wyolum/halo/README.md

# halo
Desktop Edge-lit portrait stand.
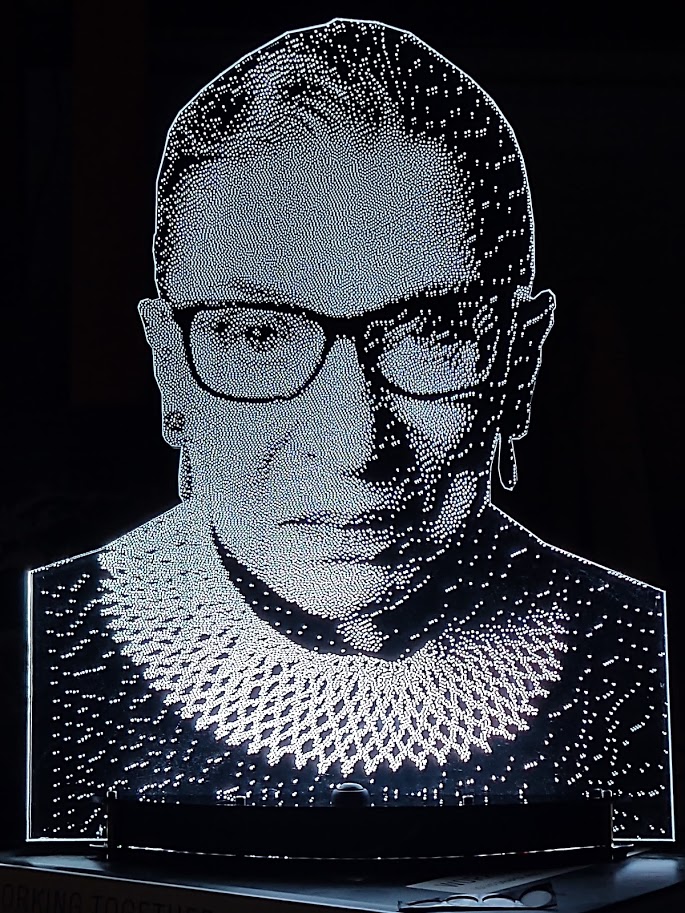
[picture p1: data/IMG_20200928_210512119.jpg]
Image of Halo

[Instructions:](https://wyolum.com/how-to-edge-lit-portrait-work-in-progress/)
