wyolum/halo/data/BARREL_JACK_1811141816_XKB-Connectivity-DC-005-5A-2-5-SMT_C319133.pdf

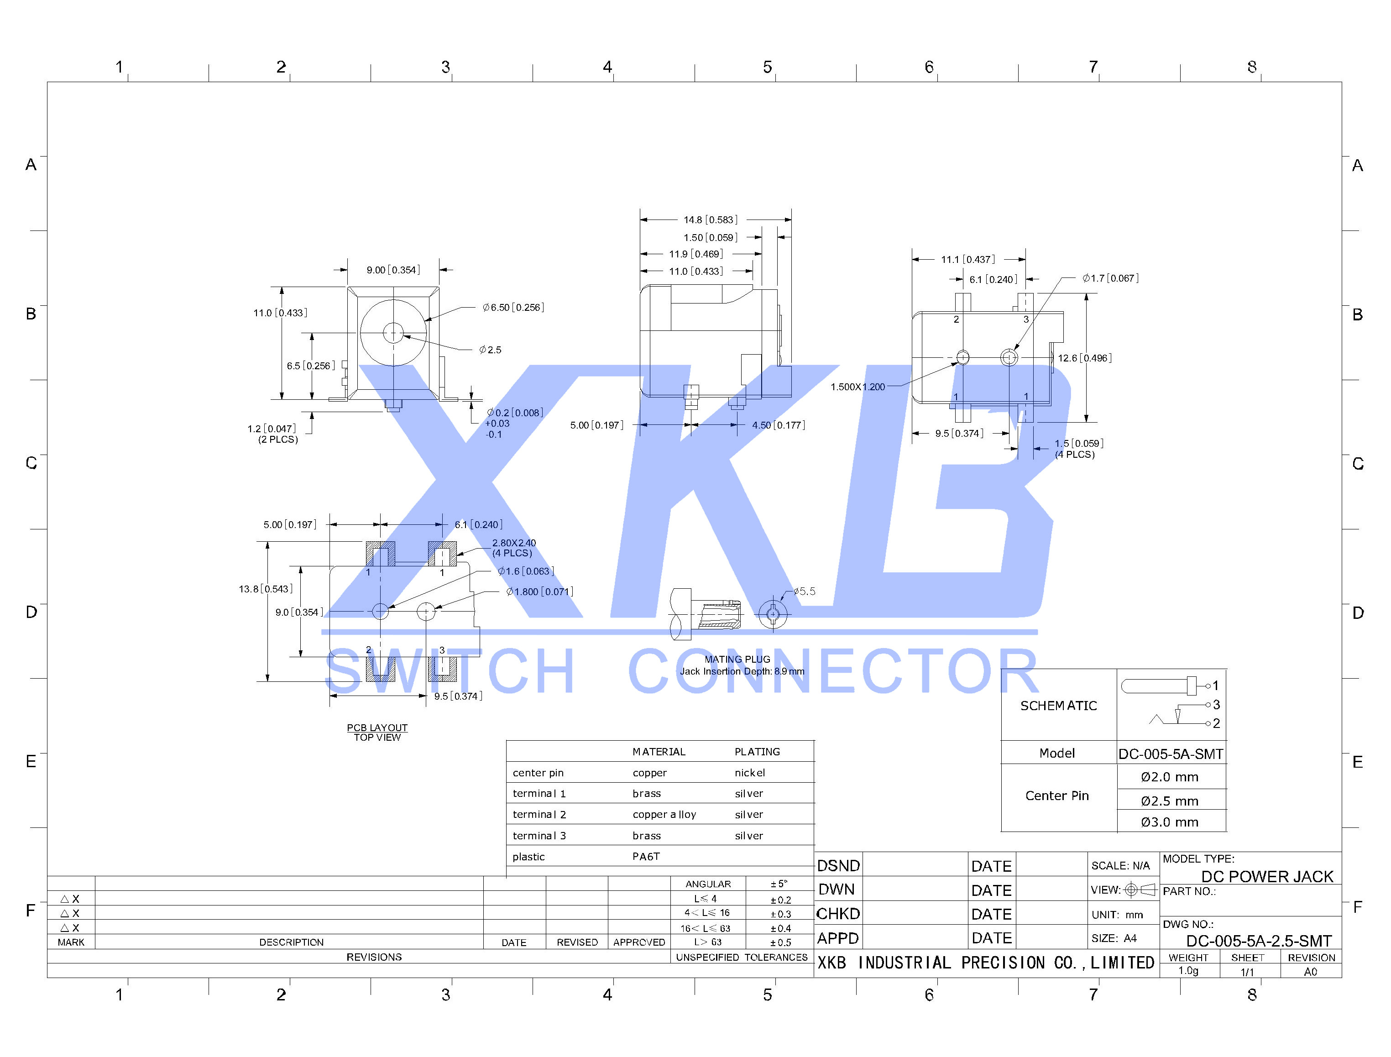
[picture p2: page 1]
