wyolum/halo/data/USB_C_2002271815_XKB-Connectivity-U262-241N-4BV64_C388660.pdf

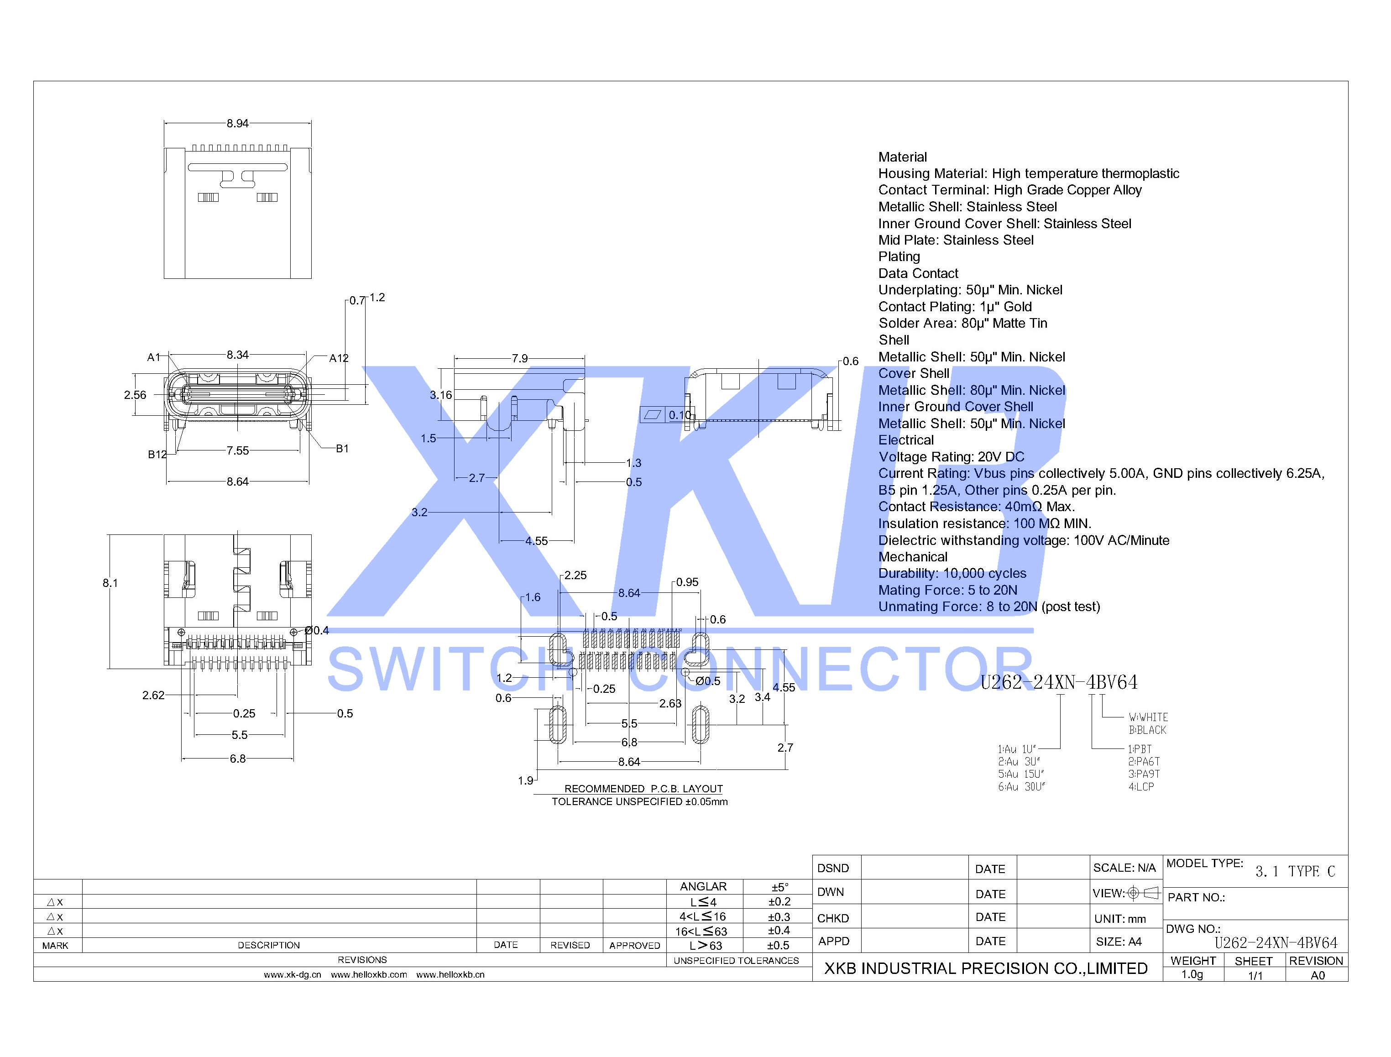
[picture p3: page 1]
