wyolum/halo/images/IMG_20200927_095507180_HDR.jpg

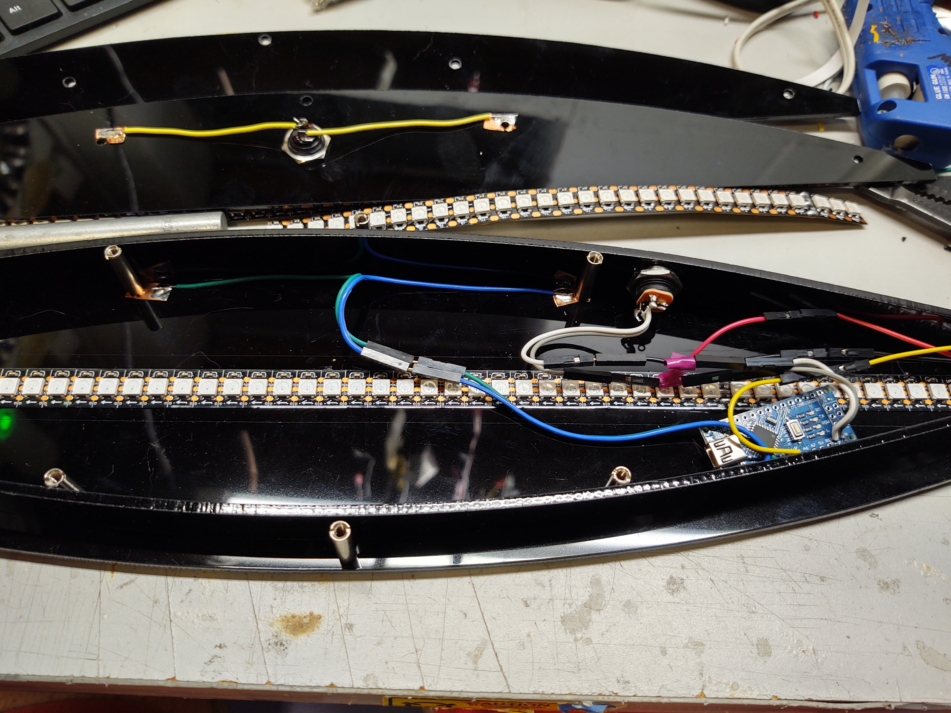
images/IMG_20200927_095507180_HDR.jpg
