wyolum/halo/images/IMG_20200927_095513719.jpg

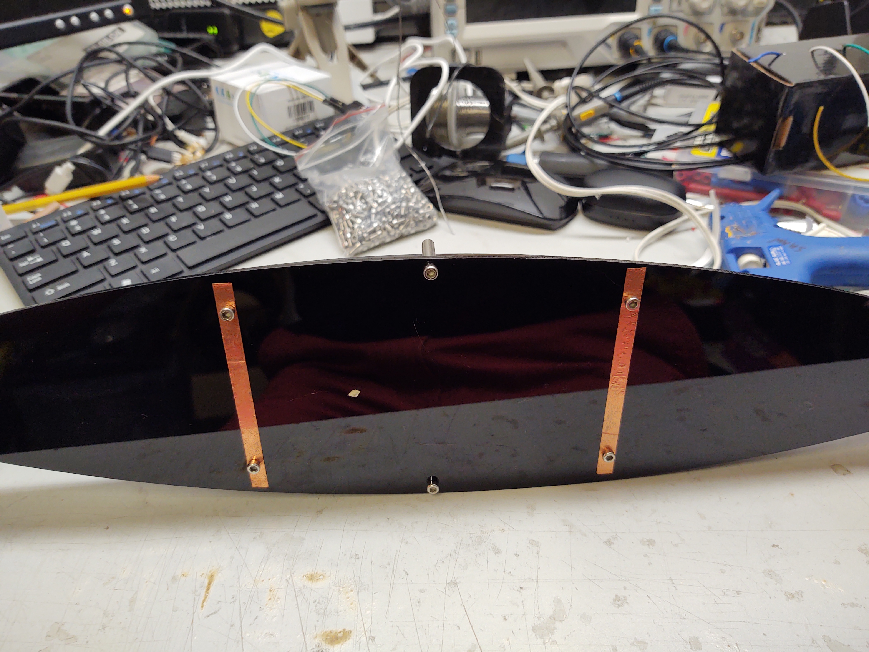
images/IMG_20200927_095513719.jpg
