wyolum/halo/images/IMG_20200927_095514592.jpg

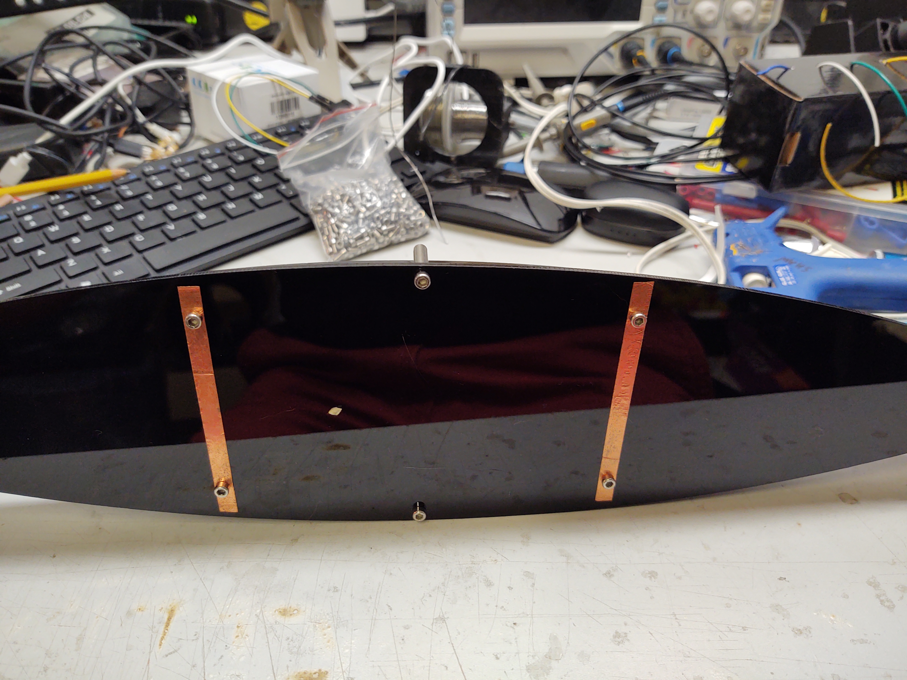
images/IMG_20200927_095514592.jpg
