wyolum/halo/images/IMG_20200927_181427206_HDR.jpg

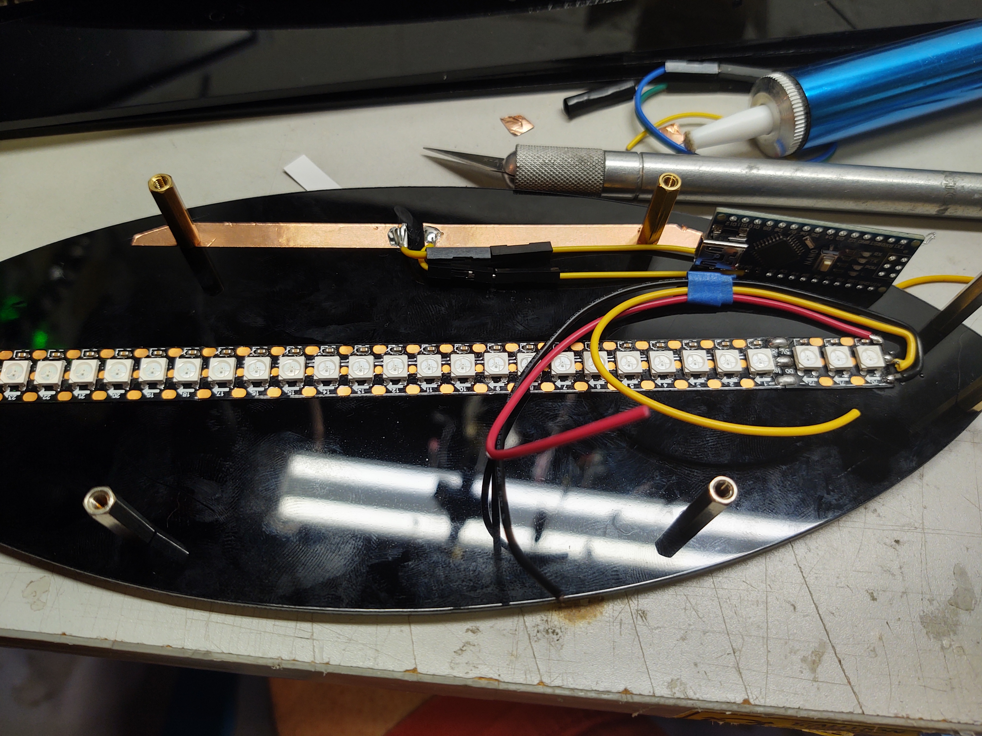
images/IMG_20200927_181427206_HDR.jpg
