wyolum/halo/images/IMG_20200927_194747053_HDR.jpg

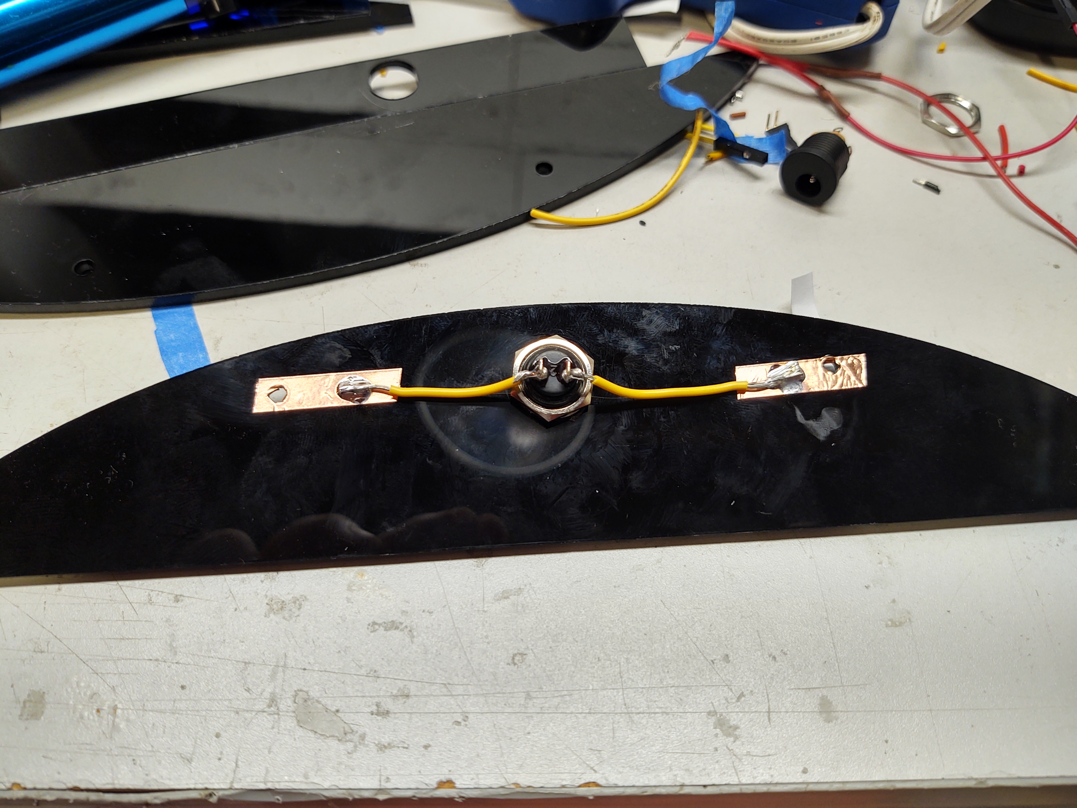
images/IMG_20200927_194747053_HDR.jpg
