wyolum/halo/images/IMG_20201009_095709288_HDR.jpg

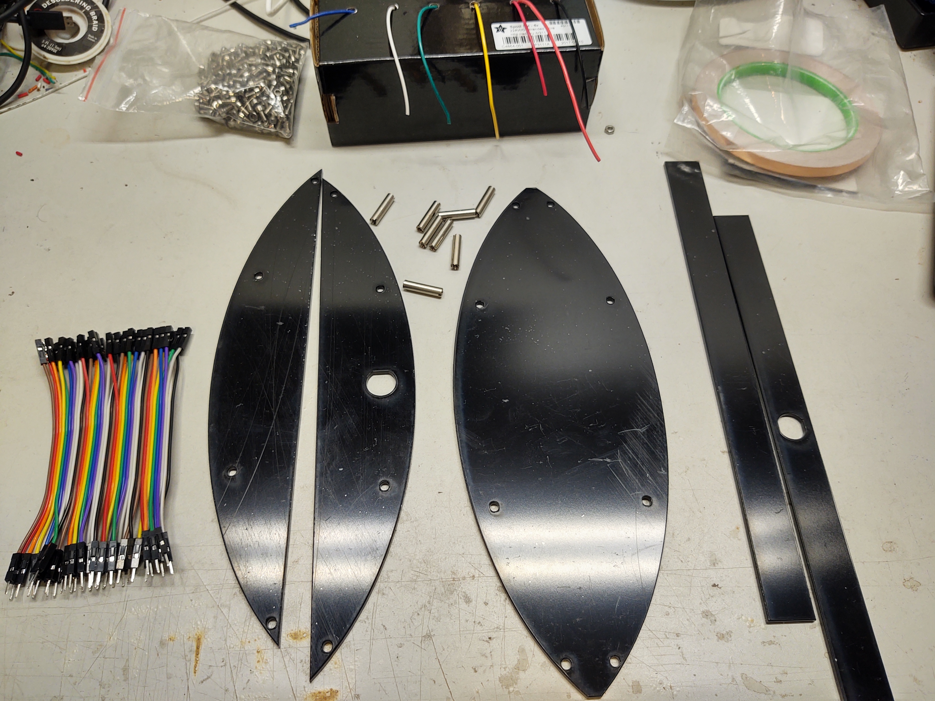
images/IMG_20201009_095709288_HDR.jpg
