wyolum/halo/images/IMG_20201009_100527796_HDR.jpg

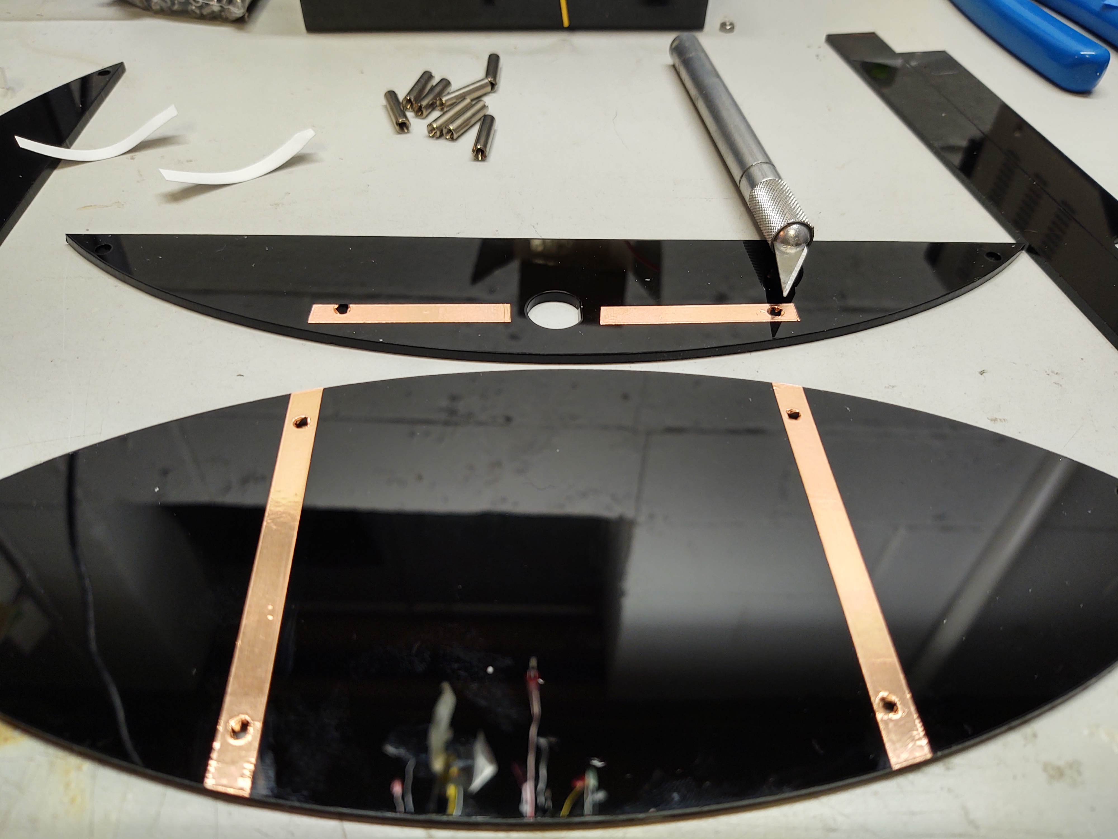
images/IMG_20201009_100527796_HDR.jpg
