wyolum/halo/images/IMG_20201009_101521324_HDR.jpg

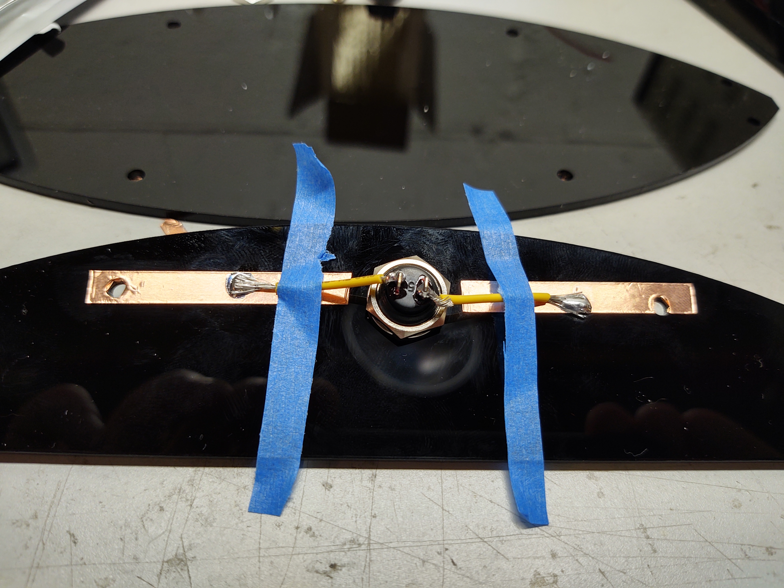
images/IMG_20201009_101521324_HDR.jpg
