wyolum/halo/images/IMG_20201009_102646859.jpg

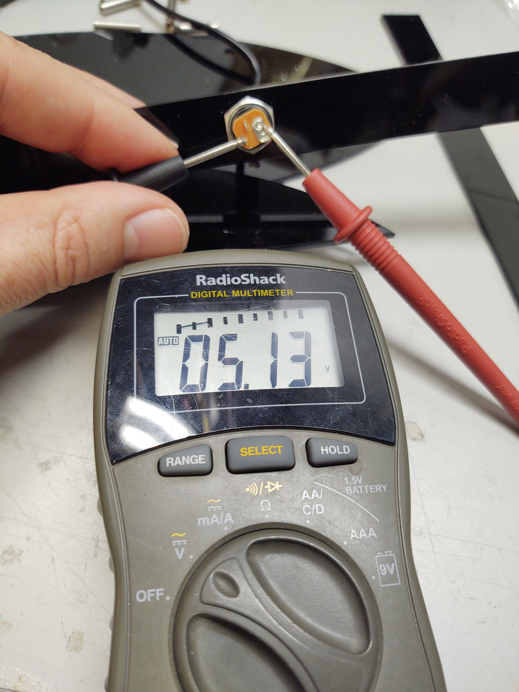
images/IMG_20201009_102646859.jpg
