wyolum/halo/images/IMG_20201009_103726629_HDR.jpg

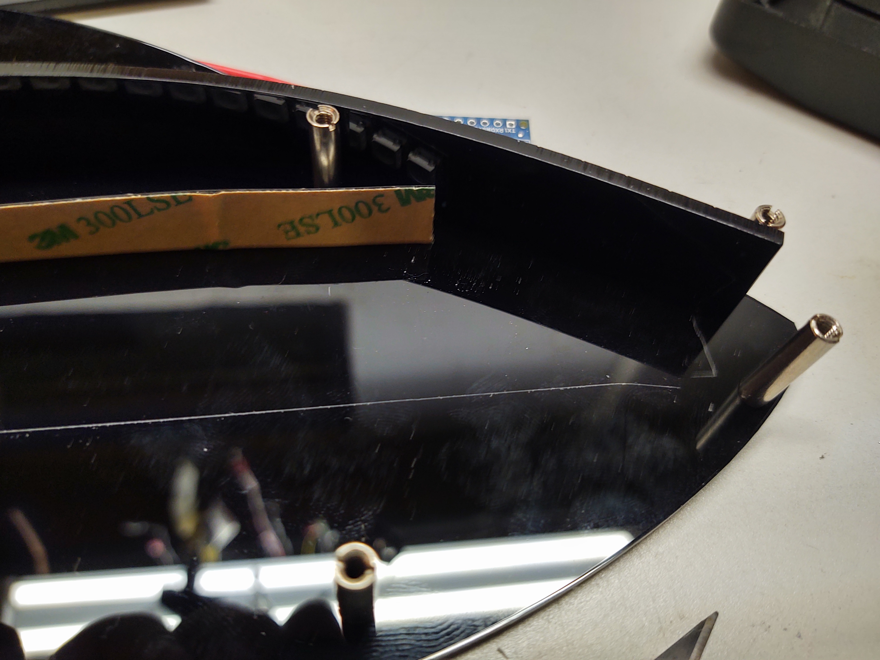
images/IMG_20201009_103726629_HDR.jpg
