wyolum/halo/images/IMG_20201009_103839048_HDR.jpg

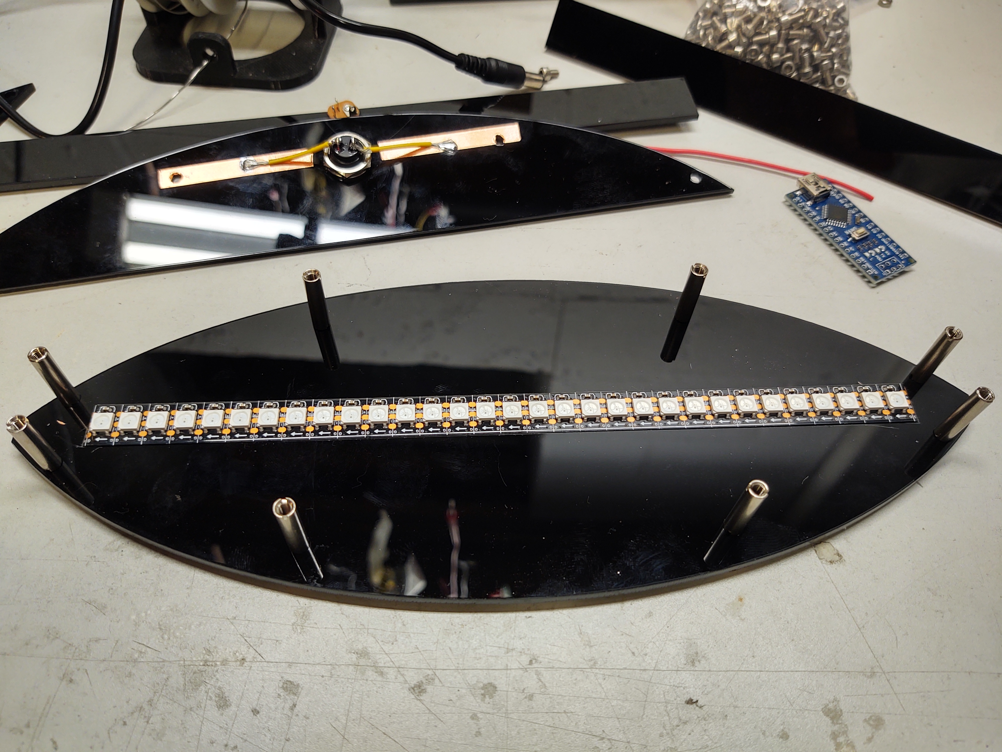
images/IMG_20201009_103839048_HDR.jpg
