wyolum/halo/images/IMG_20201009_105753147_HDR.jpg

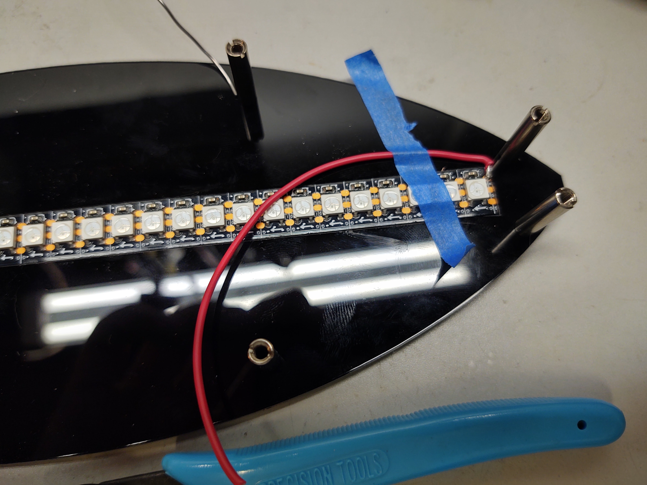
images/IMG_20201009_105753147_HDR.jpg
