wyolum/halo/images/IMG_20201009_110624503_HDR.jpg

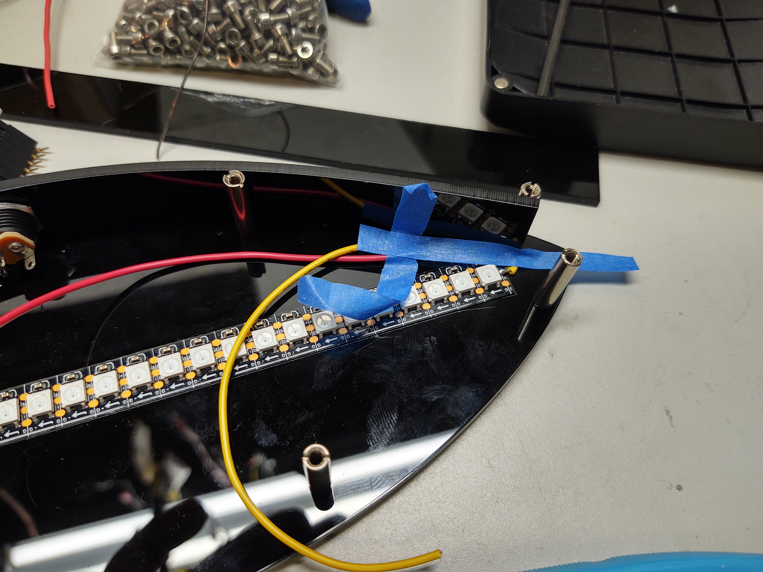
images/IMG_20201009_110624503_HDR.jpg
