wyolum/halo/images/IMG_20201009_110908093_HDR.jpg

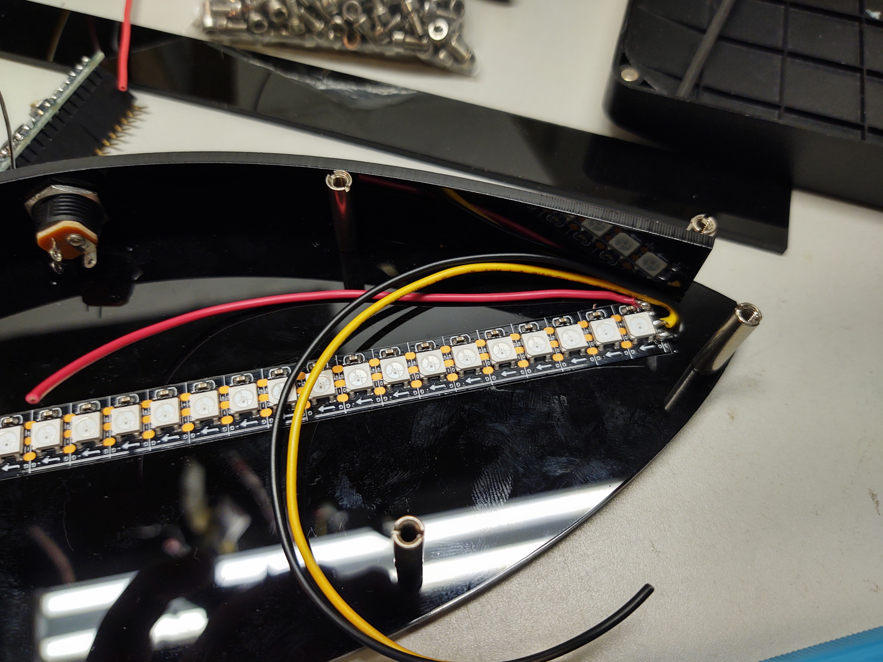
images/IMG_20201009_110908093_HDR.jpg
