wyolum/halo/images/IMG_20201009_114156640_HDR.jpg

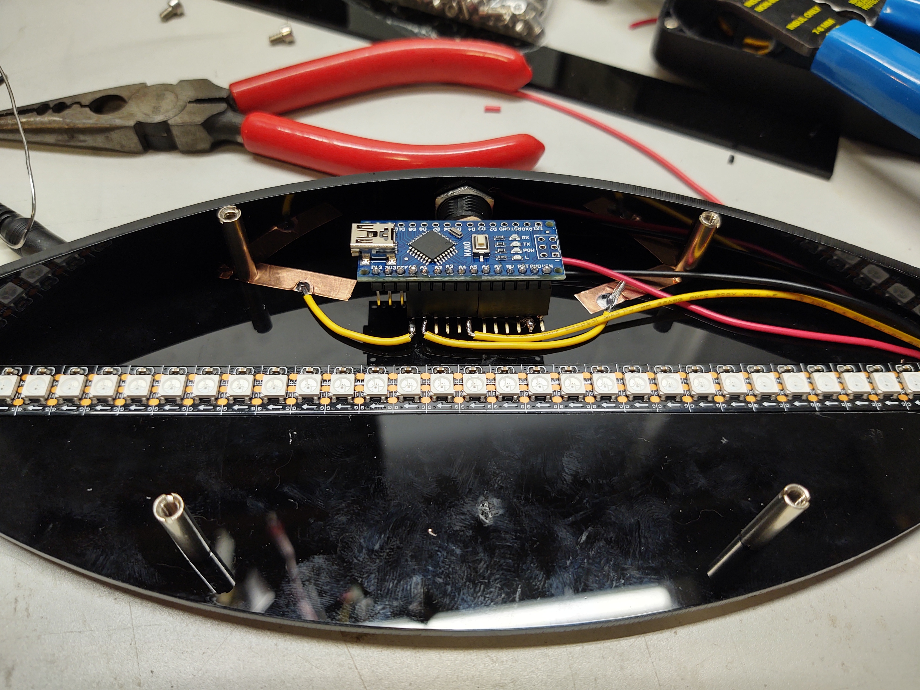
images/IMG_20201009_114156640_HDR.jpg
