wyolum/halo/images/IMG_20201009_114411816_HDR.jpg

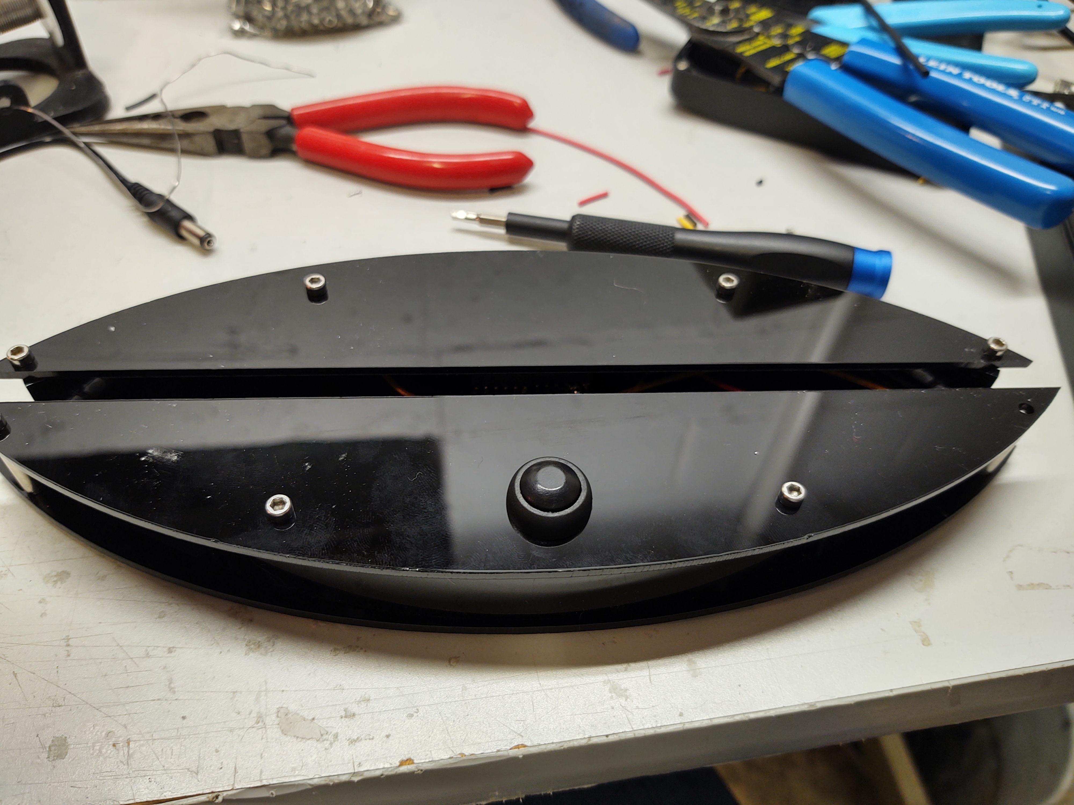
images/IMG_20201009_114411816_HDR.jpg
