wyolum/halo/images/IMG_20201009_115341393.jpg

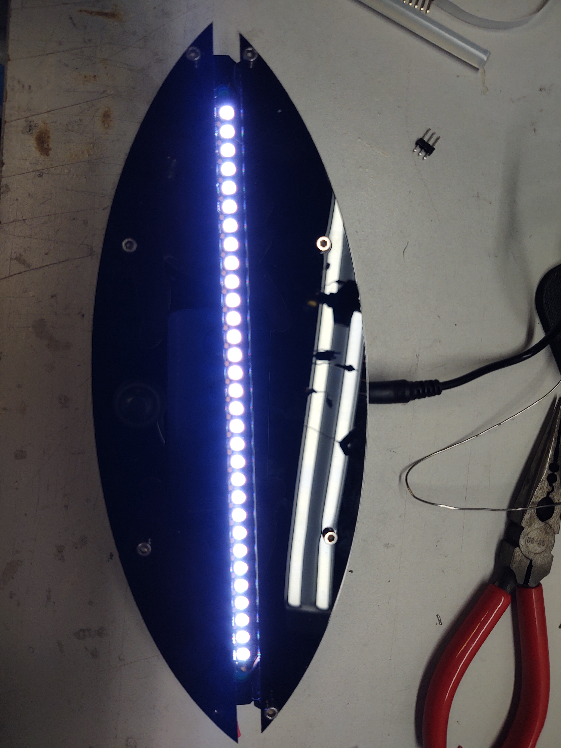
images/IMG_20201009_115341393.jpg
