wyolum/halo/images/IMG_20201009_145817242.jpg

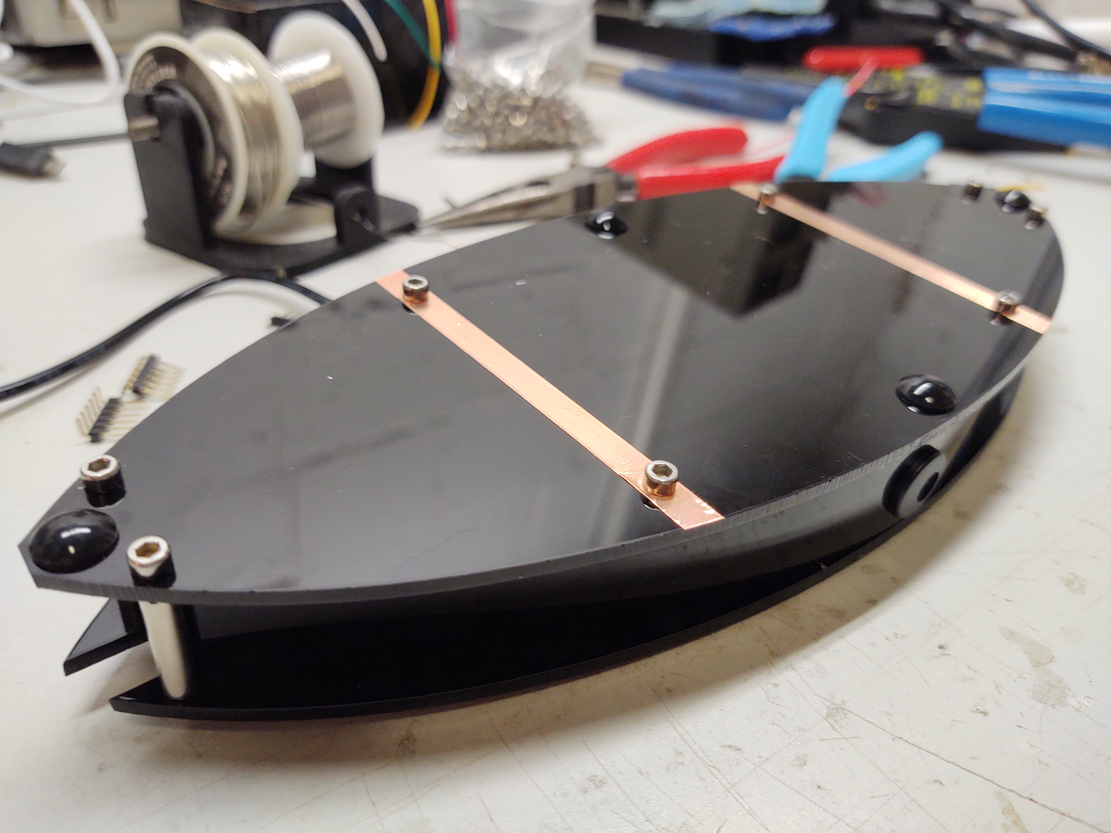
images/IMG_20201009_145817242.jpg
