wyolum/halo/images/IMG_20201009_145818878.jpg

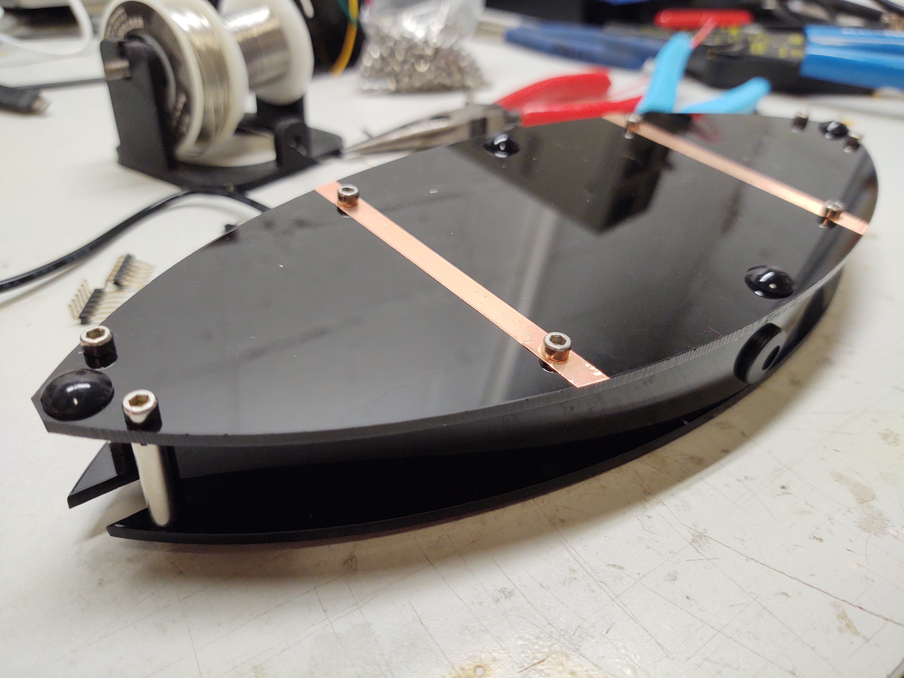
images/IMG_20201009_145818878.jpg
