wyolum/halo/images/IMG_20201010_164702471_HDR.jpg

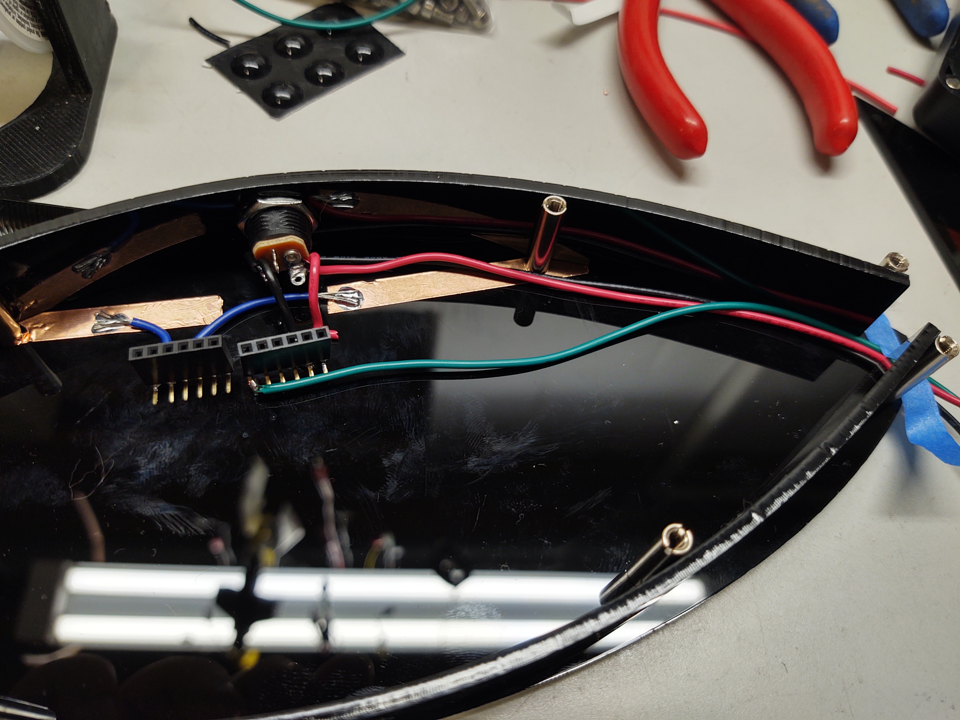
images/IMG_20201010_164702471_HDR.jpg
