wyolum/halo/images/IMG_20201010_165921804_HDR.jpg

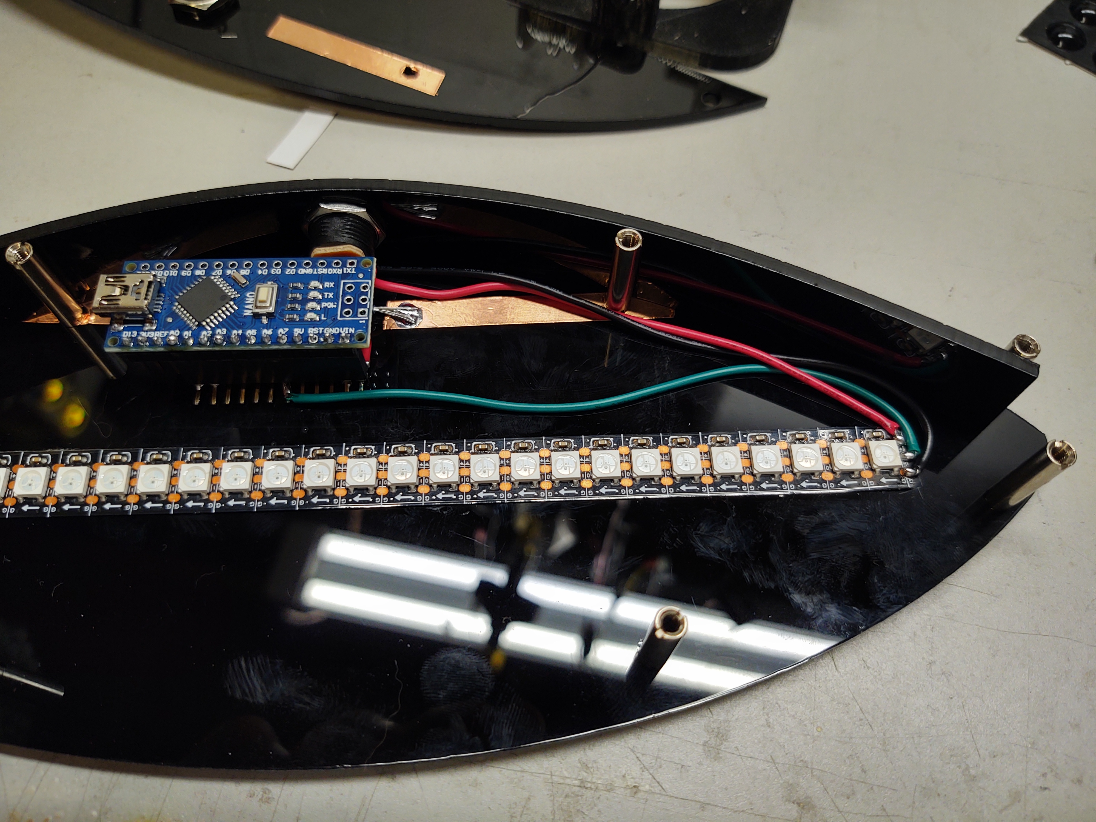
images/IMG_20201010_165921804_HDR.jpg
