wyolum/halo/images/PXL_20200929_154809385.jpg

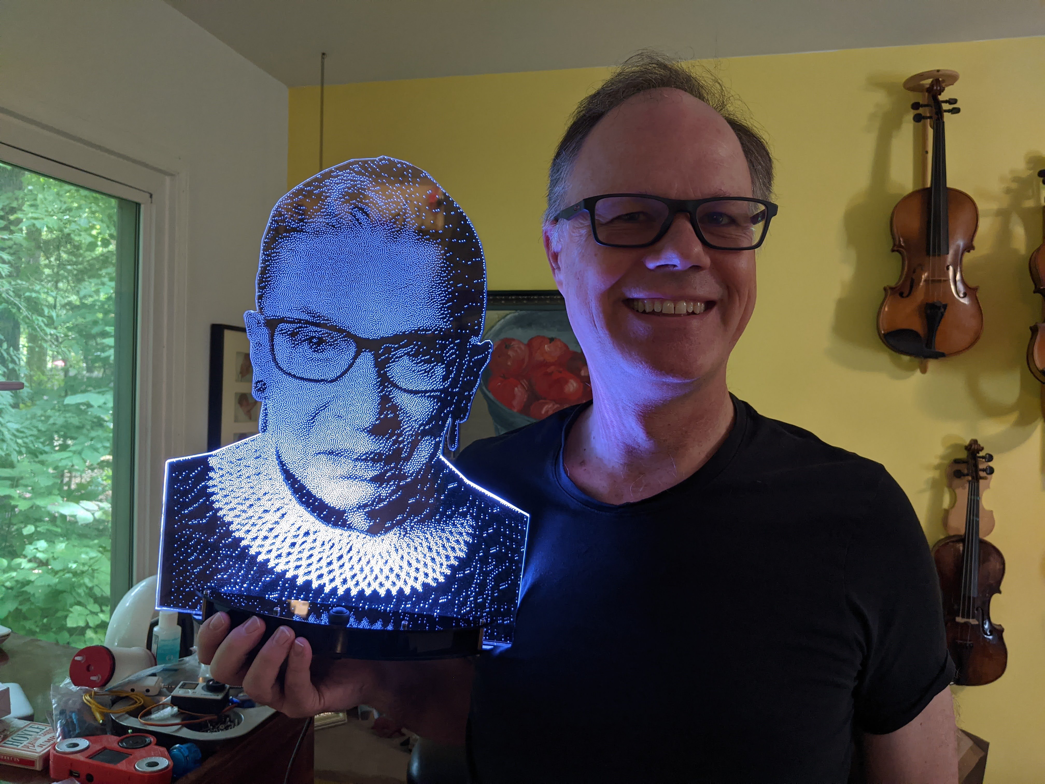
images/PXL_20200929_154809385.jpg
