wyolum/halo/kicad_v3/renders/halo_v2_01.png

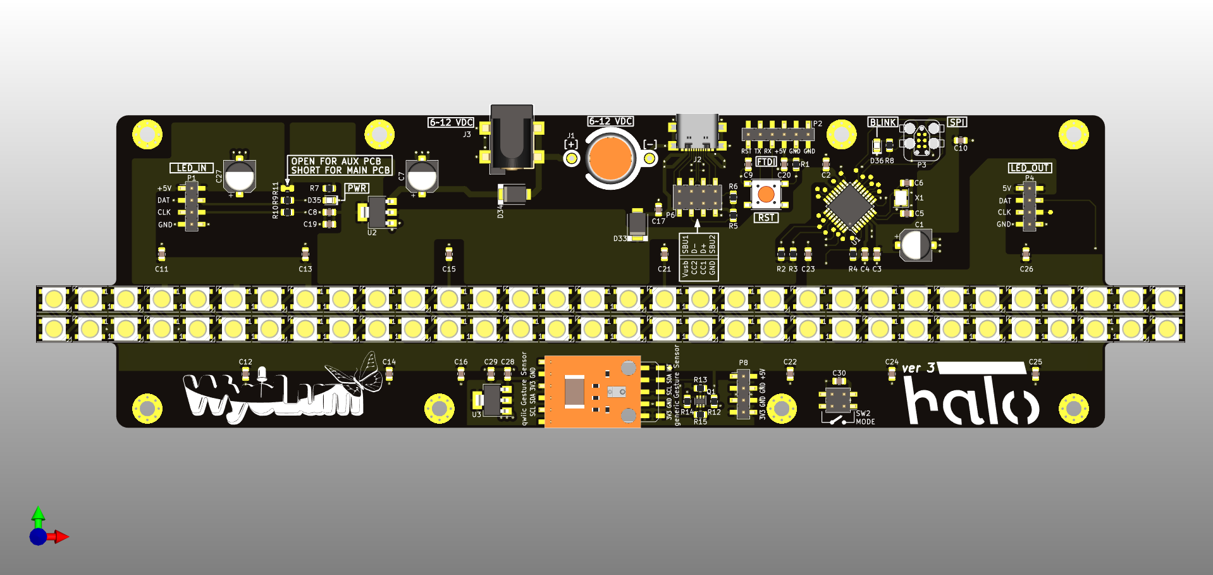
kicad_v3/renders/halo_v2_01.png
