wyolum/halo/kicad_v3/renders/halo_v2_03.png

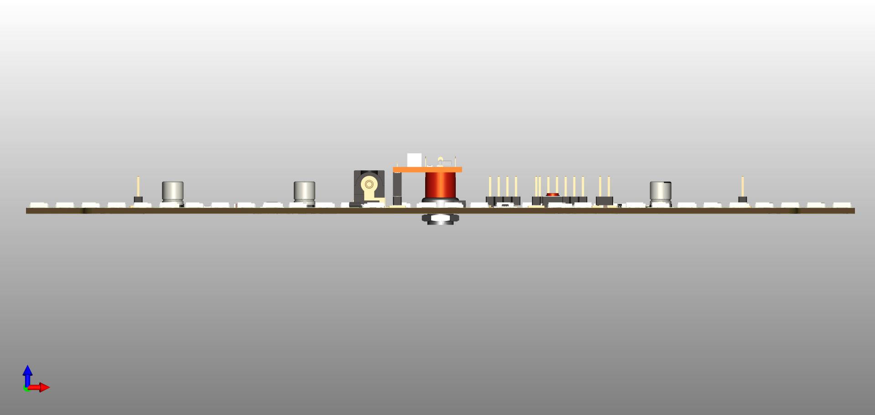
kicad_v3/renders/halo_v2_03.png
