wyolum/halo/kicad_v3/renders/halo_v2_04.png

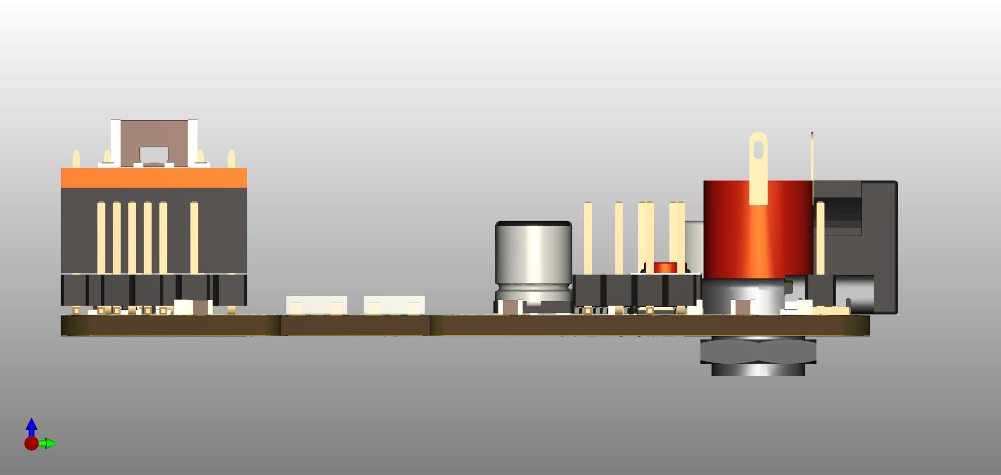
kicad_v3/renders/halo_v2_04.png
