wyolum/halo/kicad_v3/renders/halo_v2_07.png

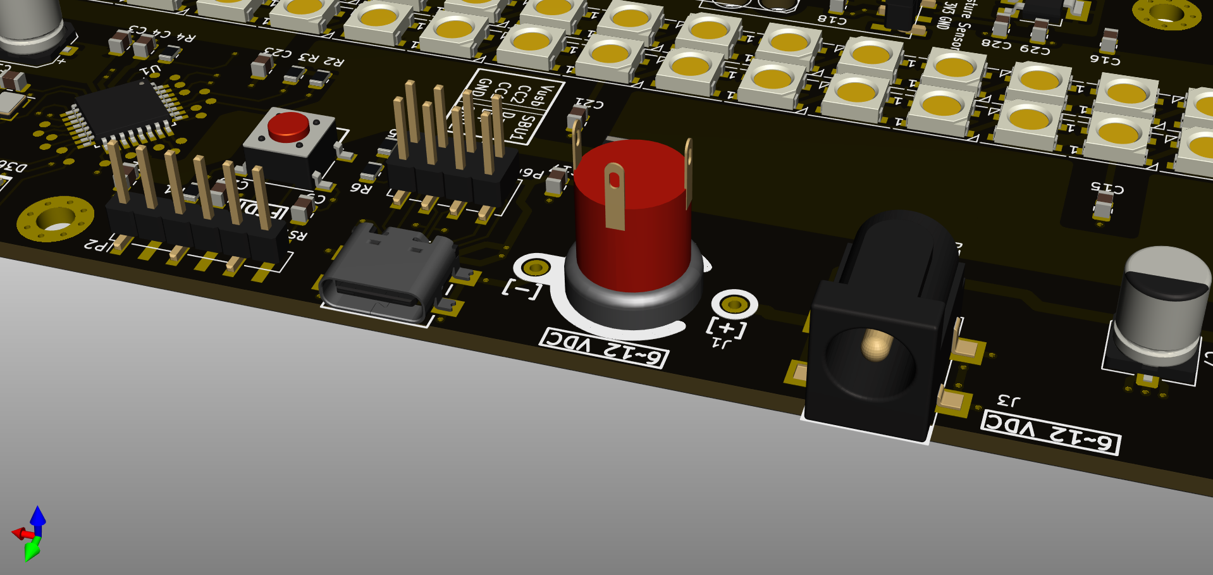
kicad_v3/renders/halo_v2_07.png
