wyolum/halo/kicad_v3/renders/halo_v2_08.png

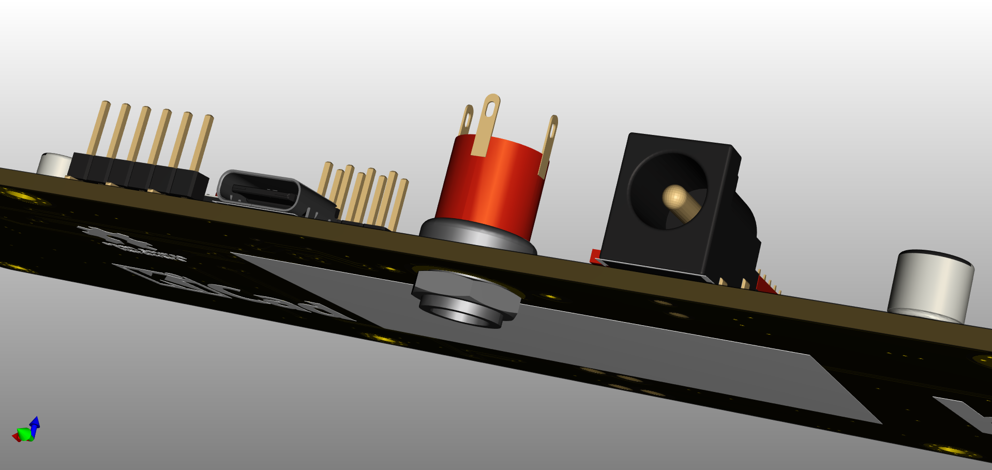
kicad_v3/renders/halo_v2_08.png
