wyolum/halo/kicad_v3/halo_v3_BoM.xlsx

Id | Comment | Designator | Footprint | LCSC Part # | Supplier Ref | Quantity
1 | 100uF ±20% 35V SMD,6.3x7.7mm Aluminum Electrolytic Capacitors - SMD RoHS | C1, C7, C27 | SMD,6.3x7.7mm | C176666 (https://lcsc.com/product-detail/Aluminum-Electrolytic-Capacitors-SMD_Lelon-VEJ101M1VTR-0607_C176666.html) | VEJ101M1VTR-0607 | 3
2 | 100nF ±10% 50V X7R 0805 Multilayer Ceramic Capacitors MLCC - SMD/SMT RoHS | C2, C9, C10, C11, C12, C13, C14, C15, C16, C17, C18, C19, C20, C21, C22, C23, C24, C25, C26, C28, C29, C30 | C_0805_2012Metric | C49678 (https://lcsc.com/product-detail/Multilayer-Ceramic-Capacitors-MLCC-SMD-SMT_100nF-104-10-50V_C49678.html/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) | CC0805KRX7R9BB104 | 22
3 | 1uF ±10% 50V X7R 0805 Multilayer Ceramic Capacitors MLCC - SMD/SMT RoHS | C3, C4, C8 | C_0805_2012Metric | C28323 (https://lcsc.com/product-detail/Multilayer-Ceramic-Capacitors-MLCC-SMD-SMT_SAMSUNG_CL21B105KBFNNNE_1uF-105-10-50V_C28323.html/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) | CL21B105KBFNNNE | 3
4 | 20pF ±5% 50V C0G 0805 Multilayer Ceramic Capacitors MLCC - SMD/SMT RoHS | C5, C6 | C_0805_2012Metric | C1798 (https://lcsc.com/product-detail/Multilayer-Ceramic-Capacitors-MLCC-SMD-SMT_SAMSUNG_CL21C200JBANNNC_20pF-200-5-50V_C1798.html/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) | CL21C200JBANNNC | 2
5 | RGB 620~630nmRed,515~530nmGreen,465~475nmBlue SMD,5x5mm Light Emitting Diodes (LED) RoHS | D1-32, D37-68 | PLCC4_5.0x5.0mm_P3.2mm | C114586 (https://lcsc.com/product-detail/Light-Emitting-Diodes-LED_5050-RGBIntegrated-Light-4Pin_C114586.html) | WS2812B-B | 64
6 | 40V 2A 430mV @ 2A SMB(DO-214AA) Schottky Barrier Diodes (SBD) RoHS | D33, D34 | SMB (DO-214AA) | C8165 (https://lcsc.com/product-detail/Schottky-Barrier-Diodes-SBD_ON-Semicon_MBRS240LT3G_ON-Semicon-ON-MBRS240LT3G_C8165.html/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) | MBRS240LT3G | 2
7 | Yellow 592~594nm 0805 Light Emitting Diodes (LED) RoHS | D35, D36 | 0805_2012Metric | C2296 (https://lcsc.com/product-detail/Light-Emitting-Diodes-LED_Yellow-light-0805-Highlighted_C2296.html/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) | 17-21SUYC/TR8 | 2
8 | MOSFET 2 N CHANNEL(DUAL) 60V 230MA 2V @ 250UA 7.5 ? @ 50MA,5V SOT-363 ROHS | Q1 | SOT-363 | C83571 (https://lcsc.com/product-detail/MOSFET_Diodes-Incorporated_2N7002DW-7-F_Diodes-Incorporated-2N7002DW-7-F_C83571.html/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) | 2N7002DW-7-F | 1
9 | 10kΩ ±1% 0.125W ±100ppm/℃ 0805 Chip Resistor - Surface Mount RoHS | R1, R2, R3, R4, R12, R13, R14, R15 | 0805_2012Metric | C17414 (https://lcsc.com/product-detail/Chip-Resistor-Surface-Mount_Uniroyal-Elec-0805W8F1002T5E_C17414.html/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) | 0805W8F1002T5E | 8
10 | 5.11kΩ ±1% 0.125W ±100ppm/℃ 0805 Chip Resistor - Surface Mount RoHS | R5, R6 | 0805_2012Metric | C46039 (https://lcsc.com/product-detail/Chip-Resistor-Surface-Mount_Uniroyal-Elec-0805W8F5111T5E_C46039.html/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) | 0805W8F5111T5E | 2
11 | 1kΩ ±1% 0.125W ±100ppm/℃ 0805 Chip Resistor - Surface Mount RoHS | R7, R8 | 0805_2012Metric | C17513 (https://lcsc.com/product-detail/Chip-Resistor-Surface-Mount_Uniroyal-Elec-0805W8F1001T5E_C17513.html/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) | 0805W8F1001T5E | 2
12 | 220Ω ±1% 0.125W ±100ppm/℃ 0805 Chip Resistor - Surface Mount RoHS | R9, R10 | 0805_2012Metric | C17557 (https://lcsc.com/product-detail/Chip-Resistor-Surface-Mount_Uniroyal-Elec-0805W8F2200T5E_C17557.html/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) | 0805W8F2200T5E | 2
13 | SPST 50mA @ 50VDC Vertical Round Button SMD,6x6mm Tactile Switches RoHS | SW1 | SMD, 6x6mm, H9.5mm | C273519 (https://lcsc.com/product-detail/Tactile-Switches_E-Switch-TL3301AF160QG_C273519.html/?href=jlc-SMT) | TL3301AF160QG | 1
14 | 8-Bit FLASH AVR 20MHz 1.8V ~ 5.5V TQFP-32_7x7x08P ATMEL & AVR RoHS | U1 | TQFP-32_7x7x08P | C14877 (https://lcsc.com/product-detail/ATMEL-AVR_ATMEL_ATMEGA328P-AU_ATMEGA328P-AU_C14877.html/?href=jlc-SMT) | ATMEGA328P-AU | 1
15 | LOW DROPOUT REGULATORS(LDO) POSITIVE FIXED 1.3V @ 1A 15V 5V 1A SOT-223 ROHS | U2 | SOT-223 | C6187 (https://lcsc.com/product-detail/Low-Dropout-Regulators-LDO_AMS_AMS1117-5-0_AMS1117-5-0_C6187.html/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) | AMS1117-5.0 | 1
16 | LOW DROPOUT REGULATORS(LDO) POSITIVE FIXED 1.3V @ 800MA 15V 3.3V 1A SOT-223 ROHS | U3 | SOT-223 | C6186 (https://lcsc.com/product-detail/Low-Dropout-Regulators-LDO_AMS_AMS1117-3-3_AMS1117-3-3_C6186.html/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) | AMS1117-3.3 | 1
17 | 16MHz ±10ppm 9pF 60Ω SMD-3225_4P SMD Crystal Resonators RoHS | X1 | SMD-3225_4P | C13738 (https://lcsc.com/product-detail/SMD-Crystal-Resonators_Yangxing-Tech-X322516MLB4SI_C13738.html/?href=jlc-SMT) | X322516MLB4SI | 1
 | DIGIKEY PARTS
1 | Power Barrel Connector Jack 2.10mm ID (0.083"), 5.50mm OD (0.217") Chassis Mount | J1 | Panel mount | EJ501A-ND (https://www.digikey.com/en/products/detail/mpd-memory-protection-devices/EJ501A/2439531) | EJ501A | 1
2 | CONN USB 2.0 TYPE-C R/A SMT | J2 | SMD, right angle | 2073-USB4110-GF-A-1-ND (https://www.digikey.com/en/products/detail/gct/USB4110-GF-A/10384547) | USB4110-GF-A | 1
3 | Power Barrel Connector Jack 2.10mm ID (0.083"), 5.50mm OD (0.217") Surface Mount, Right Angle | J3 | Through hole barrel jack | 839-54-00164CT-ND (https://www.digikey.com/en/products/detail/tensility-international-corp/54-00164/10459298) | 54-00164 | 1
4 | Connector Header Surface Mount 4 position 0.100" (2.54mm) | P1, P4, P8 | PIN HEADER, SMT, SINGLE ROW, 0.10 | 1849-PM20204VBNN-ND (https://www.digikey.com/en/products/detail/metz-connect-usa-inc/PM20204VBNN/12342877) | PM20204VBNN | 3
5 | Connector Header Surface Mount 6 position 0.100" (2.54mm) | P2, P5 | CONN HEADER SMD 6POS 2.54MM | 609-10129380-906002ALFCT-ND (https://www.digikey.com/en/products/detail/amphenol-icc-fci/10129380-906002ALF/7916047) | 10129380-906002ALF | 2
6 | Connector Header Surface Mount 8 position 0.100" (2.54mm) | P6 | CONN HEADER SMD 8POS 2.54MM | 952-3262-ND (https://www.digikey.com/en/products/detail/harwin-inc/M20-8770842/3920090) | M20-8770842 | 1
7 | Connector Header Surface Mount 5 position 0.100" (2.54mm) | P7 | CONN HEADER SMD 5POS 2.54MM | 609-54201-S08-05ALFCT-ND (https://www.digikey.com/en/products/detail/amphenol-icc-fci/54201-S08-05ALF/5201157) | 54201-S08-05ALF | 1
8 | Connector Header Surface Mount 4 position 0.100" (2.54mm) | SW2 | CONN HEADER SMD 4POS 2.54MM | 952-3254-ND (https://www.digikey.com/en/products/detail/harwin-inc/M20-8760242/3919920) | M20-8760242 | 1
