wyolum/halo/fabricate_v2/laser_3D_files/ACR_main_2D.dxf

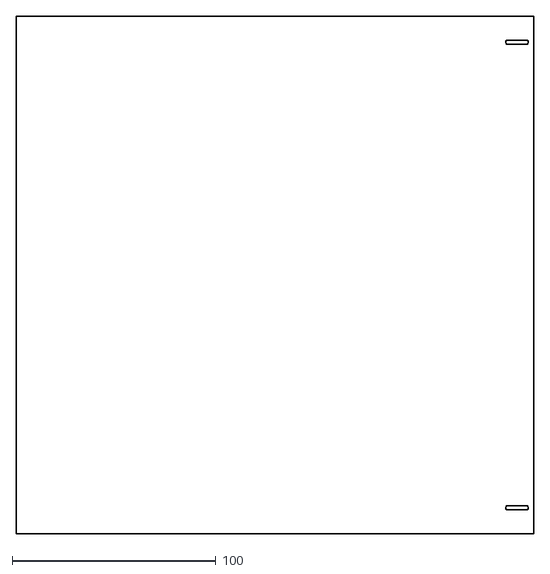
[picture p35: CAD file, 2021-02-07]
fabricate_v2/laser_3D_files/ACR_main_2D.dxf
254.0 x 254.0
