wyolum/halo/data/conn_barrel_50-00616.step

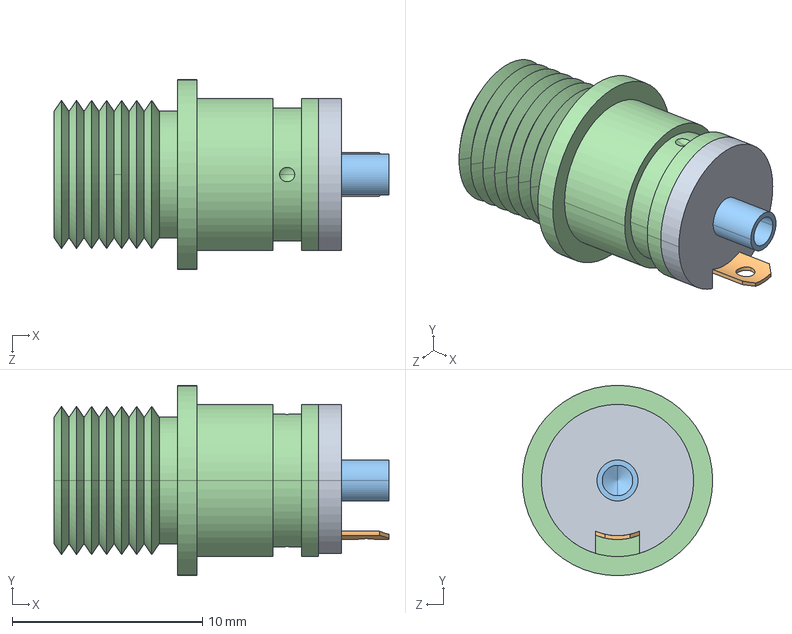
[picture p36: CAD file, 2020-12-13]
data/conn_barrel_50-00616.step
17.6 x 10.00 x 10.00 mm
50-00616 insulator
50-00616 ground terminal
50-00616 center terminal
50-00616 shell
