wyolum/halo/data/CUI_DEVICES_PJ-065B/CUI_DEVICES_PJ-065B.step

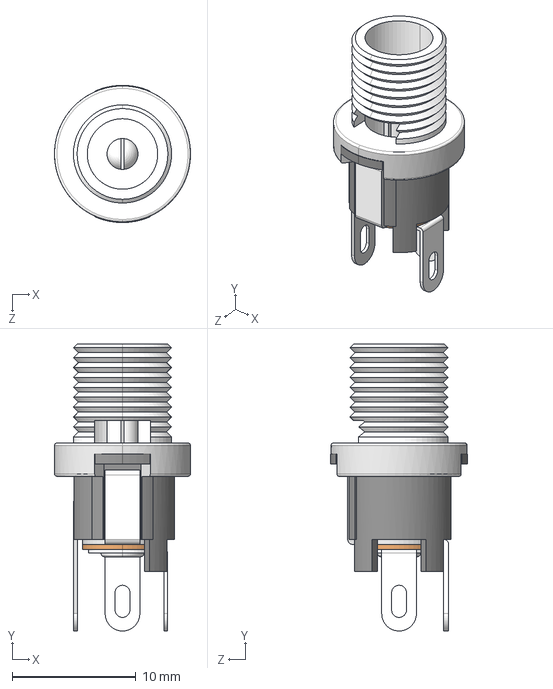
[picture p37: CAD file, 2020-12-13]
data/CUI_DEVICES_PJ-065B/CUI_DEVICES_PJ-065B.step
11.0 x 23.2 x 11.1 mm
