wyolum/halo/data/JAE_connectors/K3D-DX07S024JA1-V3-S/K3D-DX07S024JA1-V3_JAE_Proprietary.STEP

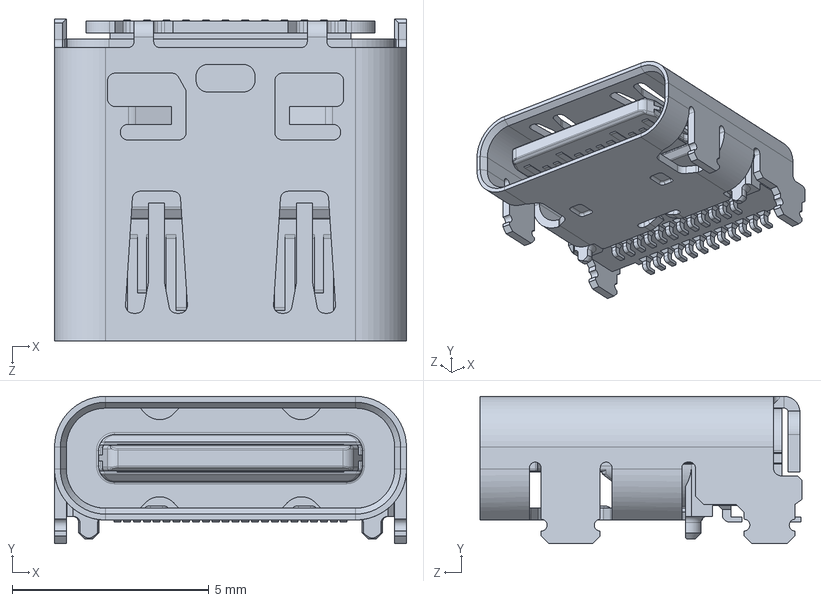
[picture p38: CAD file, 2020-11-03]
data/JAE_connectors/K3D-DX07S024JA1-V3-S/K3D-DX07S024JA1-V3_JAE_Proprietary.STEP
8.94 x 3.74 x 8.17 mm
