wyolum/halo/data/JAE_connectors/K3D-DX07S024JA2-V1_S/K3D-DX07S024JA2-V1_JAE_Proprietary.STEP

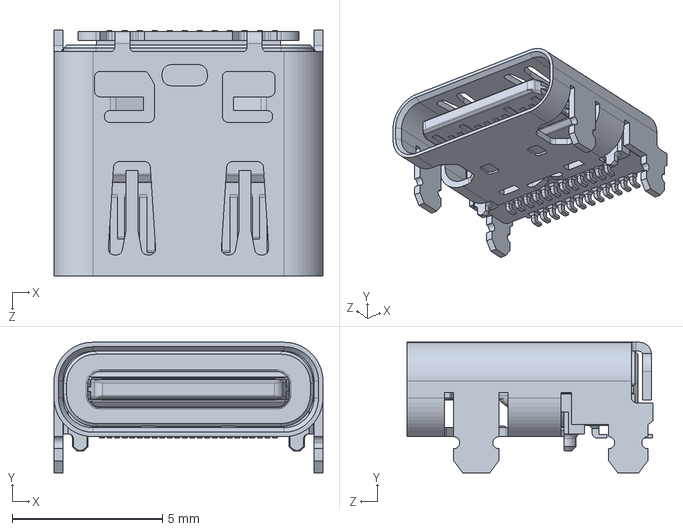
[picture p39: CAD file, 2020-11-03]
data/JAE_connectors/K3D-DX07S024JA2-V1_S/K3D-DX07S024JA2-V1_JAE_Proprietary.STEP
8.94 x 4.34 x 8.17 mm
