wyolum/halo/data/JAE_connectors/K3D-DX07S024JJ4-V1-S/K3D-DX07S024JJ4-V1_JAE_Proprietary.STEP

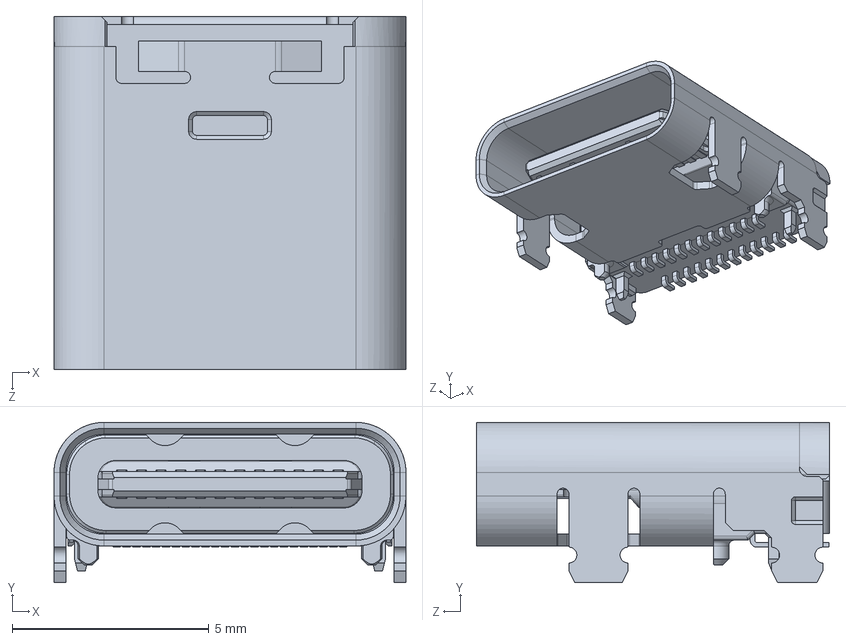
[picture p43: CAD file, 2020-11-03]
data/JAE_connectors/K3D-DX07S024JJ4-V1-S/K3D-DX07S024JJ4-V1_JAE_Proprietary.STEP
8.94 x 4.07 x 8.97 mm
