wyolum/halo/data/JAE_connectors/K3D-DX07S024JJ7-V1-S/K3D-DX07S024JJ7-V1_JAE_Proprietary.STEP

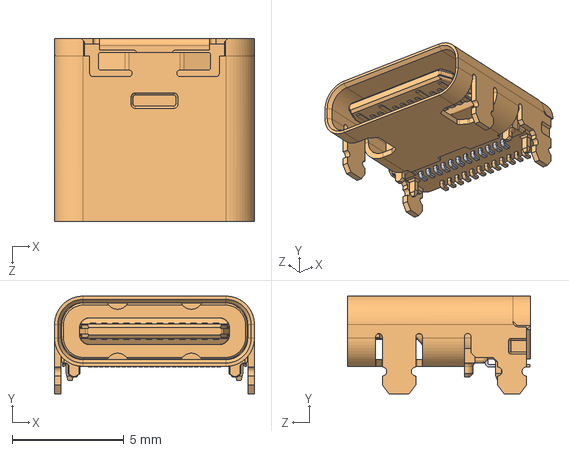
[picture p44: CAD file, 2020-11-03]
data/JAE_connectors/K3D-DX07S024JJ7-V1-S/K3D-DX07S024JJ7-V1_JAE_Proprietary.STEP
8.94 x 4.37 x 8.17 mm
