wyolum/halo/data/USB4110-GF-A/USB4110-GF-A.step

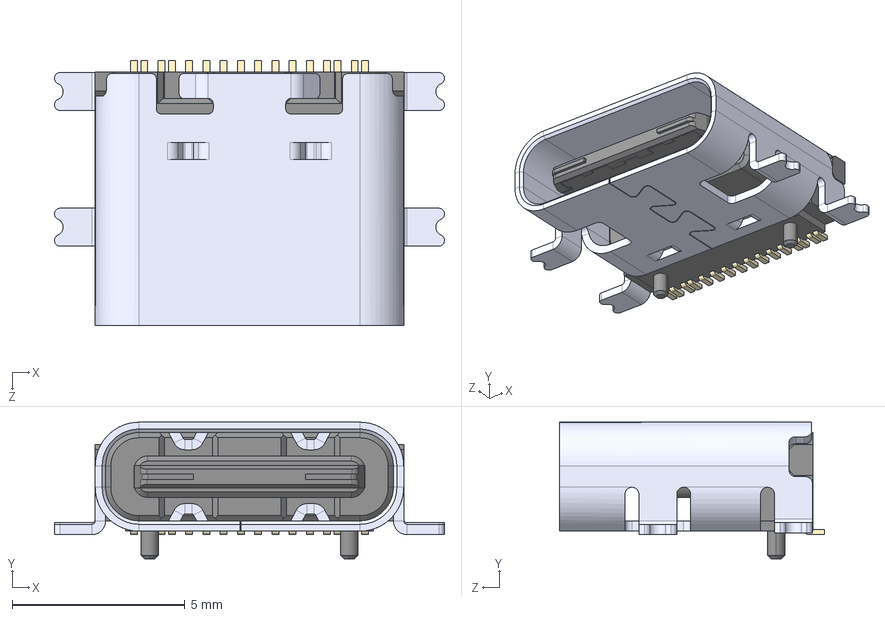
[picture p45: CAD file, 2020-11-05]
data/USB4110-GF-A/USB4110-GF-A.step
11.3 x 3.96 x 7.68 mm
