wyolum/halo/fabricate_v2/halo_v2_edges.dxf

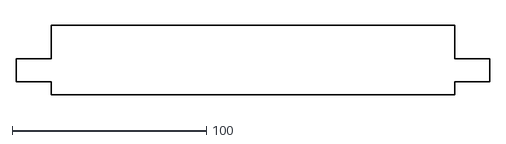
[picture p46: CAD file, 2020-12-10]
fabricate_v2/halo_v2_edges.dxf
243.8 x 35.6
