wyolum/halo/fabricate_v2/laser_3D_files/Corners_set_springy.stl

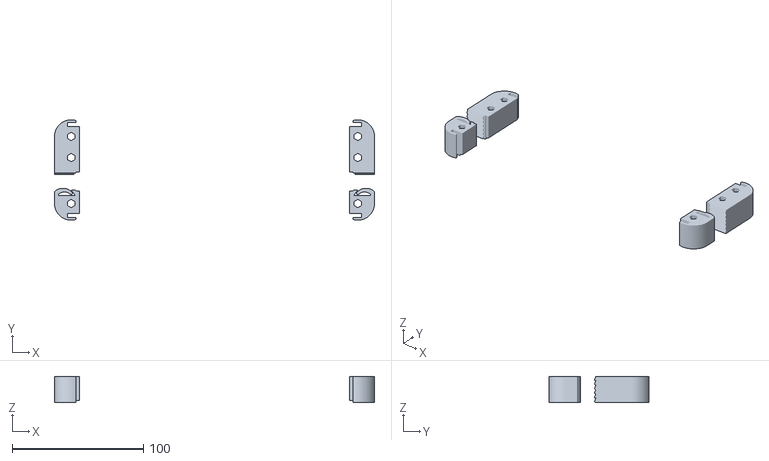
[picture p47: CAD file, 2021-02-07]
fabricate_v2/laser_3D_files/Corners_set_springy.stl
243.8 x 76.5 x 20.0
