wyolum/halo/kicad_v3/3d_packages/DC_JACK_163-MJ21-EX.step

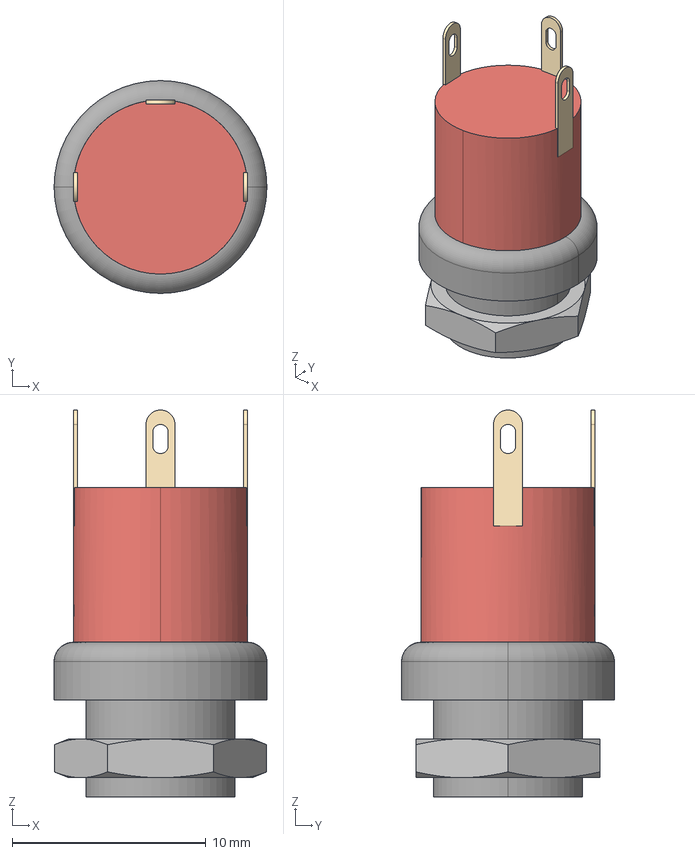
[picture p48: CAD file, 2020-12-30]
kicad_v3/3d_packages/DC_JACK_163-MJ21-EX.step
11.0 x 11.0 x 20.0 mm
