wyolum/halo/kicad_v3/3d_packages/Crystal_SMD_3225-4Pin_3.2x2.5mm.step

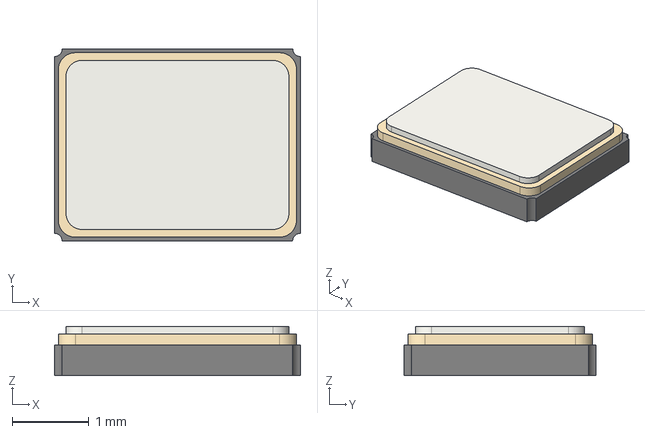
[picture p49: CAD file, 2020-12-13]
kicad_v3/3d_packages/Crystal_SMD_3225-4Pin_3.2x2.5mm.step
3.20 x 2.50 x 0.64 mm
