wyolum/halo/fabricate_v2/laser_3D_files/Corner_left_springy_wedge.stl

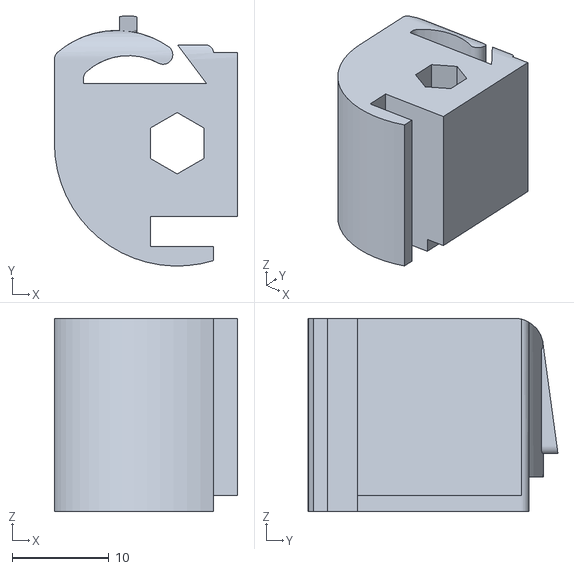
[picture p50: CAD file, 2021-02-07]
fabricate_v2/laser_3D_files/Corner_left_springy_wedge.stl
19.0 x 25.9 x 20.0
