wyolum/halo/kicad_v3/3d_packages/SW_SPST_PTS645.step

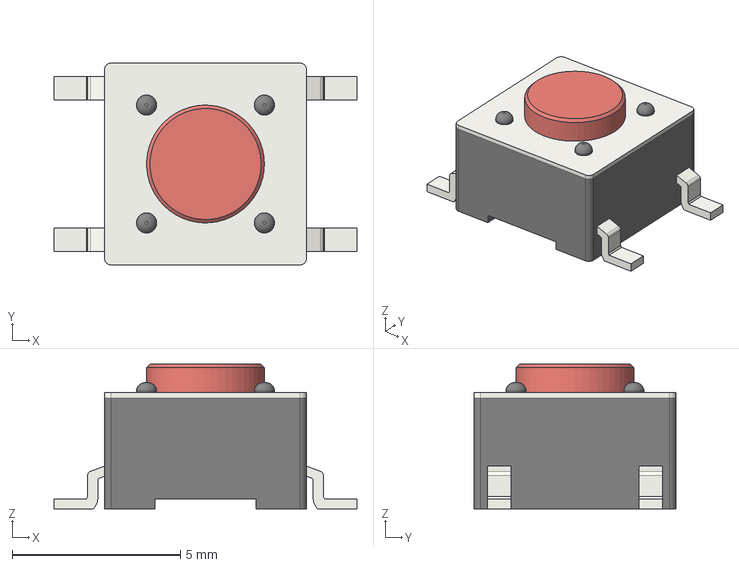
[picture p51: CAD file, 2020-12-13]
kicad_v3/3d_packages/SW_SPST_PTS645.step
9.00 x 6.00 x 4.30 mm
