wyolum/halo/fabricate_v2/laser_3D_files/Corners_set_springy_pair.stl

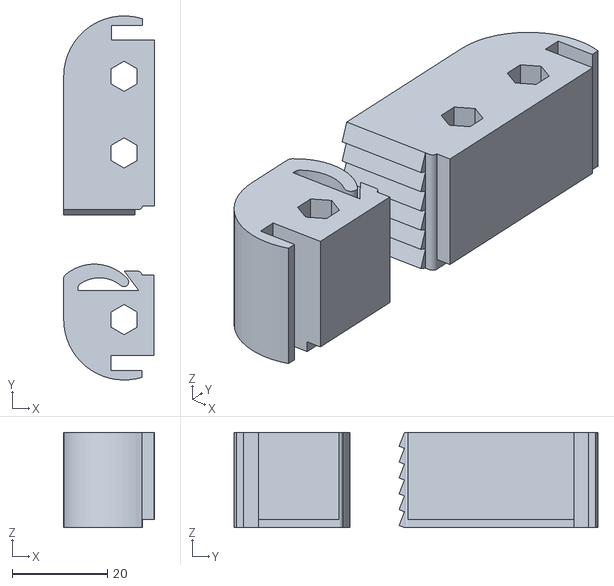
[picture p52: CAD file, 2021-02-07]
fabricate_v2/laser_3D_files/Corners_set_springy_pair.stl
19.0 x 76.5 x 20.0
