wyolum/halo/fabricate_v2/laser_3D_files/Corner_set_springy_wedge.stl

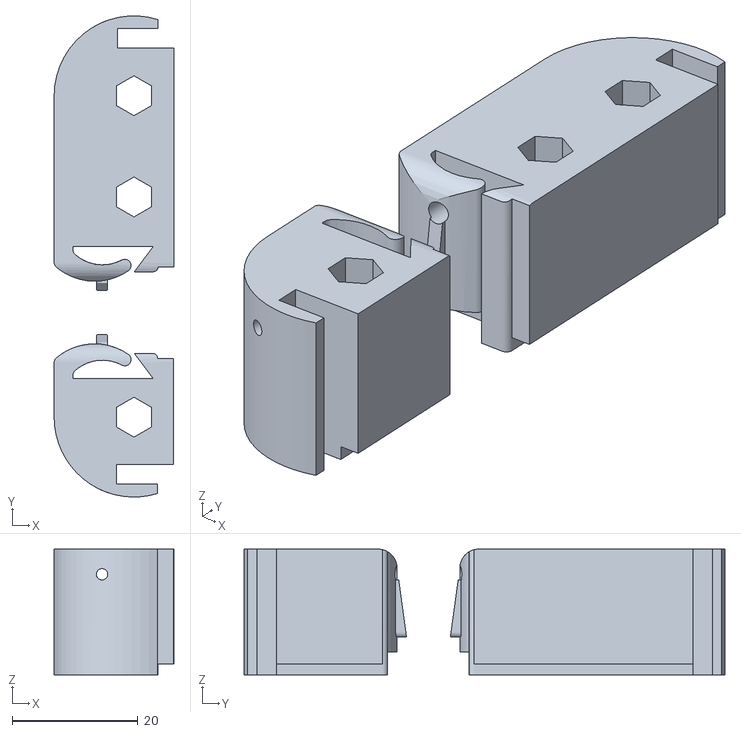
[picture p53: CAD file, 2021-02-07]
fabricate_v2/laser_3D_files/Corner_set_springy_wedge.stl
19.0 x 76.5 x 20.0
