wyolum/halo/kicad_v3/3d_packages/CP_Elec_6.3x7.7.step

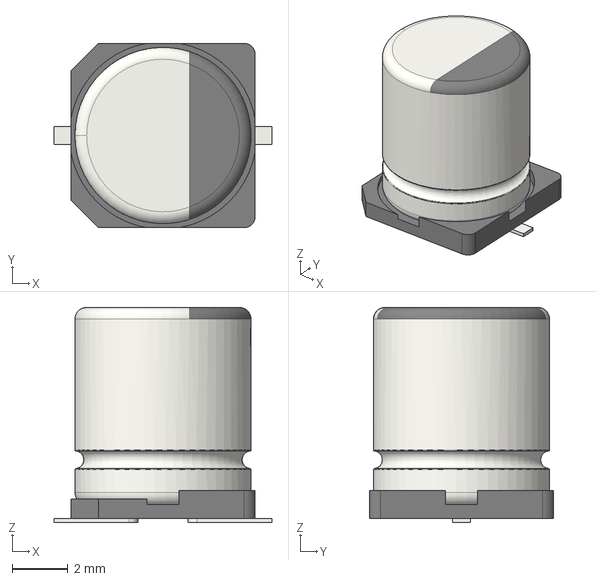
[picture p54: CAD file, 2020-12-13]
kicad_v3/3d_packages/CP_Elec_6.3x7.7.step
7.80 x 6.60 x 7.70 mm
