wyolum/halo/fabricate_v2/laser_3D_files/Corner_front_right.stl

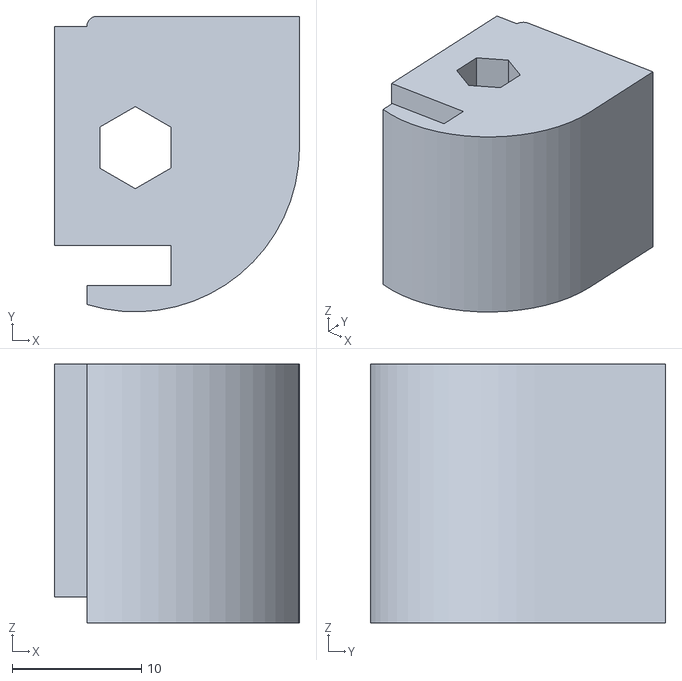
[picture p55: CAD file, 2020-12-17]
fabricate_v2/laser_3D_files/Corner_front_right.stl
19.0 x 22.9 x 20.0
