wyolum/halo/kicad_v3/3d_packages/D_SMB.step

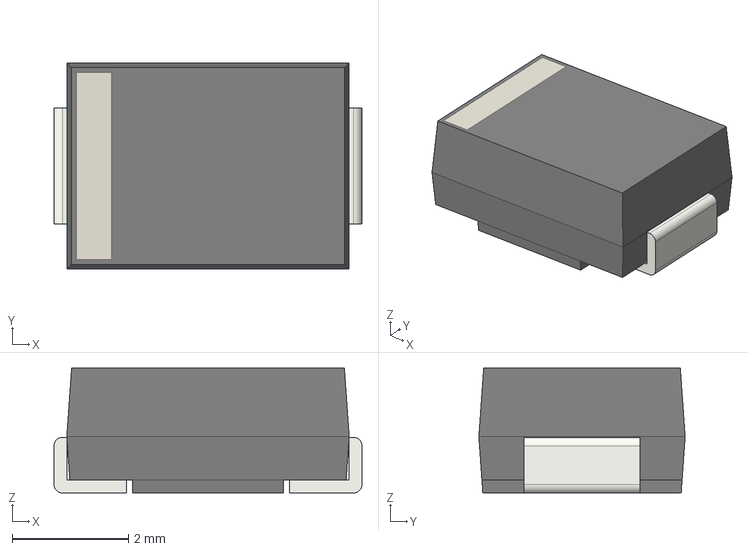
[picture p56: CAD file, 2020-12-13]
kicad_v3/3d_packages/D_SMB.step
5.30 x 3.55 x 2.15 mm
