wyolum/halo/kicad_v3/3d_packages/CP_Elec_10x10.5.step

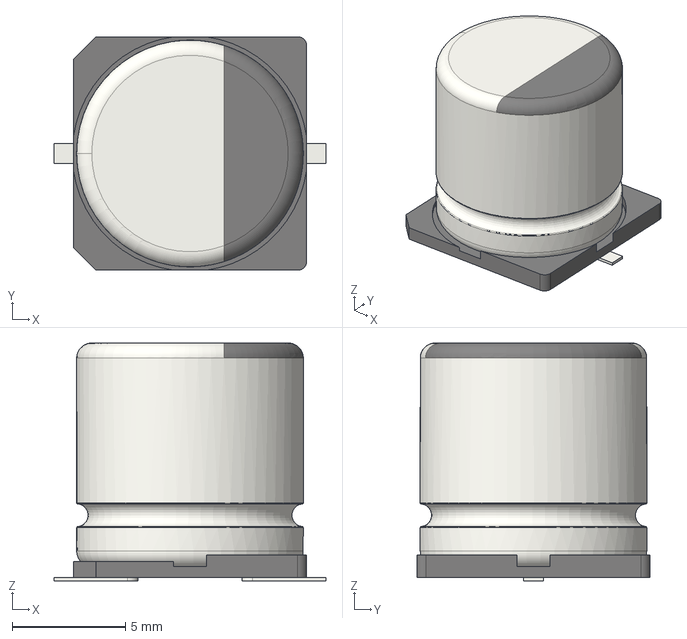
[picture p57: CAD file, 2020-12-13]
kicad_v3/3d_packages/CP_Elec_10x10.5.step
12.0 x 10.3 x 10.5 mm
