wyolum/halo/fabricate_v2/laser_3D_files/Corner_back_right.stl

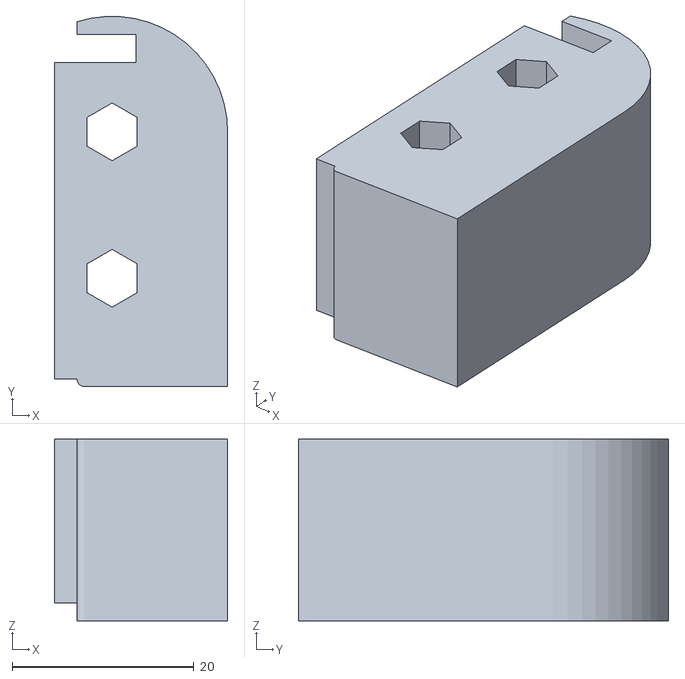
[picture p58: CAD file, 2020-12-17]
fabricate_v2/laser_3D_files/Corner_back_right.stl
19.0 x 40.7 x 20.0
