wyolum/halo/kicad_v3/3d_packages/panasonic_elco_10x10.stp

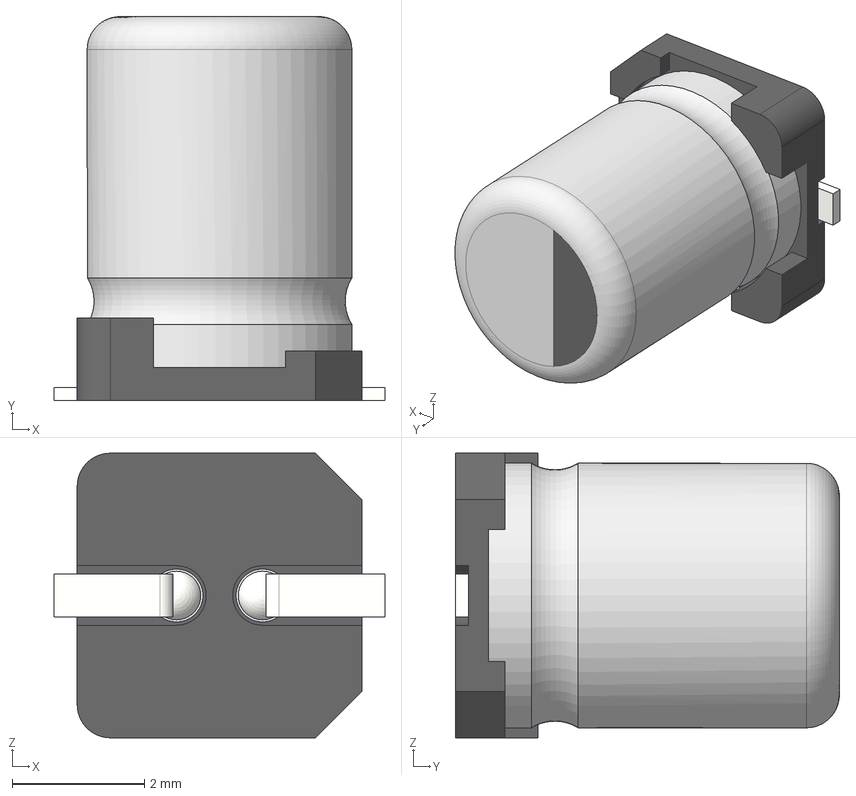
[picture p59: CAD file, 2020-12-10]
kicad_v3/3d_packages/panasonic_elco_10x10.stp
5.00 x 5.80 x 4.30 mm
標準品ケースΦ4x5.3L SIDE CODE B
標準品座版Φ4 SIZE CODE B
標準品リード線Φ4 SIZE CODE B x 2
