wyolum/halo/kicad_v3/3d_packages/sparkfun_apds_9960_v2.step

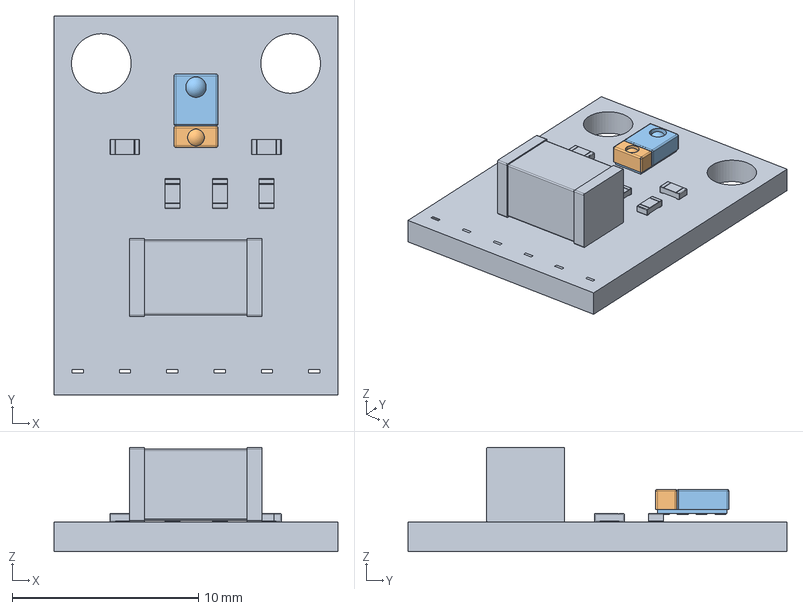
[picture p60: CAD file, 2020-12-10]
kicad_v3/3d_packages/sparkfun_apds_9960_v2.step
15.2 x 20.3 x 5.60 mm
sparkfun_apds_9961
sparkfun_apds_9962
sparkfun_apds_9960.0.189
sparkfun_apds_9960.0.190
sparkfun_apds_9960.0.194
sparkfun_apds_9960.0.195
sparkfun_apds_9960.0.196
sparkfun_apds_9960.0.197
sparkfun_apds_9960.0.223
sparkfun_apds_9960.0.224
sparkfun_apds_9960.0.237
sparkfun_apds_9960.0.238
sparkfun_apds_9960.0.239
sparkfun_apds_9960.0.240
sparkfun_apds_9960.0.241
sparkfun_apds_9960.0.242
sparkfun_apds_9960.0.243
sparkfun_apds_9960.0.244
sparkfun_apds_9960.0.257
sparkfun_apds_9960.0.258
sparkfun_apds_9960.0.259
sparkfun_apds_9960.0.260
sparkfun_apds_9960.0.261
sparkfun_apds_9960.0.262
sparkfun_apds_9960.0.263
sparkfun_apds_9960.0.264
sparkfun_apds_9960.0.265
sparkfun_apds_9960.0.266
sparkfun_apds_9960.0.267
sparkfun_apds_9960.0.268
sparkfun_apds_9960.0.269
sparkfun_apds_9960.0.270
sparkfun_apds_9960.0.271
sparkfun_apds_9960.0.272
sparkfun_apds_9960.0.273
sparkfun_apds_9960.0.274
sparkfun_apds_9960.0.275
sparkfun_apds_9960.0.276
sparkfun_apds_9960.0.277
sparkfun_apds_9960.0.278
sparkfun_apds_9960.0.279
sparkfun_apds_9960.0.280
sparkfun_apds_9960.0.281
sparkfun_apds_9960.0.282
sparkfun_apds_9960.0.283
sparkfun_apds_9960.0.284
sparkfun_apds_9960.0.285
sparkfun_apds_9960.0.286
sparkfun_apds_9960.0.287
sparkfun_apds_9960.0.288
sparkfun_apds_9960.0.289
sparkfun_apds_9960.0.290
sparkfun_apds_9960.0.291
sparkfun_apds_9960.0.292
sparkfun_apds_9960.0.293
sparkfun_apds_9960.0.294
sparkfun_apds_9960.0.295
sparkfun_apds_9960.0.296
sparkfun_apds_9960.0.318
sparkfun_apds_9960.0.319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
