wyolum/halo/fabricate_v2/laser_3D_files/ACR_bottom_2D.dxf

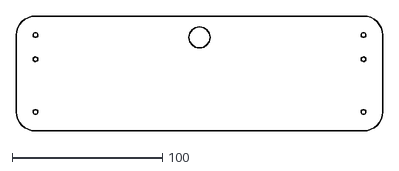
[picture p61: CAD file, 2020-12-13]
fabricate_v2/laser_3D_files/ACR_bottom_2D.dxf
243.8 x 76.5
