wyolum/halo/fabricate_v2/laser_3D_files/ACR_top_back_2D.dxf

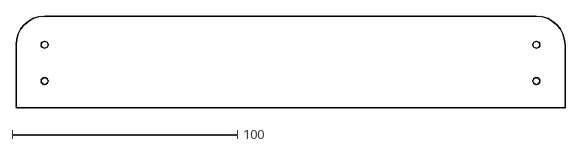
[picture p62: CAD file, 2020-12-13]
fabricate_v2/laser_3D_files/ACR_top_back_2D.dxf
243.8 x 40.7
