wyolum/halo/kicad_v3/3d_packages/PinHeader_2x04_P2.54mm_Vertical_SMD.step

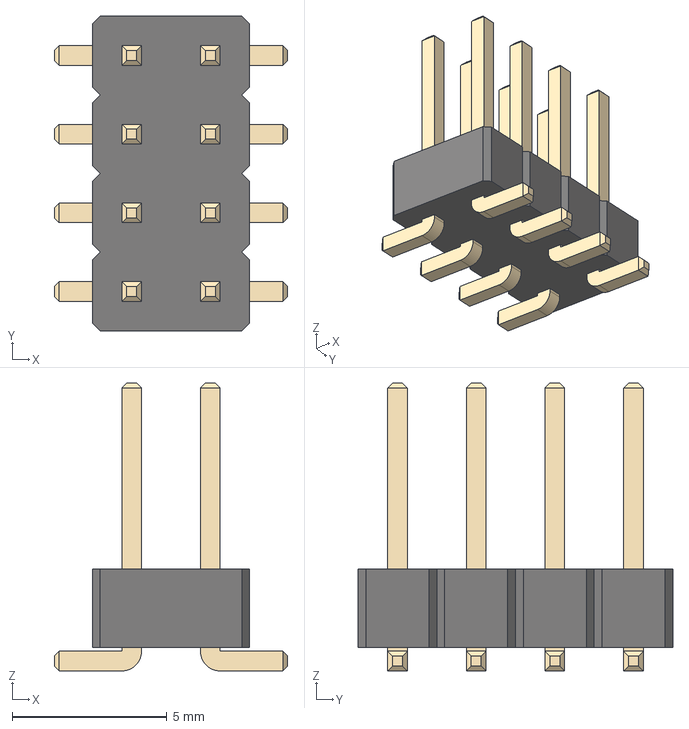
[picture p63: CAD file, 2020-11-03]
kicad_v3/3d_packages/PinHeader_2x04_P2.54mm_Vertical_SMD.step
7.54 x 10.2 x 9.30 mm
