wyolum/halo/fabricate_v2/laser_3D_files/ACR_top_front_2D.dxf

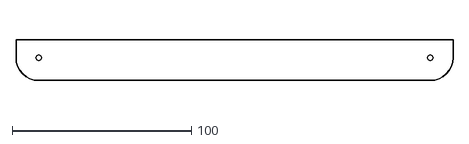
[picture p64: CAD file, 2020-12-13]
fabricate_v2/laser_3D_files/ACR_top_front_2D.dxf
243.8 x 22.9
