wyolum/halo/kicad_v3/3d_packages/PinHeader_2x02_P2.54mm_Vertical_SMD.step

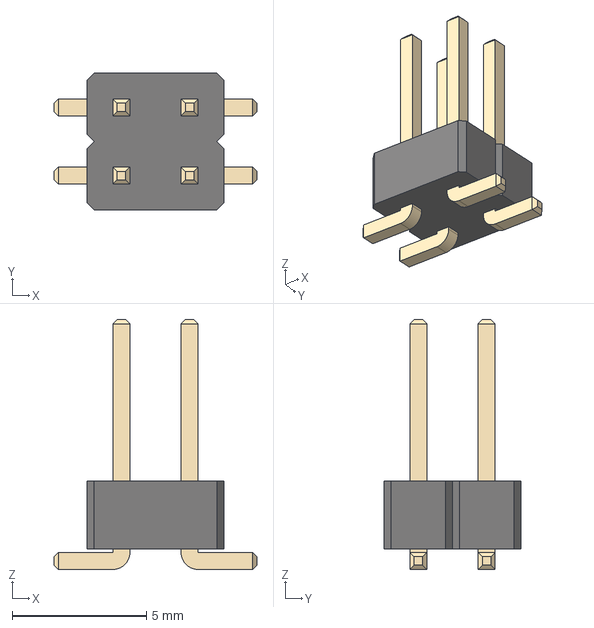
[picture p65: CAD file, 2020-11-03]
kicad_v3/3d_packages/PinHeader_2x02_P2.54mm_Vertical_SMD.step
7.54 x 5.08 x 9.30 mm
