wyolum/halo/fabricate_v2/laser_3D_files/ACR_wall_back_2D.dxf

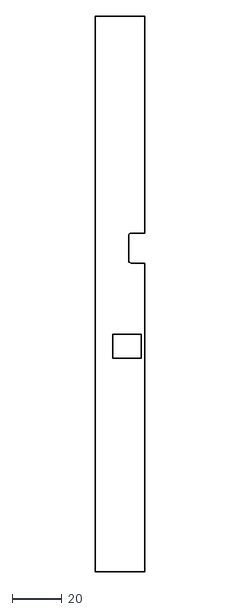
[picture p66: CAD file, 2020-12-13]
fabricate_v2/laser_3D_files/ACR_wall_back_2D.dxf
20.0 x 223.0
