wyolum/halo/fabricate_v2/laser_3D_files/ACR_wall_front_2D.dxf

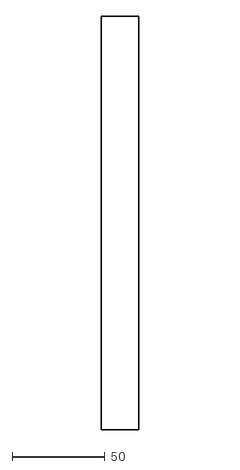
[picture p67: CAD file, 2020-12-13]
fabricate_v2/laser_3D_files/ACR_wall_front_2D.dxf
20.0 x 223.0
