wyolum/halo/kicad_v3/3d_packages/EVQ9P701P.step

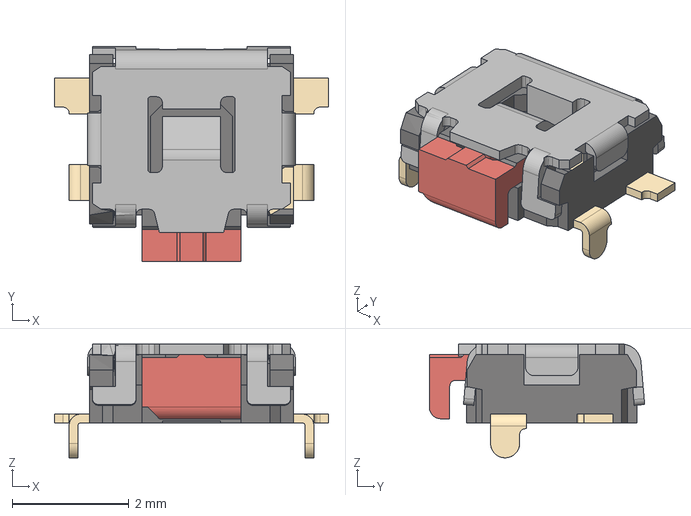
[picture p68: CAD file, 2020-11-01]
kicad_v3/3d_packages/EVQ9P701P.step
4.70 x 3.69 x 1.95 mm
