wyolum/halo/kicad_v3/3d_packages/PinHeader_1x08_P254mm_Vertical_SMD_Pin1Left.step

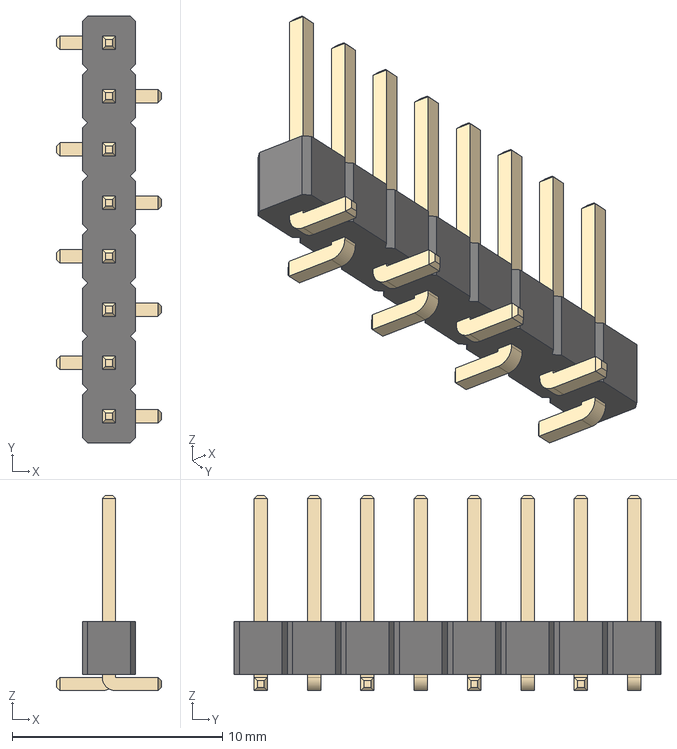
[picture p69: CAD file, 2020-11-01]
kicad_v3/3d_packages/PinHeader_1x08_P254mm_Vertical_SMD_Pin1Left.step
5.00 x 20.3 x 9.30 mm
