wyolum/halo/kicad_v3/3d_packages/TQFP_32_7x7mm_P08mm.step

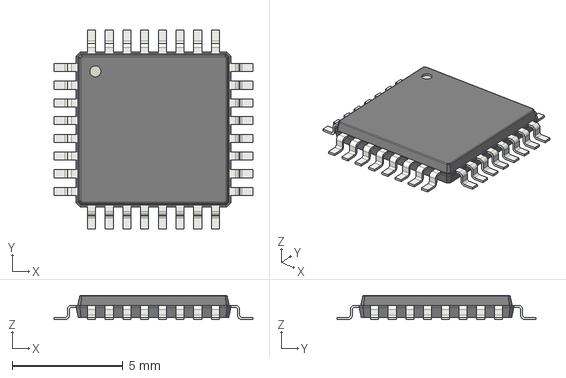
[picture p70: CAD file, 2020-11-01]
kicad_v3/3d_packages/TQFP_32_7x7mm_P08mm.step
9.00 x 9.00 x 1.10 mm
