wyolum/halo/kicad_v3/3d_packages/LED_WS2812B_PLCC4_5x5mm_P3_2mm.step

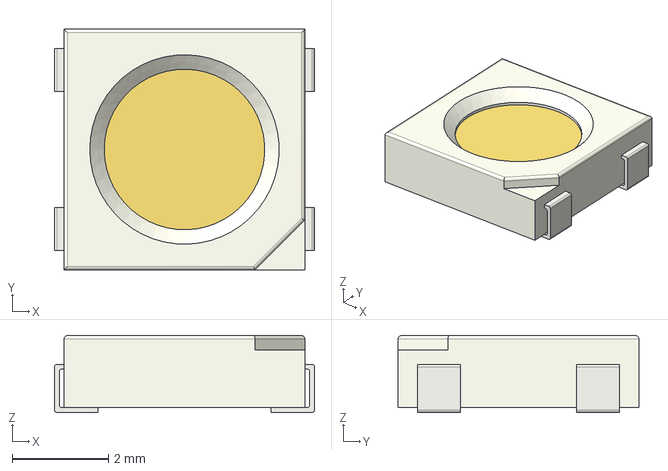
[picture p71: CAD file, 2020-11-01]
kicad_v3/3d_packages/LED_WS2812B_PLCC4_5x5mm_P3_2mm.step
5.40 x 5.00 x 1.60 mm
