wyolum/halo/kicad_v3/3d_packages/PinHeader_1x06_P254mm_Vertical_SMD_Pin1Left.step

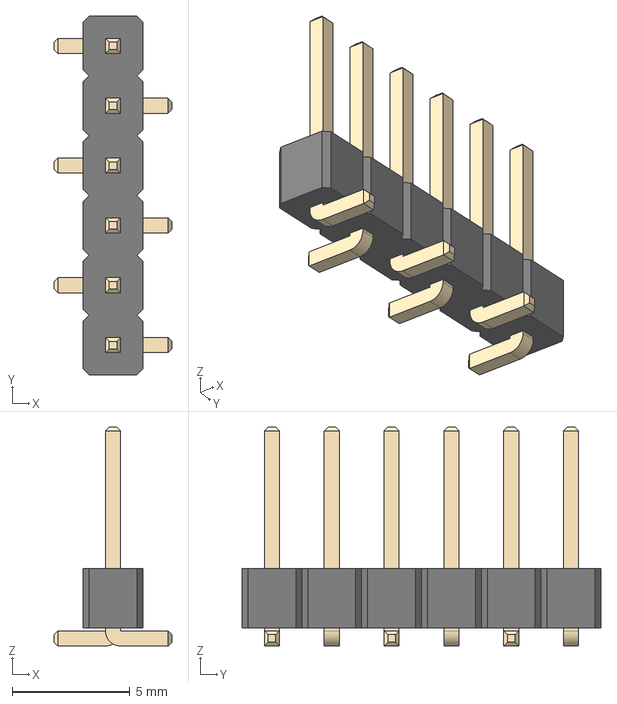
[picture p72: CAD file, 2020-11-01]
kicad_v3/3d_packages/PinHeader_1x06_P254mm_Vertical_SMD_Pin1Left.step
5.00 x 15.2 x 9.30 mm
