wyolum/halo/kicad_v3/3d_packages/CP_Elec_4x58.step

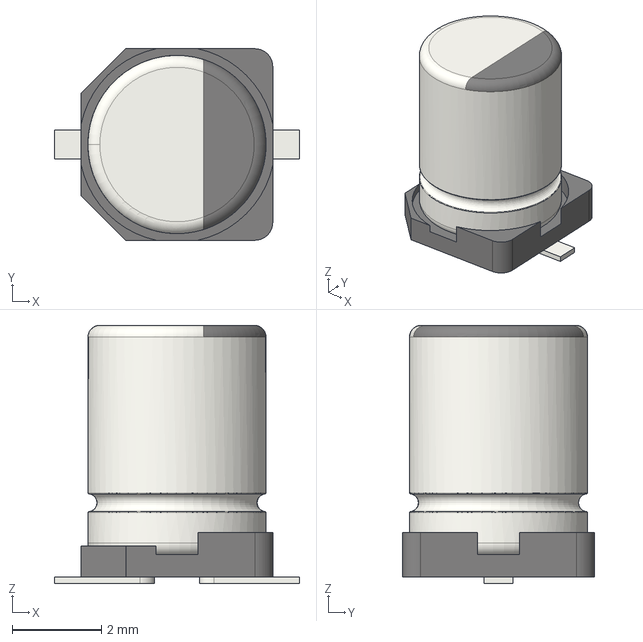
[picture p73: CAD file, 2020-11-01]
kicad_v3/3d_packages/CP_Elec_4x58.step
5.50 x 4.30 x 5.80 mm
