wyolum/halo/kicad_v3/3d_packages/C_0805_2012Metric.step

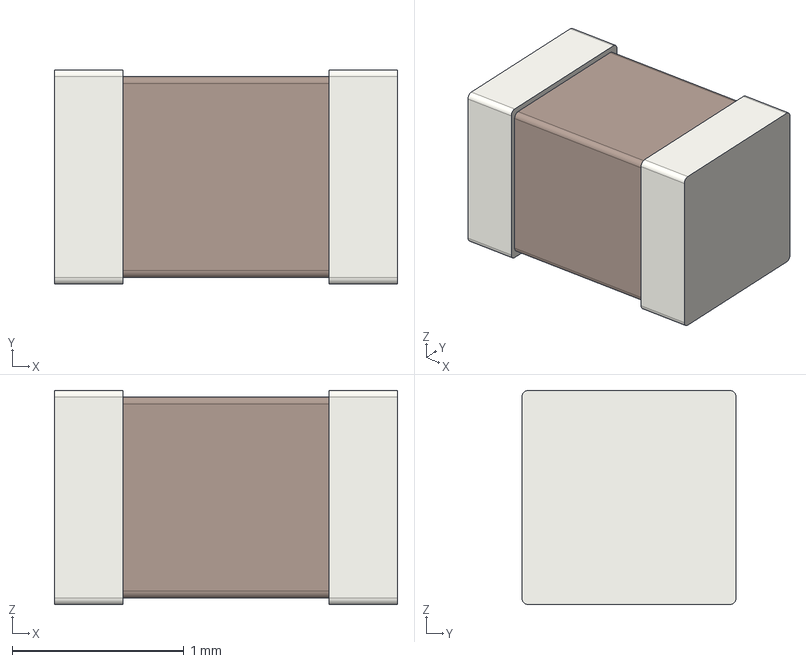
[picture p74: CAD file, 2020-11-01]
kicad_v3/3d_packages/C_0805_2012Metric.step
2.00 x 1.25 x 1.25 mm
