wyolum/halo/kicad_v3/3d_packages/R_0805_2012Metric.step

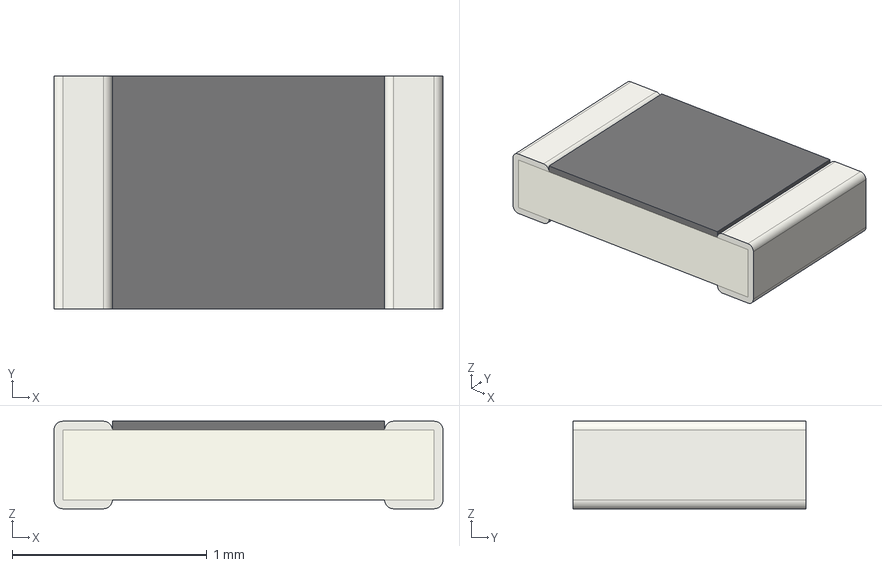
[picture p76: CAD file, 2020-11-01]
kicad_v3/3d_packages/R_0805_2012Metric.step
2.00 x 1.20 x 0.45 mm
