wyolum/halo/kicad_v3/3d_packages/SOT_223.step

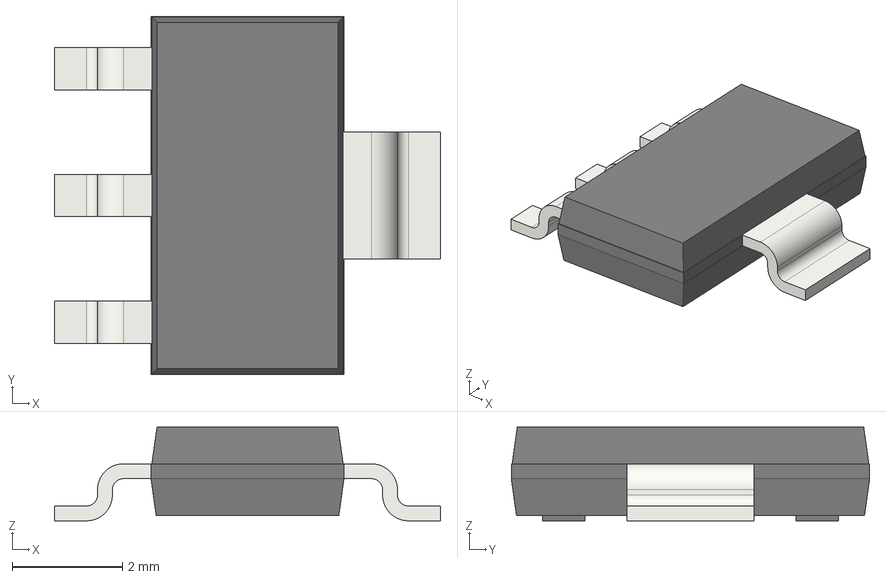
[picture p77: CAD file, 2020-11-01]
kicad_v3/3d_packages/SOT_223.step
7.00 x 6.50 x 1.70 mm
