wyolum/halo/kicad_v3/3d_packages/PinHeader_2x03_P254mm_Vertical_SMD.step

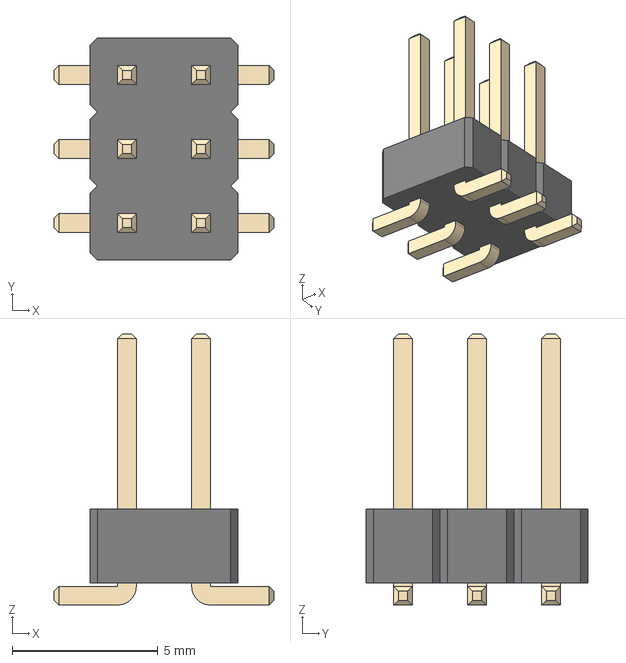
[picture p80: CAD file, 2020-11-01]
kicad_v3/3d_packages/PinHeader_2x03_P254mm_Vertical_SMD.step
7.54 x 7.62 x 9.30 mm
