wyolum/halo/(list of files, cad)

Other CAD files:
kicad_v3/3d_packages/conn_barrel.step
fabricate_v2/laser_3D_files/Corner_front_left.stl
fabricate_v2/laser_3D_files/Corner_back_left.stl
kicad_v3/3d_packages/USB4110_GF_A018.step
fabricate/endcaps.scad
fabricate/standoff.scad
fabricate/NotAMap/endcaps.scad
fabricate/archive/LED.FCStd
fabricate/archive/WS2812 60 per meter strip.stp
fabricate/archive/WS2812x30.step
fabricate/archive/halo_base_BAK.FCStd
fabricate/base/halo_01.FCStd
fabricate/halo_base.FCStd
fabricate_v2/laser_3D_files/archive/Corner_back_left_circle.stl
fabricate_v2/laser_3D_files/archive/Corner_back_left_hex.stl
fabricate_v2/laser_3D_files/archive/Corner_back_right_circle.stl
fabricate_v2/laser_3D_files/archive/Corner_back_right_hex.stl
fabricate_v2/laser_3D_files/archive/Corner_front_left_circle.stl
fabricate_v2/laser_3D_files/archive/Corner_front_left_hex.stl
fabricate_v2/laser_3D_files/archive/Corner_front_right_circle.stl
fabricate_v2/laser_3D_files/archive/Corner_front_right_hex.stl
kicad/3d_packages/sparkfun_APDS-9960/APDS-9960.SLDPRT
kicad/3d_packages/sparkfun_APDS-9960/APDS-9960.STL
kicad/3d_packages/sparkfun_APDS-9960/APDS-9960_RGB_and_Gesture_Sensor-v10.stl
kicad/3d_packages/sparkfun_APDS-9960/SparkFun_APDS-9960_RGB_and_Gesture_Sensor.stl
kicad_v3/3d_packages/archive/D_SMA.step
kicad_v3/3d_packages/archive/D_SMC.step
kicad_v3/3d_packages/archive/PinHeader_1x02_P2.54mm_Vertical_SMD_Pin1Left.step
kicad_v3/3d_packages/archive/PinHeader_1x04_P2.54mm_Vertical_SMD_Pin1Left.step
kicad_v3/3d_packages/archive/PinHeader_1x06_P2.54mm_Vertical_SMD_Pin1Left.step
kicad_v3/3d_packages/archive/PinHeader_1x08_P2.54mm_Vertical_SMD_Pin1Left.step
kicad_v3/3d_packages/archive/PinHeader_2x03_P2.54mm_Vertical_SMD.step
kicad_v3/3d_packages/archive/SOT-223.step
kicad_v3/3d_packages/archive/sparkfun_APDS-9960.FCStd
kicad_v3/3d_packages/archive/sparkfun_APDS-9960/APDS-9960.SLDPRT
kicad_v3/3d_packages/archive/sparkfun_APDS-9960/APDS-9960.STL
kicad_v3/3d_packages/archive/sparkfun_APDS-9960/APDS-9960_RGB_and_Gesture_Sensor-v10.stl
kicad_v3/3d_packages/archive/sparkfun_APDS-9960/SparkFun_APDS-9960_RGB_and_Gesture_Sensor.step
kicad_v3/3d_packages/archive/sparkfun_APDS-9960/SparkFun_APDS-9960_RGB_and_Gesture_Sensor.stl
kicad_v3/3d_packages/archive/switch_EVQ-9P7_P34-01P.STEP
kicad_v3/3d_packages/sparkfun_apds_9960.step
