wyolum/halo/fabricate_v2/render/halo_v3_01.png

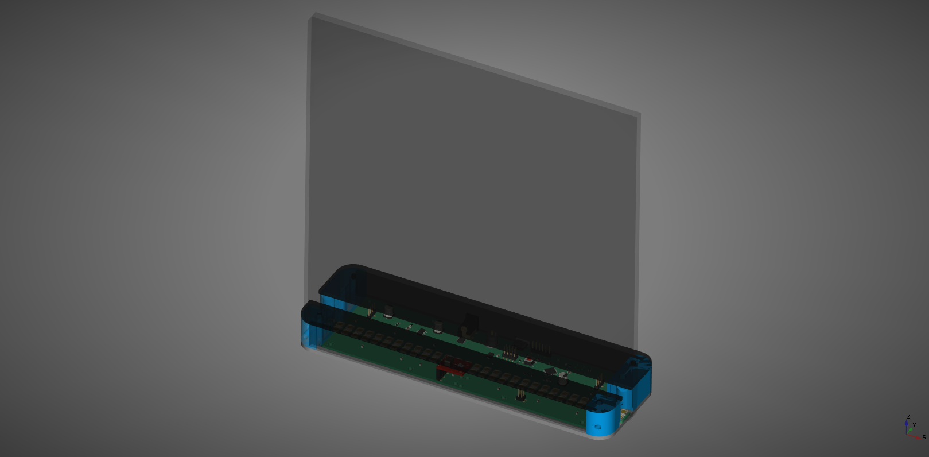
fabricate_v2/render/halo_v3_01.png
