wyolum/halo/fabricate_v2/render/halo_v3_02.png

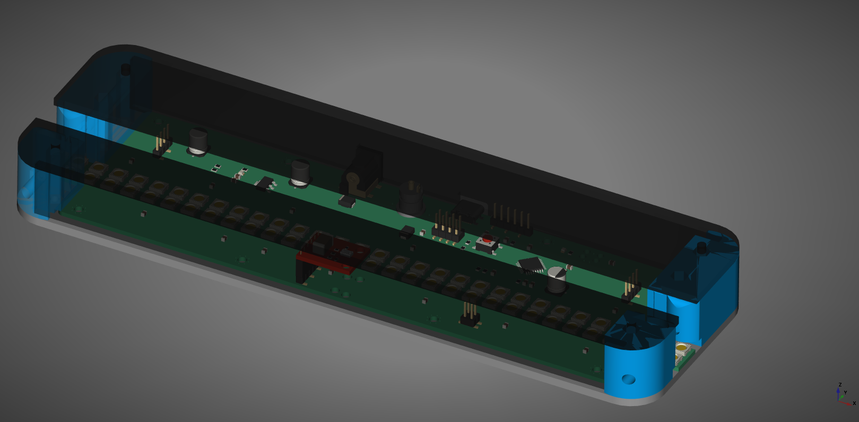
fabricate_v2/render/halo_v3_02.png
