wyolum/halo/fabricate_v2/render/halo_v3_03.png

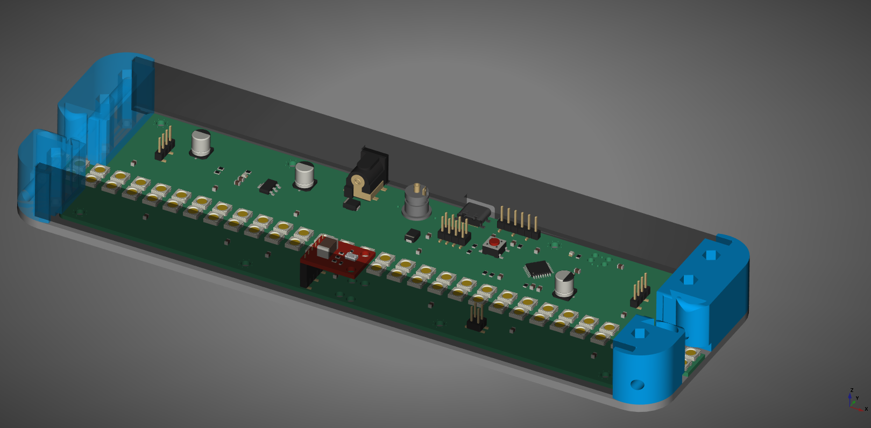
fabricate_v2/render/halo_v3_03.png
