wyolum/halo/data/SWITCH_1810101632_E-Switch-TL3301AF160QG_C273519.pdf

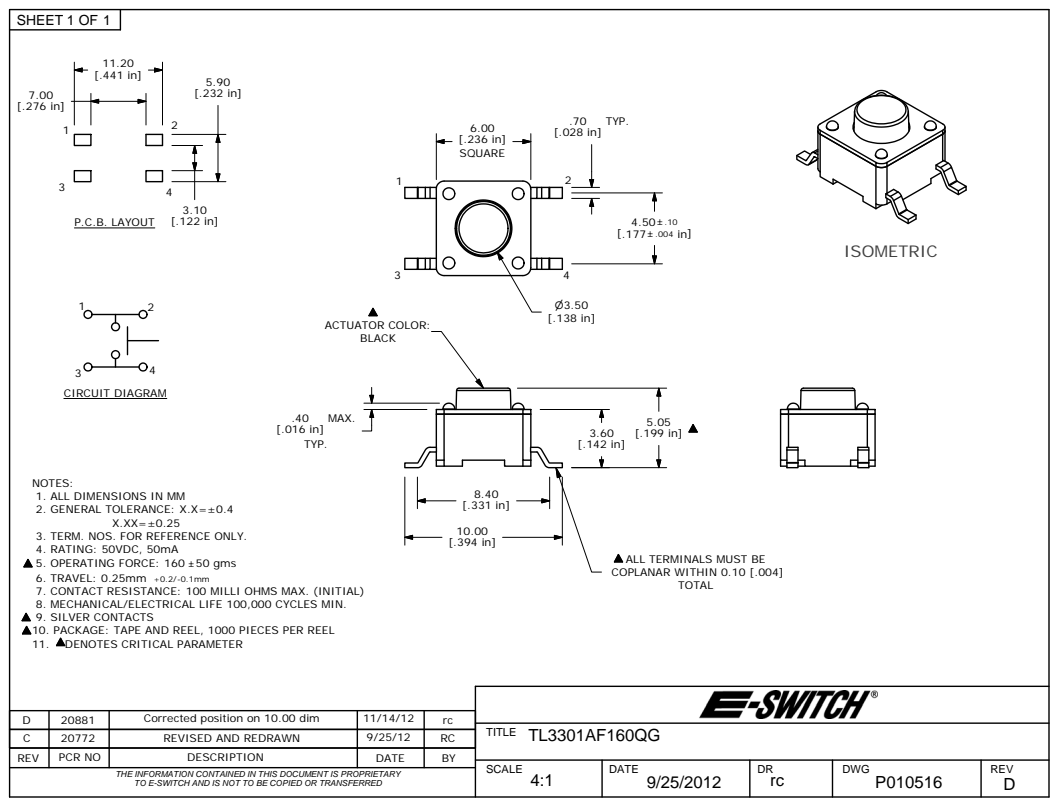
[picture p87: page 1]
ISOMETRIC; TITLE; THE INFORMATION CONTAINED IN THIS DOCUMENT IS PROPRIETARY; SCALE; DATE; DWG; REV; SHEET OF; CIRCUIT DIAGRAM; P.C.B. LAYOUT; TYP. 6.00 [.236 in] SQUARE; MAX.; TYP.; TOTAL; ACTUATOR COLOR: BLACK

NOTES:
1. ALL DIMENSIONS IN MM
2. GENERAL TOLERANCE: X.X=±0.4

3. TERM. NOS. FOR REFERENCE ONLY.
4. RATING: 50VDC, 50mA
5. OPERATING FORCE: 160 50 gms
6. TRAVEL: 0.25mm +0.2/-0.1mm
7. CONTACT RESISTANCE: 100 MILLI OHMS MAX. (INITIAL)
8. MECHANICAL/ELECTRICAL LIFE 100,000 CYCLES MIN.
9. SILVER CONTACTS
10. PACKAGE: TAPE AND REEL, 1000 PIECES PER REEL
11. DENOTES CRITICAL PARAMETER

ALL TERMINALS MUST BE
COPLANAR WITHIN 0.10 [.004]

D | 20881 | Corrected position on 10.00 dim | 11/14/12 | rc
C | 20772 | REVISED AND REDRAWN | 9/25/12 | RC
REV | PCR NO | DESCRIPTION | DATE | BY

TO E-SWITCH AND IS NOT TO BE COPIED OR TRANSFERRED
