wyolum/halo/kicad_v3/PDF/halo-Dwgs_User.pdf

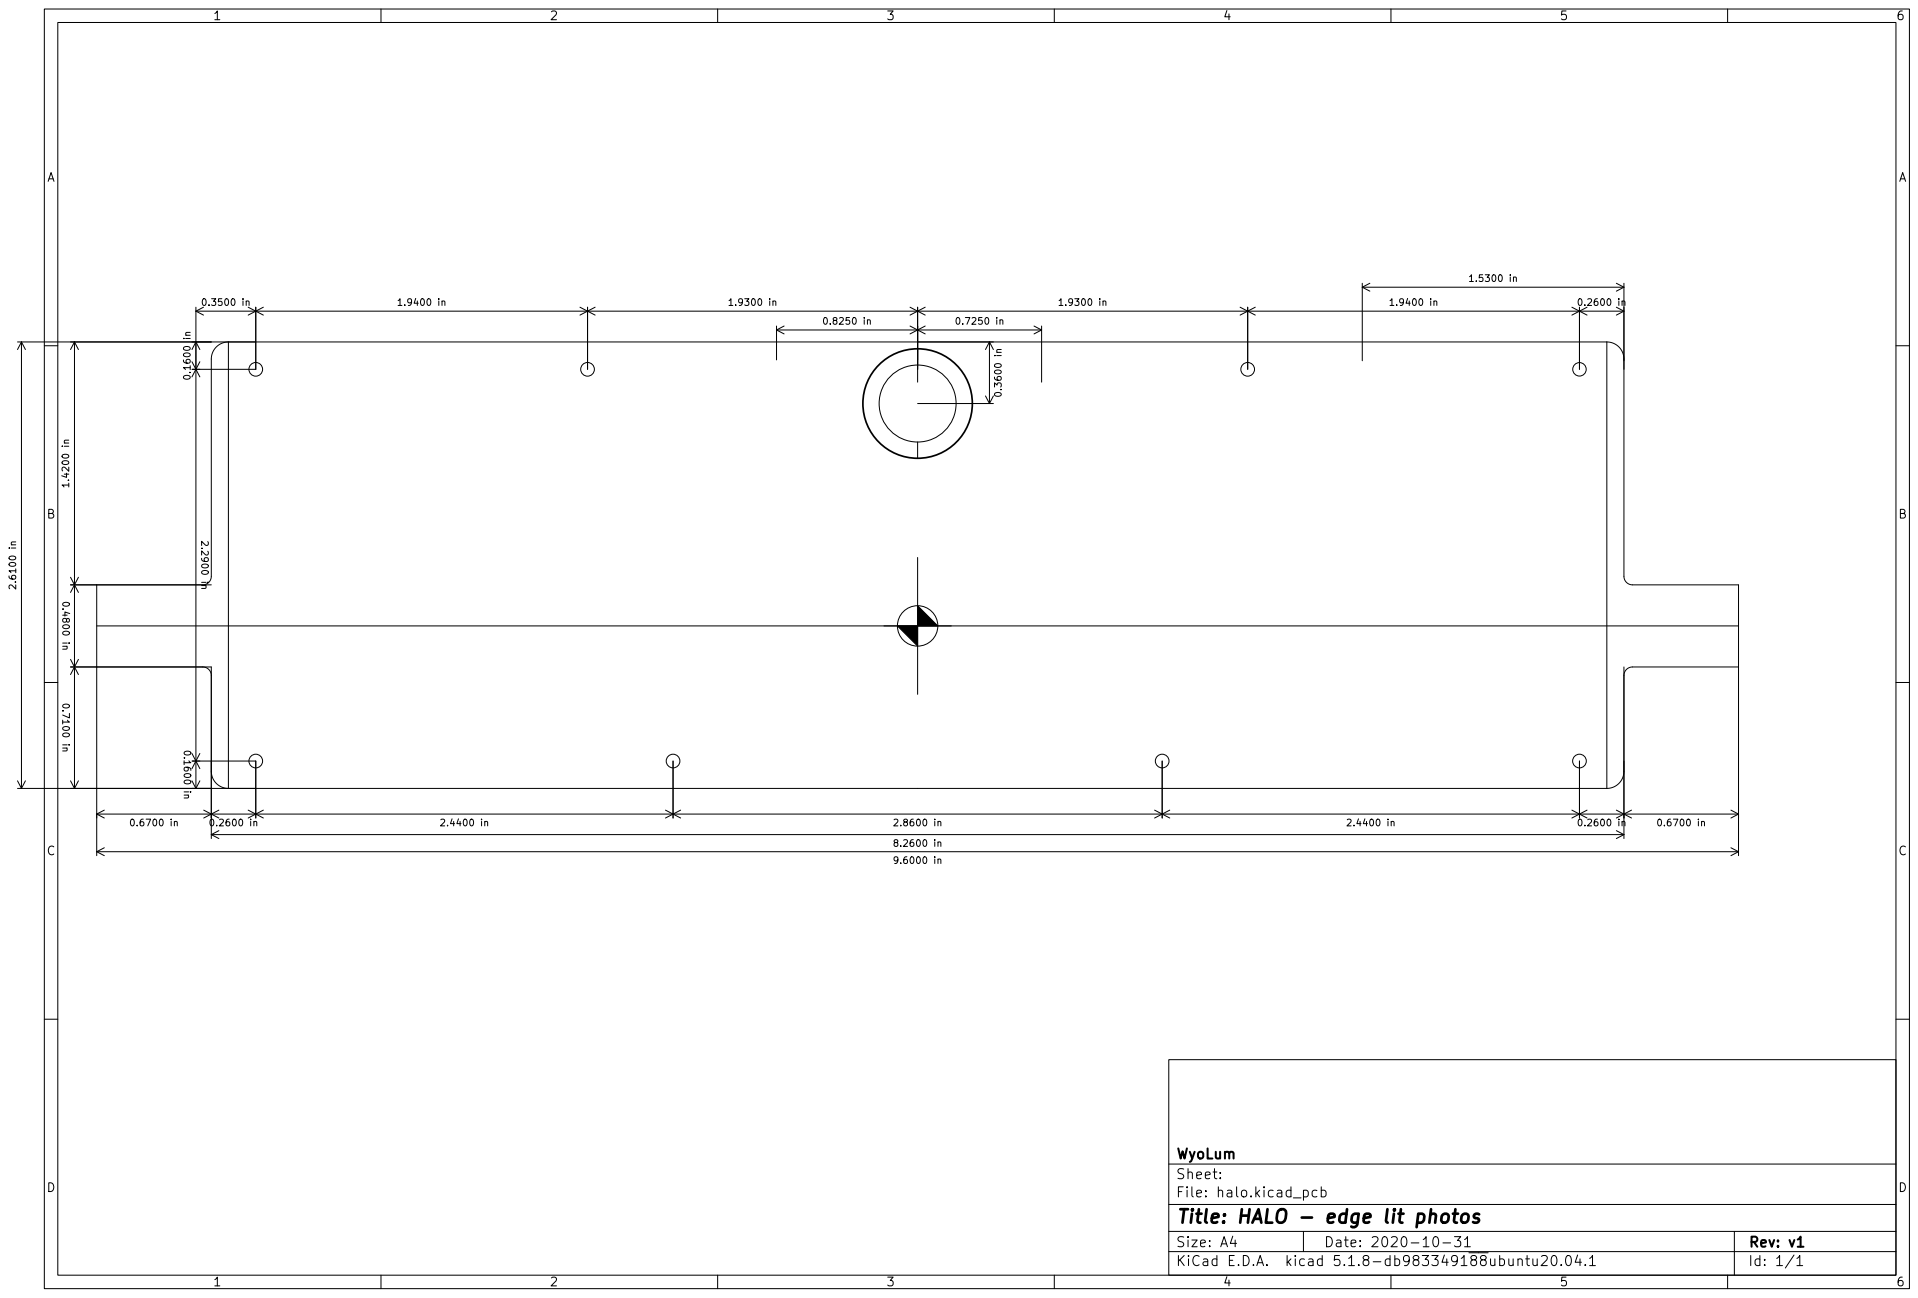
[picture p91: page 1]

File: halo.kicad_pcb Sheet: WyoLum 2.6100 in

Id: 1/1 Title: HALO - edge lit photos
