wyolum/halo/kicad_v3/PDF/halo-F_Mask.pdf

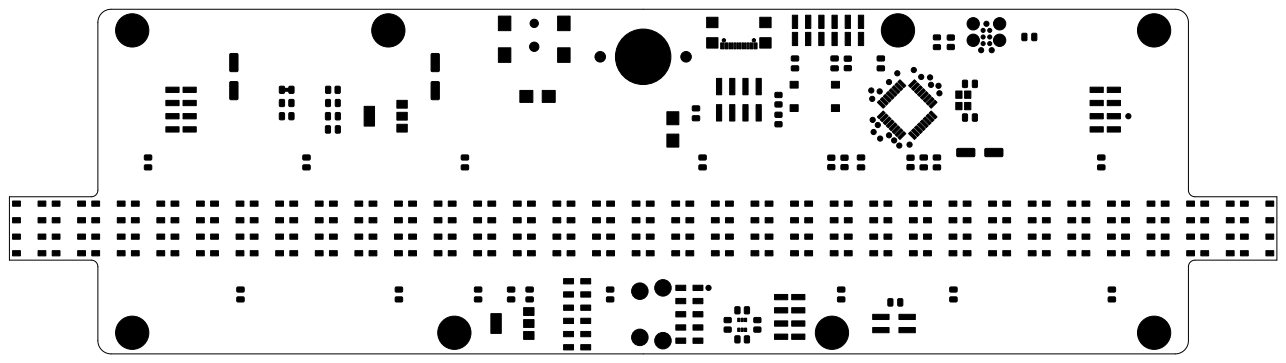
[picture p94: page 1]

File: halo.kicad_pcb Sheet: WyoLum

Id: 1/1 Title: HALO - edge lit photos
