wyolum/halo/kicad_v3/PDF/halo-F_SilkS.pdf

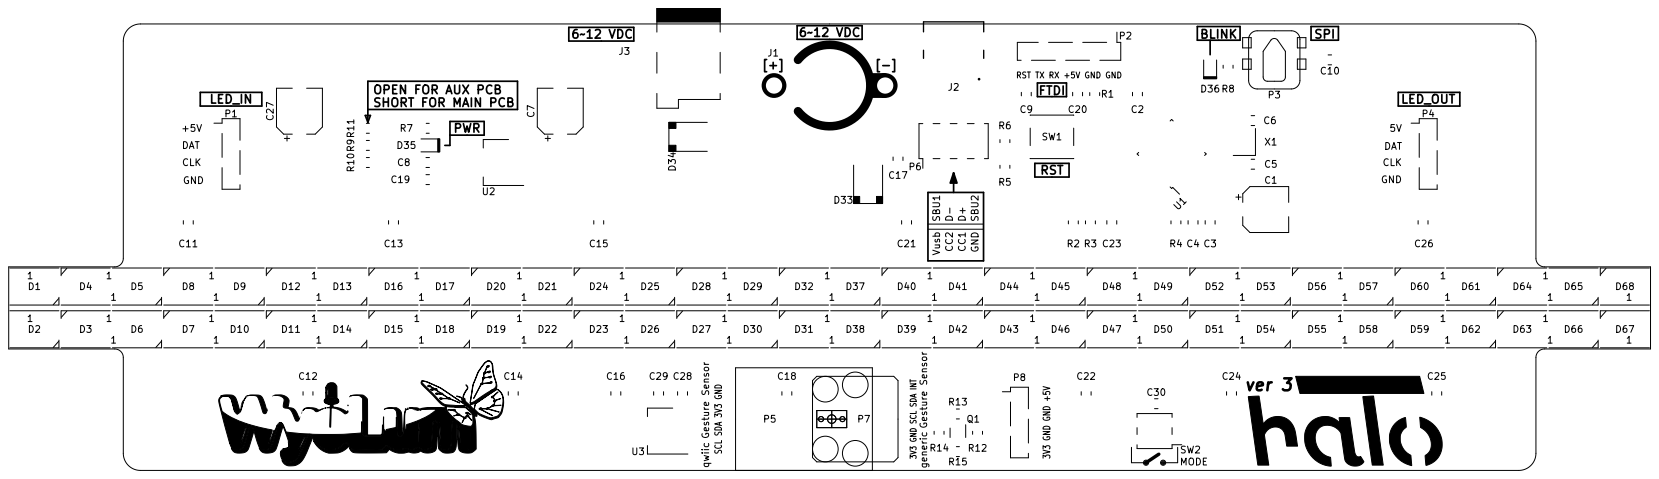
[picture p95: page 1]

File: halo.kicad_pcb Sheet: WyoLum

Id: 1/1 Title: HALO - edge lit photos
