wyolum/halo/kicad_v3/PDF/halo.pdf

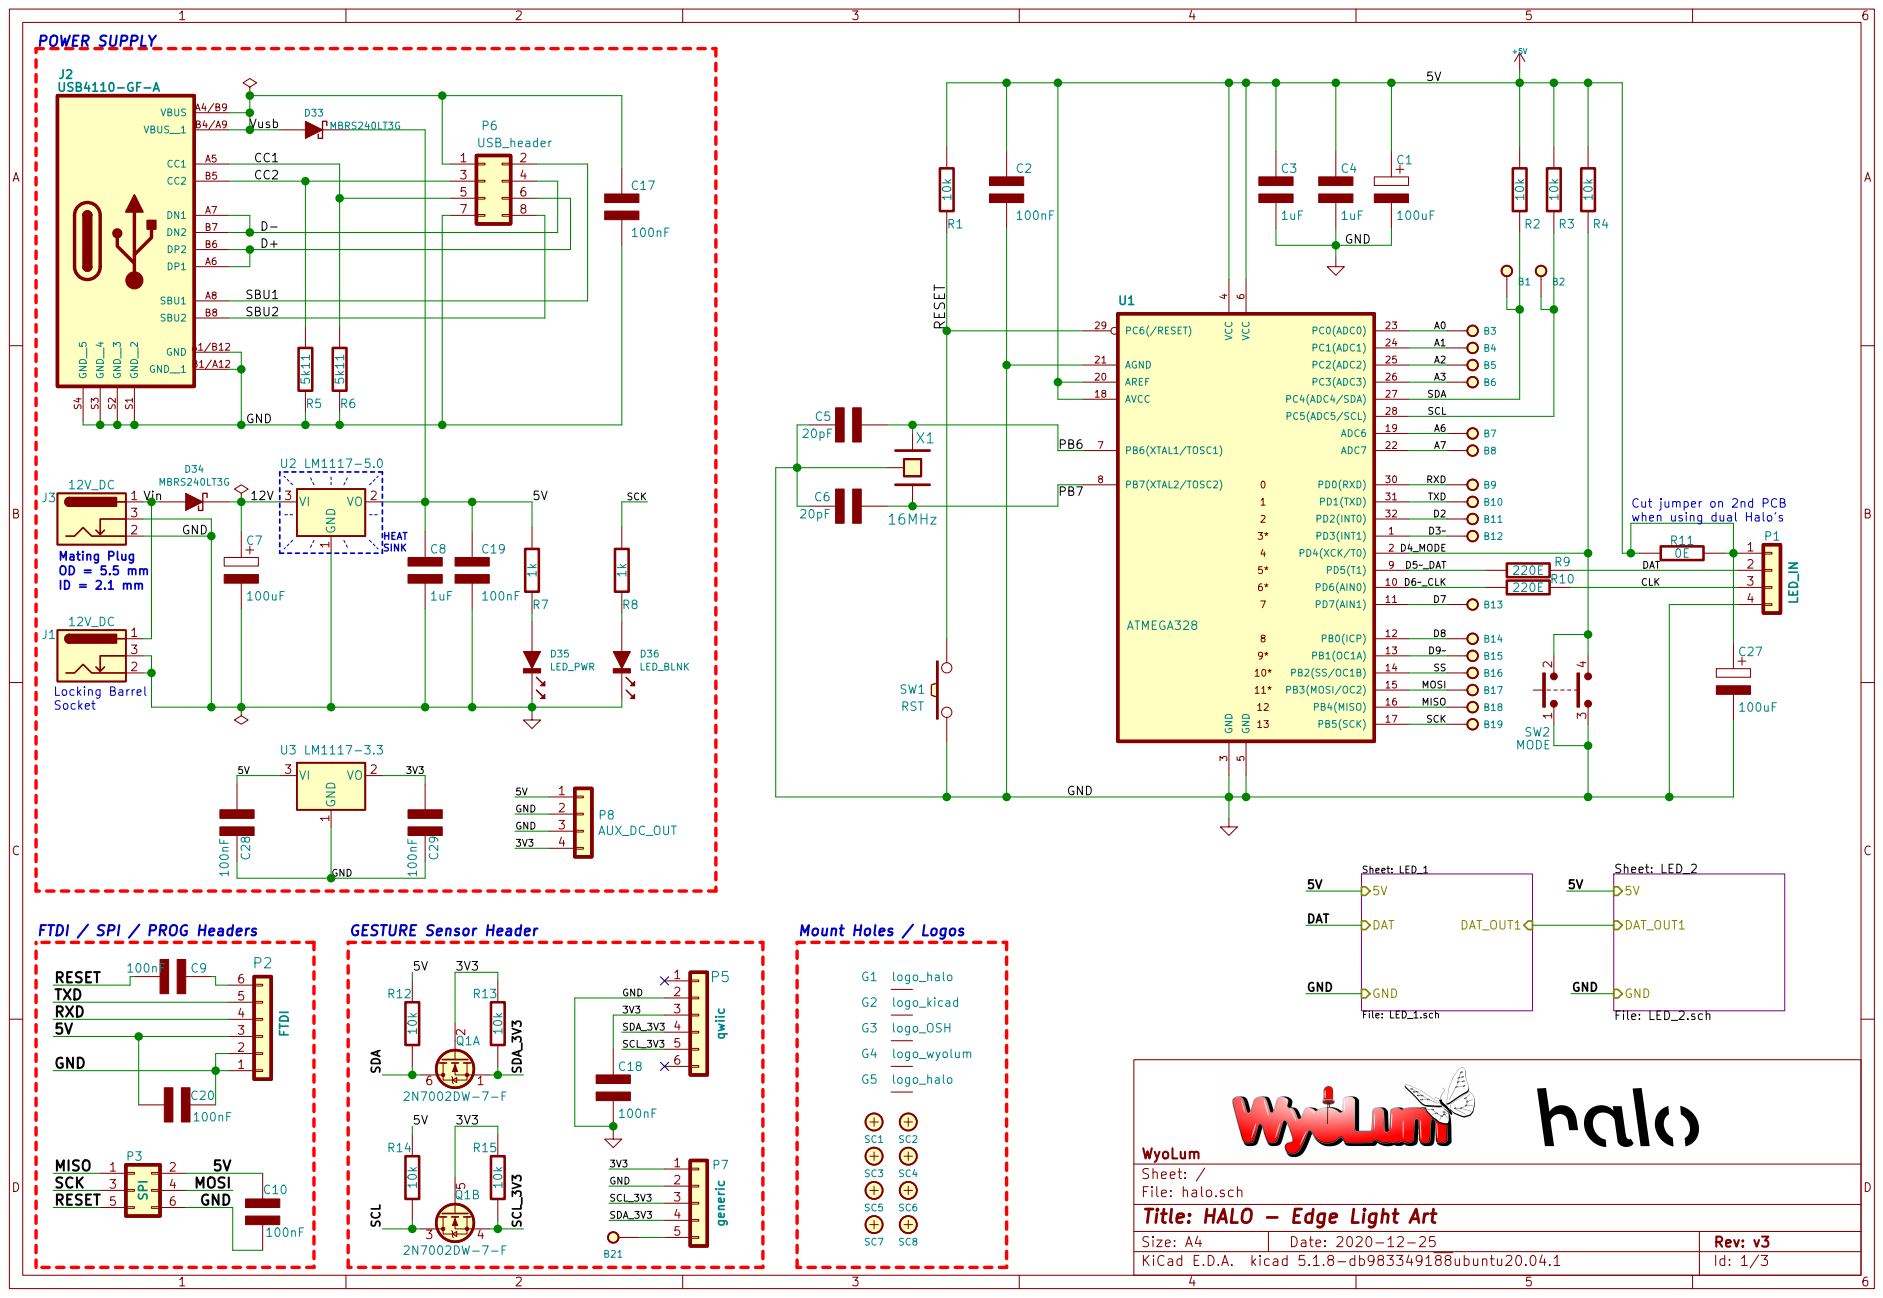
[picture p96: page 1]

HEAT SINK POWER SUPPLY
+5V D4_MODE RXD

SDA
SCL SS MOSI SCK MISO

Cut jumper on 2nd PCB
when using dual Halo's

Mating Plug OD = 5.5 mm

Id: 1/3 Title: HALO - Edge Light Art File: halo.sch Sheet: / WyoLum

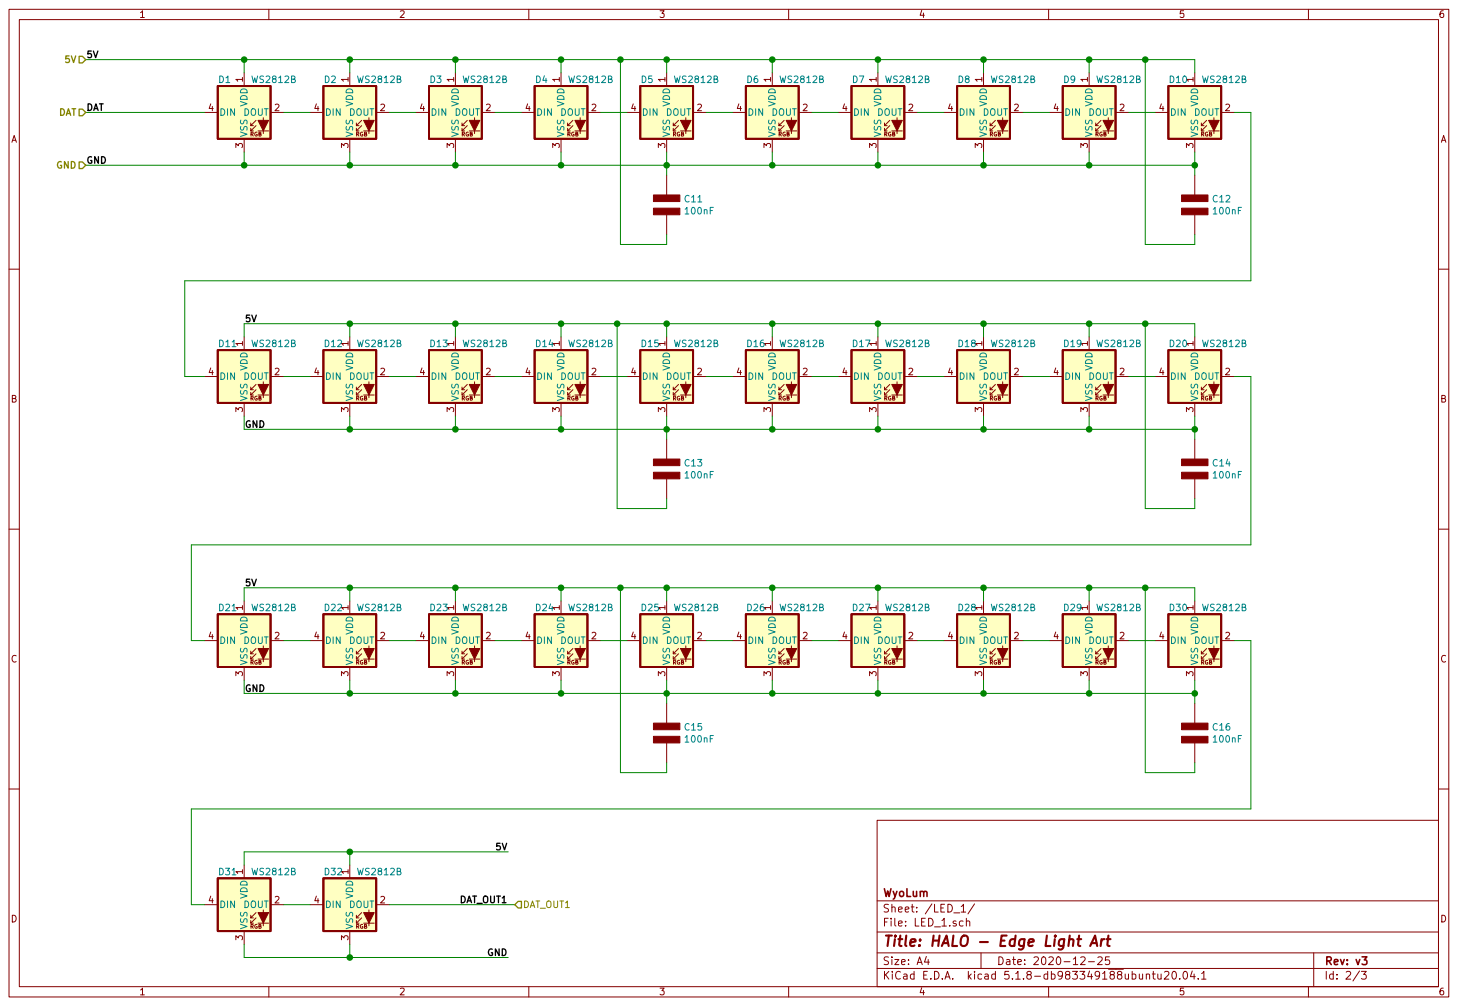
[picture p97: page 2]

WyoLum
Sheet: /LED_1/
File: LED_1.sch
Id: 2/3 Title: HALO - Edge Light Art

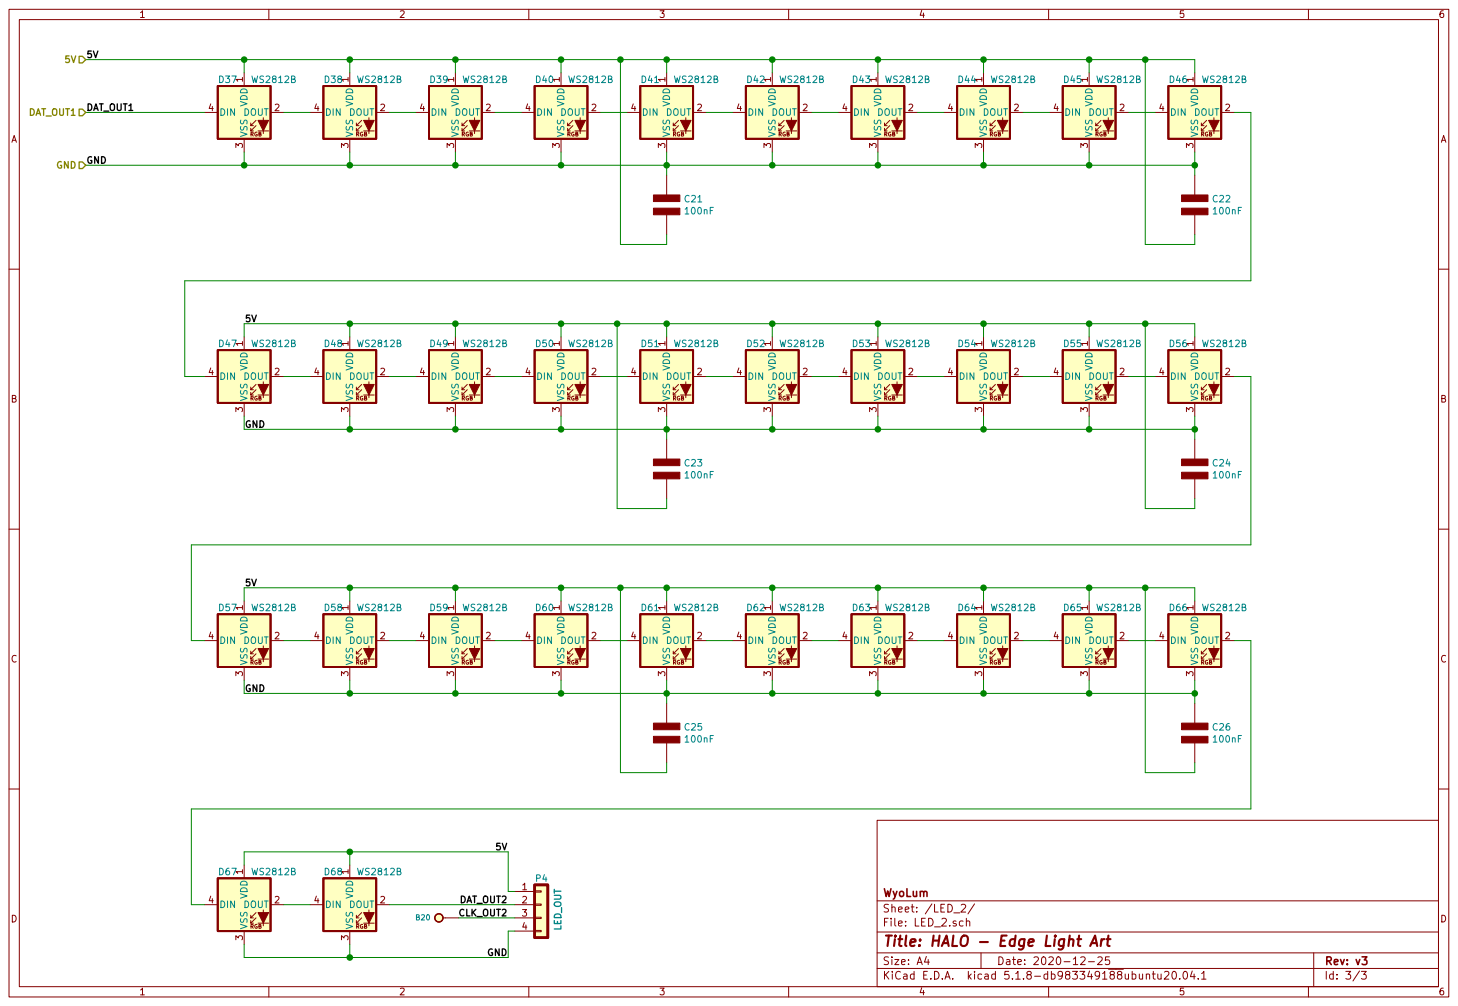
[picture p98: page 3]

WyoLum
Sheet: /LED_2/
File: LED_2.sch
Id: 3/3 Title: HALO - Edge Light Art
