wyolum/halo/data/USB-C31-S-RA-CS2-SMT-BK-TR.pdf

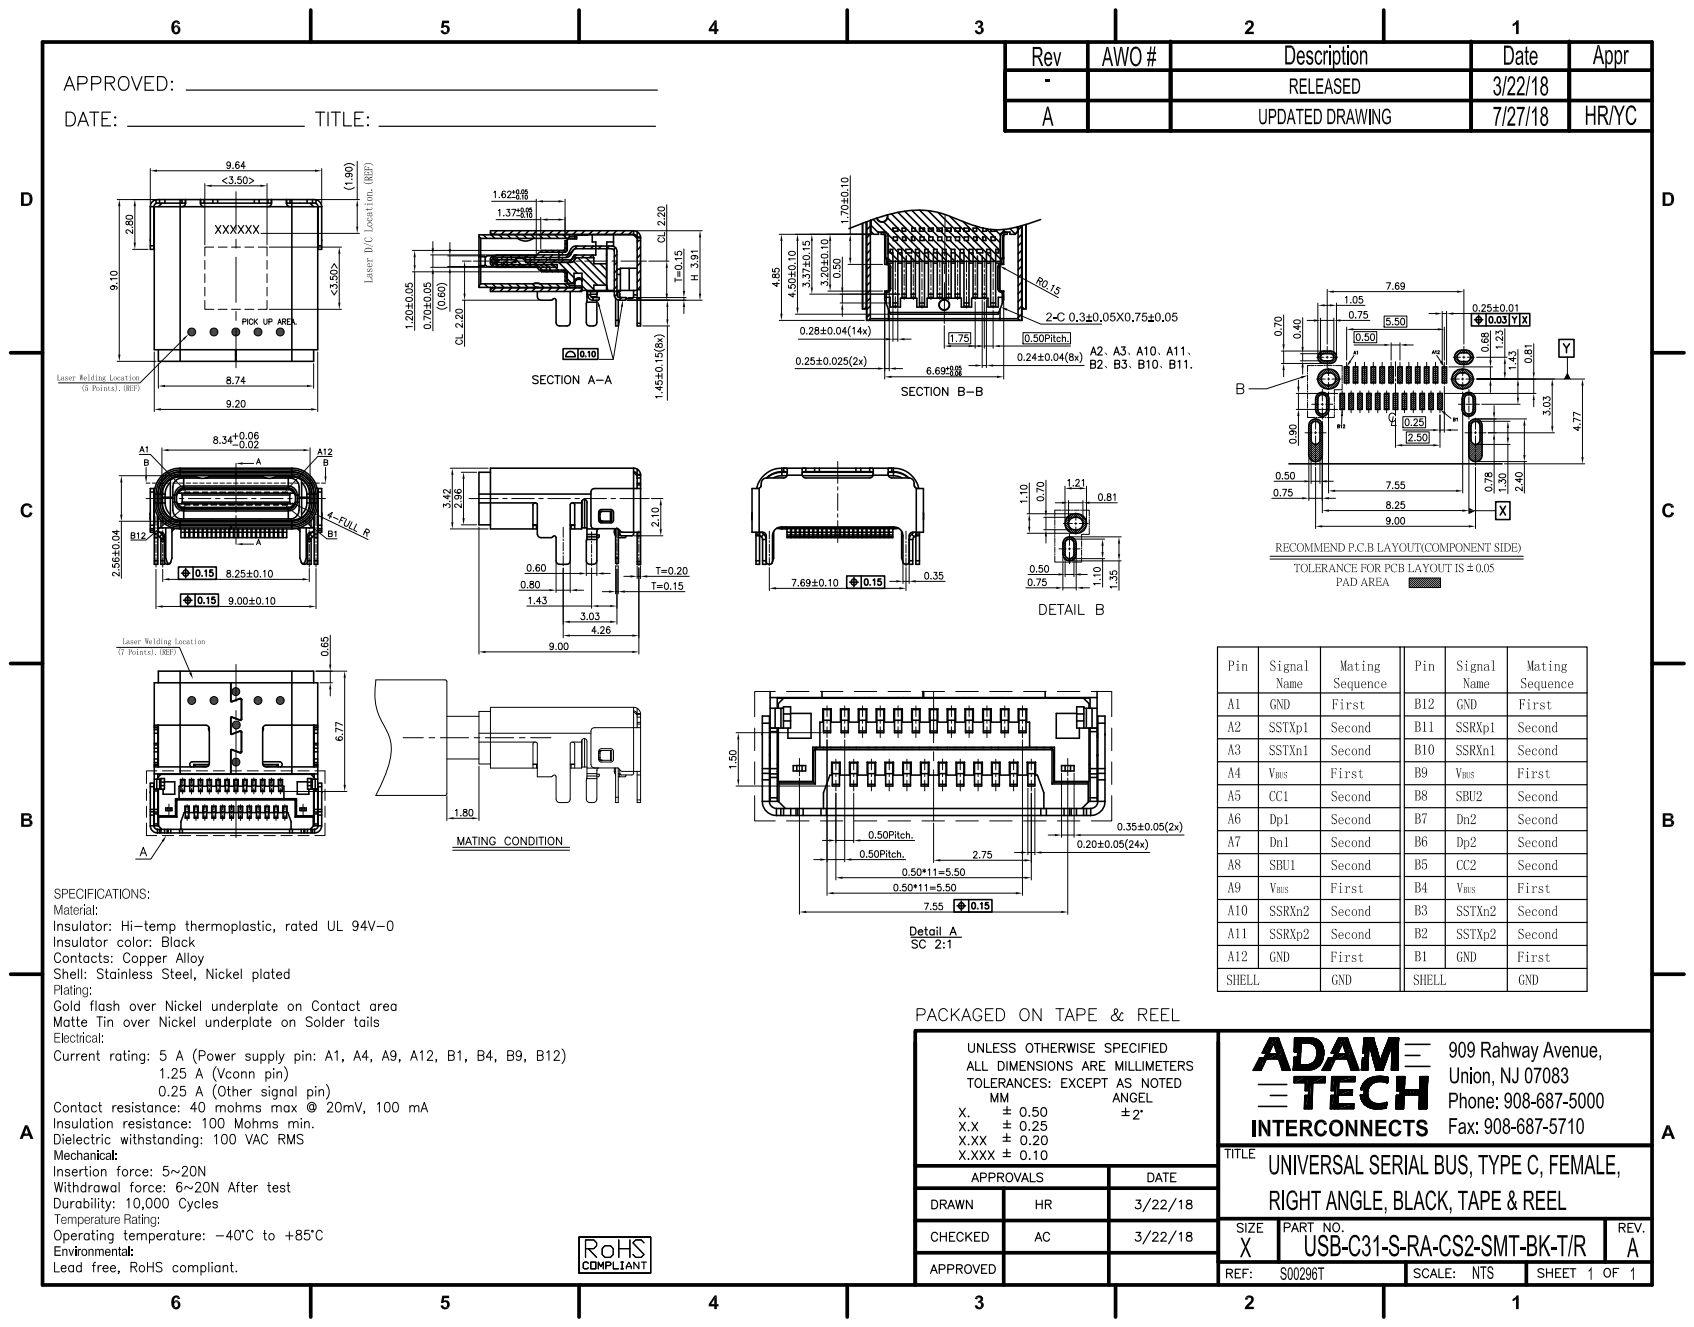
[picture p99: page 1]
