wyolum/halo/kicad_v1/PDF/halo-B_Cu.pdf

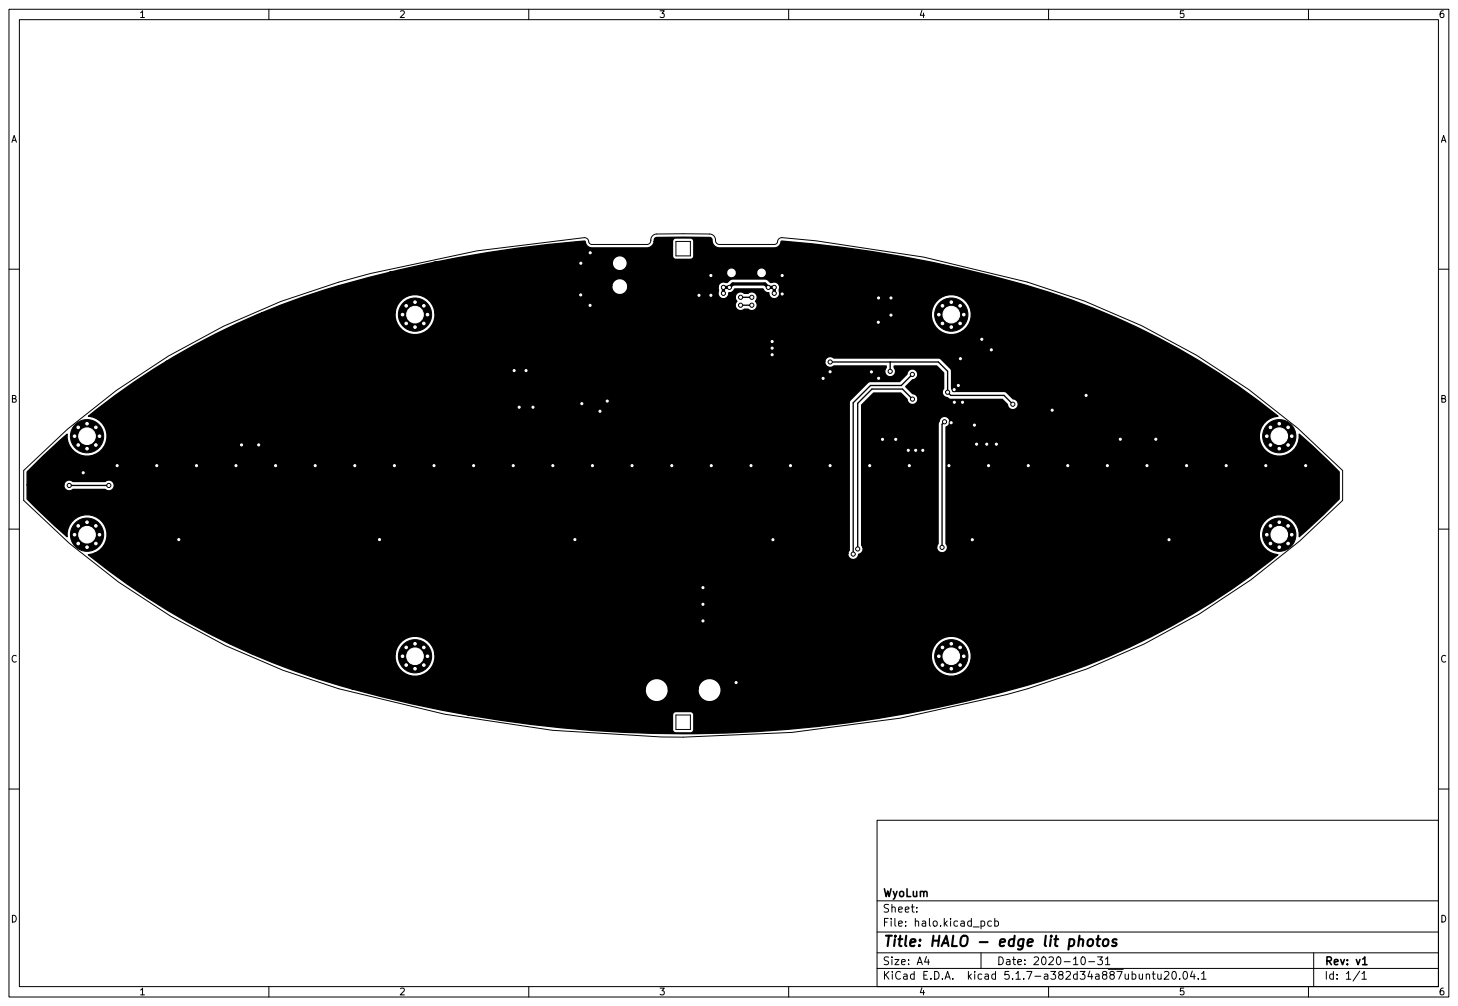
[picture p100: page 1]

File: halo.kicad_pcb Sheet: WyoLum

Id: 1/1 Title: HALO - edge lit photos
