wyolum/halo/kicad_v1/PDF/halo-F_Paste.pdf

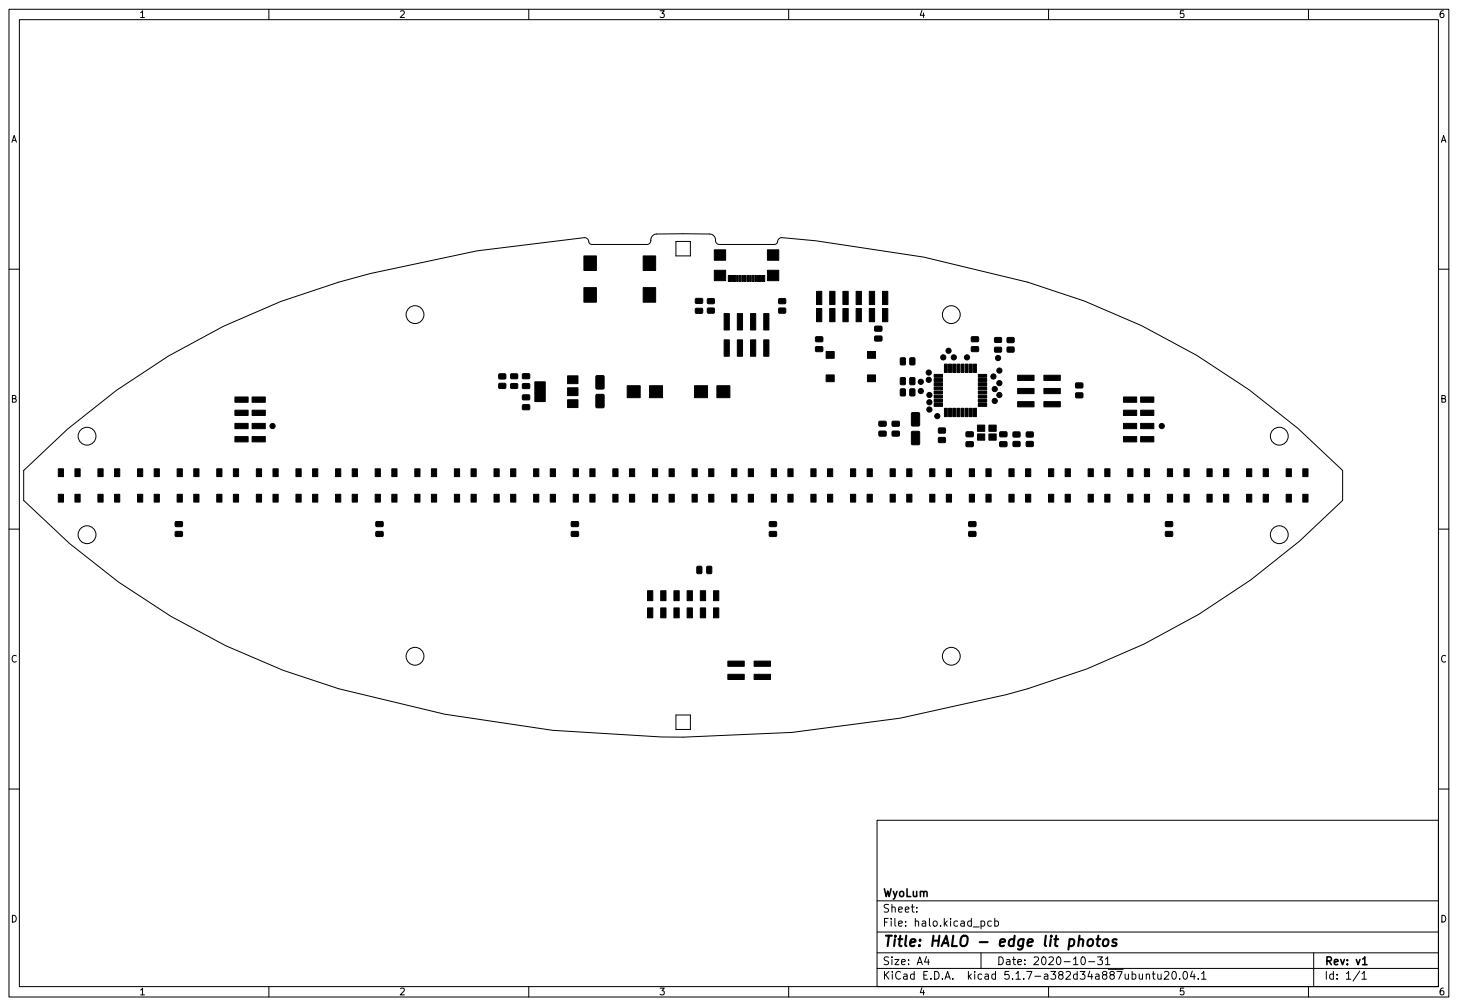
[picture p107: page 1]

File: halo.kicad_pcb Sheet: WyoLum

Id: 1/1 Title: HALO - edge lit photos
