wyolum/halo/kicad_v1/PDF/halo.pdf

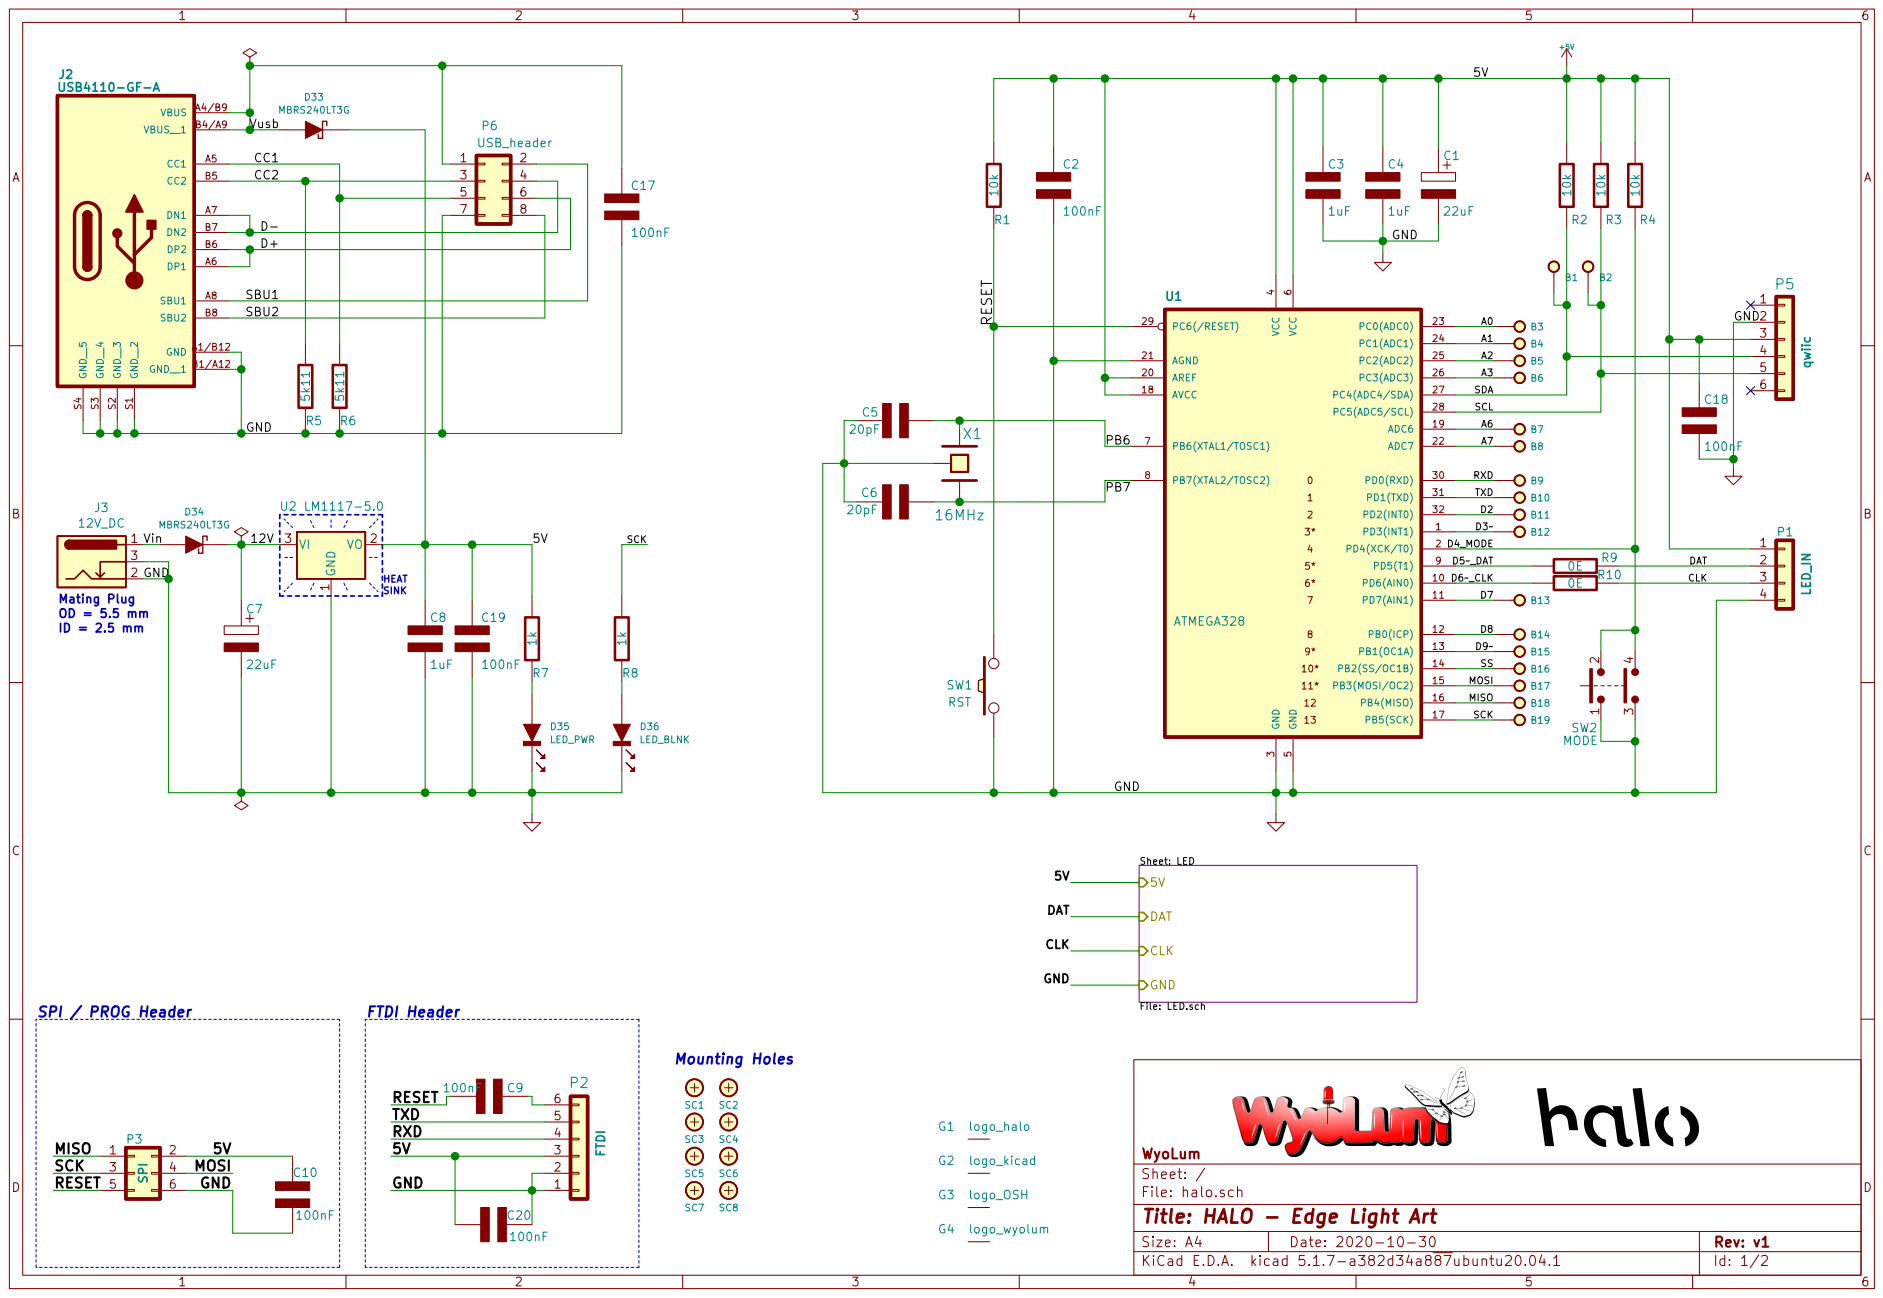
[picture p109: page 1]

FTDI Header HEAT SINK SPI / PROG Header
Mating Plug OD = 5.5 mm

Id: 1/2 Title: HALO - Edge Light Art File: halo.sch Sheet: / WyoLum

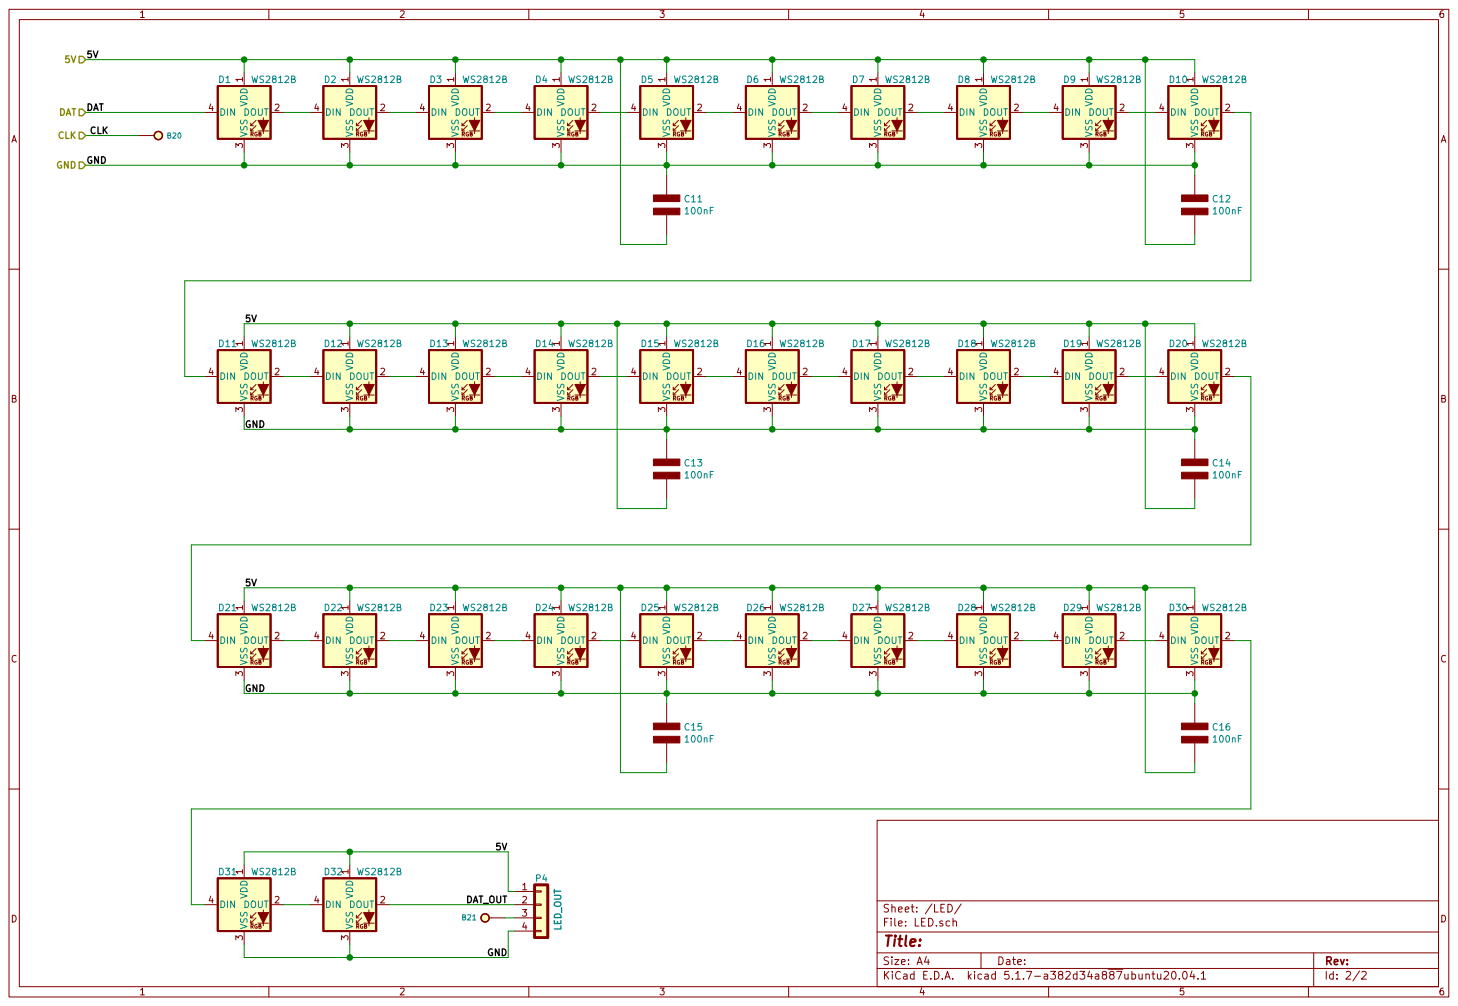
[picture p110: page 2]

3 DIN 4 D26 WS2812B
Id: 2/2 Title: File: LED.sch Sheet: /LED/ RGB VDD
