wyolum/halo/kicad_v3/halo.kicad_pcb

## KiCad design kicad_v3/halo.kicad_pcb (2020-12-30)

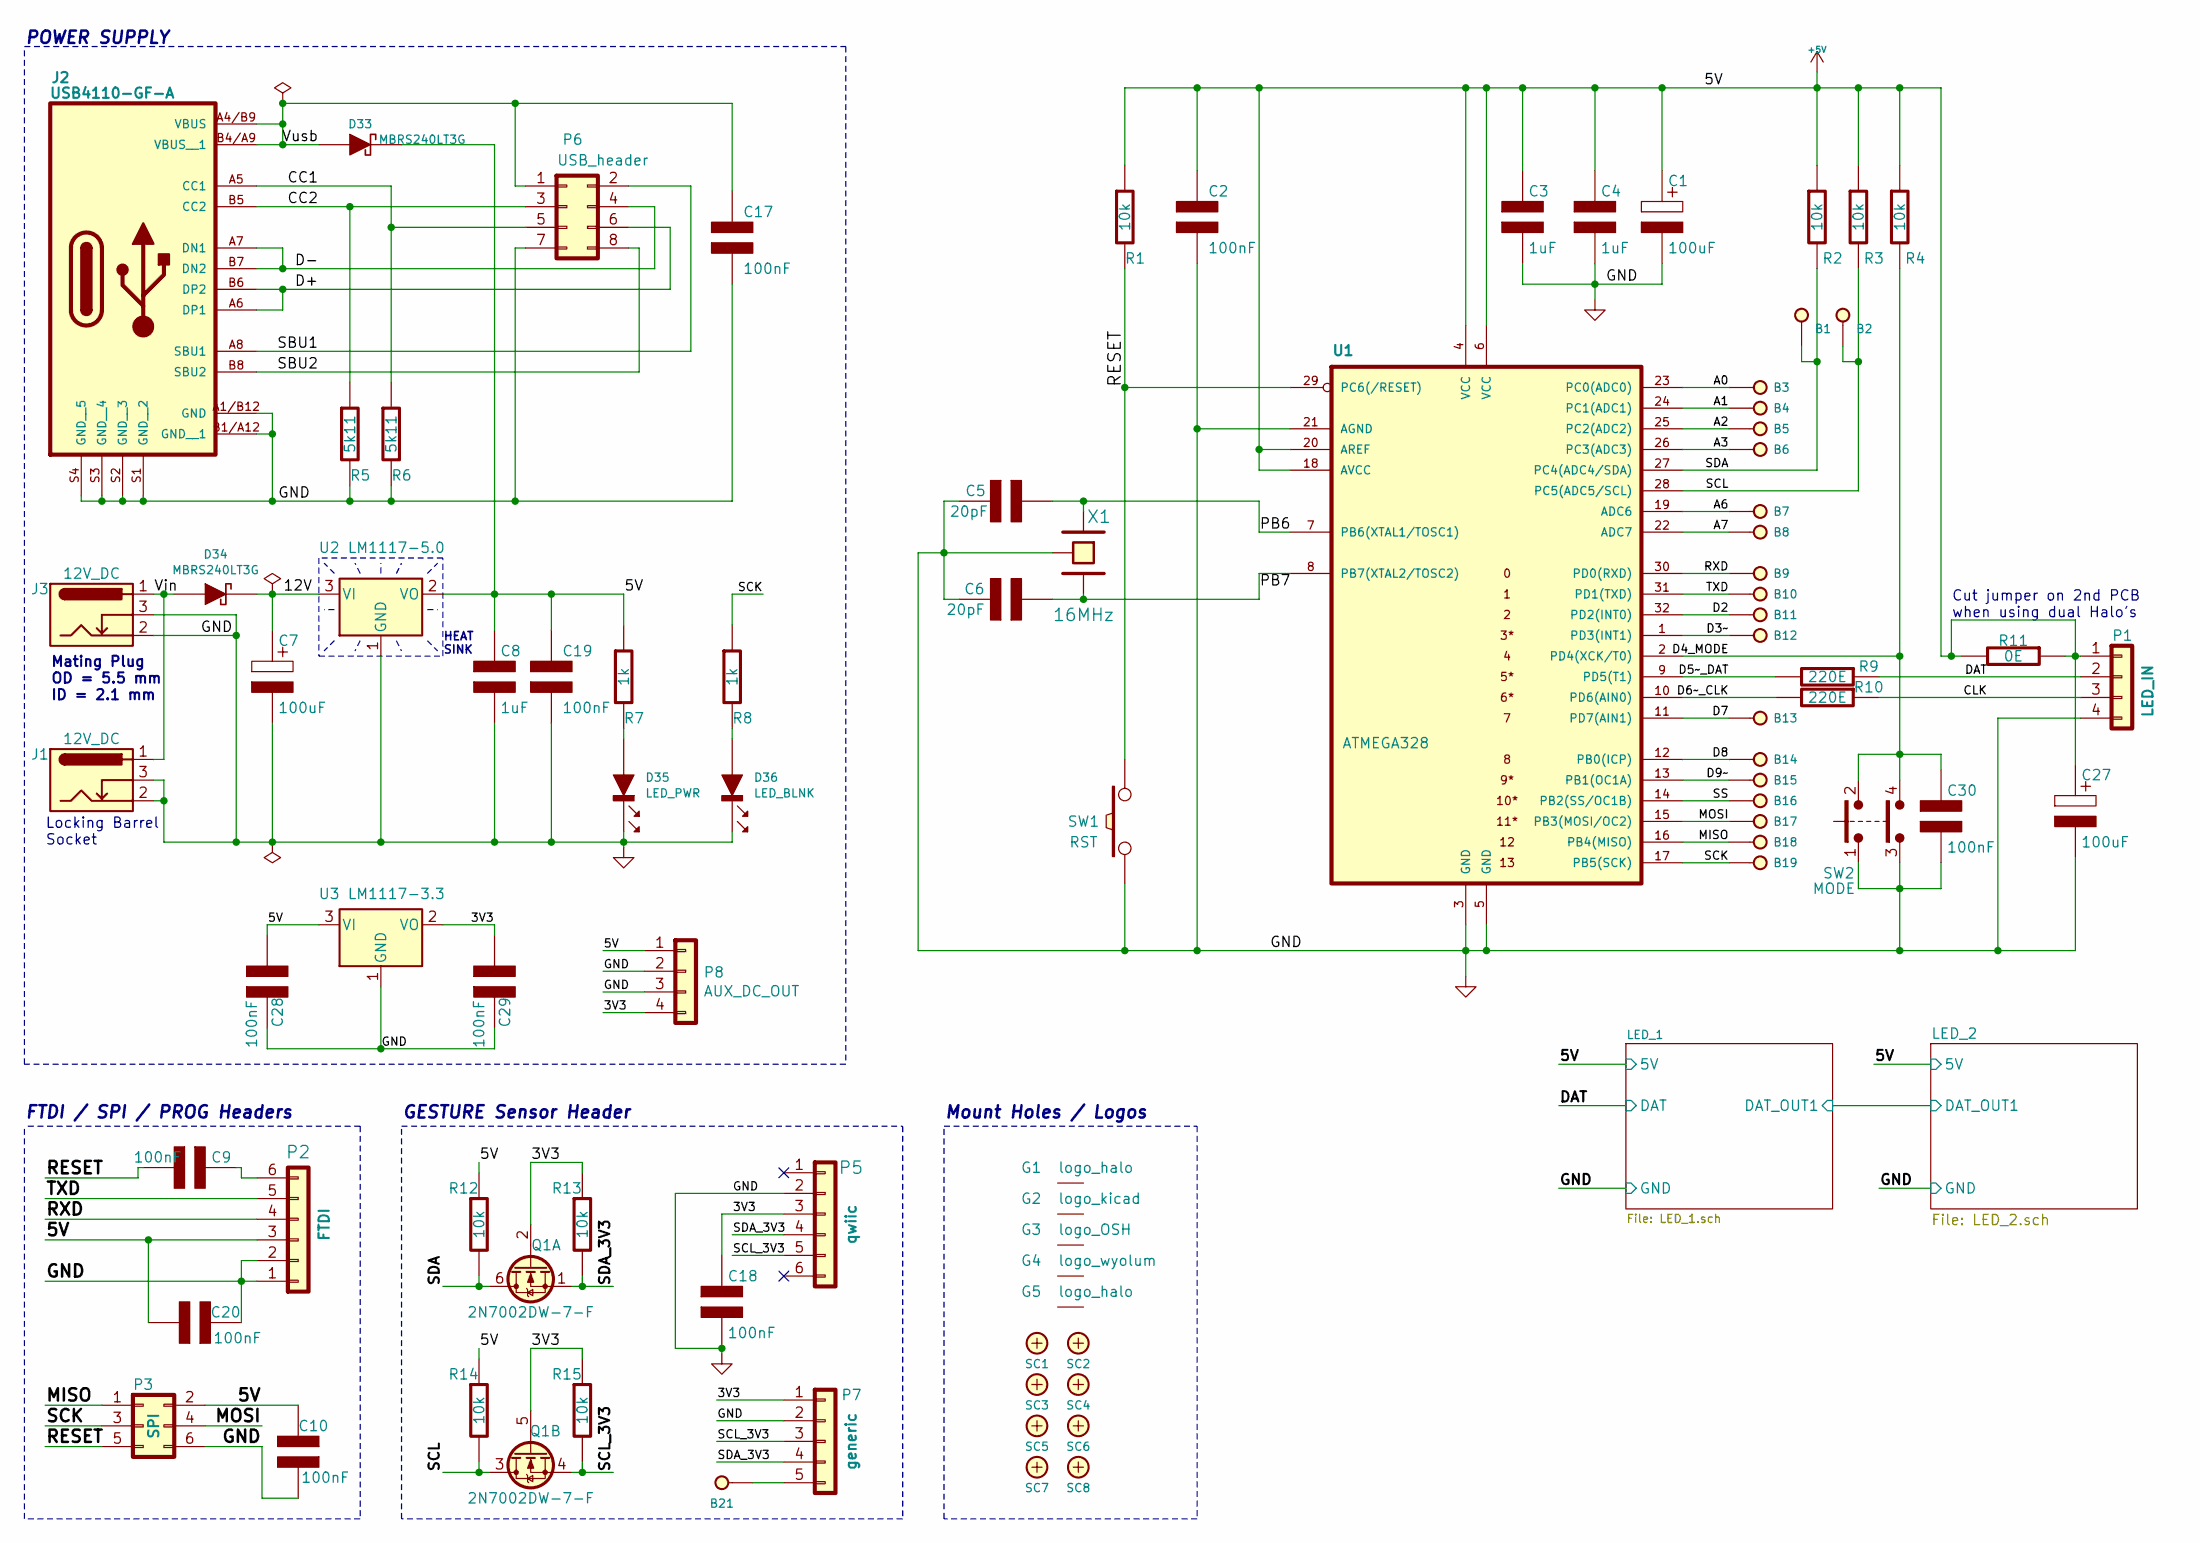
[picture p111: schematic halo.sch, HALO - Edge Light Art]

Parts:
B1, B2, B3, B4, B5, B6, B7, B8, B9, B10, B11, B12, B13, B14, B15, B16, B17, B18, B19, B21: I_O; breakout_smd
C1, C7, C27: 100uF; CP_Elec_6.3x7.7
C2, C9, C10, C17, C18, C19, C20, C28, C29, C30: 100nF; C_0805_2012Metric
C3, C4, C8: 1uF; C_0805_2012Metric
C5, C6: 20pF; C_0805_2012Metric; Digikey 490-1734-1-ND
D33, D34: MBRS240LT3G; D_SMB
D35: LED_PWR; LED_0805_2012Metric
D36: LED_BLNK; LED_0805_2012Metric
G1: logo_halo
G2: logo_kicad; logo_KiCad_12mm_SilkScreen
G3: logo_OSH; logo_OSHW_11.4x12mm_SilkScreen
G4: logo_wyolum
G5: logo_halo; logo_halo_10mm
J1: 12V_DC; conn_barrel
J2: USB4110-GF-A; GCT_USB4110-GF-A; PARTREV A
J3: 12V_DC; barrel_jack_DC-005-5A-2_5-SMT
P1: LED_IN; PinSocket_1x04_P2.54mm_Vertical_SMD_Pin1Left
P2: FTDI; PinHeader_1x06_P2.54mm_Vertical_SMD_Pin1Left
P3: SPI; TC2030-IDC
P5: qwiic; sparkfun_apds_9960_smd
P6: USB_header; PinHeader_2x04_P2.54mm_Vertical_SMD
P7: generic; generic_apds_9960_smd
P8: AUX_DC_OUT; PinSocket_1x04_P2.54mm_Vertical_SMD_Pin1Left
Q1: 2N7002DW-7-F; SOT-363_SC-70-6
R1, R2, R3, R4, R12, R13, R14, R15: 10k; R_0805_2012Metric
R5, R6: 5k11; R_0805_2012Metric
R7, R8: 1k; R_0805_2012Metric
R9, R10: 220E; R_0805_2012Metric
R11: 0E; R_0805_2012Metric
SC1, SC2, SC3, SC4, SC5, SC6, SC7, SC8: SCREW; MountingHole_3.2mm_M3_Pad_Via
SW1: RST; SW_Push_1P1T_NO_6x6mm_H9.5mm
SW2: MODE; PinHeader_2x02_P2.54mm_Vertical_SMD
U1: ATMEGA328; TQFP-32_7x7mm_P0.8mm
U2: LM1117-5.0; SOT-223-3_TabPin2
U3: LM1117-3.3; SOT-223-3_TabPin2
X1: 16MHz; Crystal_SMD_3225-4Pin_3.2x2.5mm

Connections:
+5V: C1.1, C2.1, C3.1, C4.1, C8.1, C10.2, C19.1, C20.1, C27.1, C28.1, D33.K, P1.1, P2.3, P3.2, P8.1, R1.1, R2.1, R3.1, R4.1, R7.1, R11.1, R11.2, R12.1, R14.1, U1.4 (VCC), U1.6 (VCC), U1.18 (AVCC), U1.20 (AREF), U2.2 (VO), U3.3 (VI); also elsewhere on the board
/3V3: C18.1, C29.1, P5.3, P7.1, P8.4, Q1.2 (G), Q1.5 (G), R13.1, R15.1, U3.2 (VO)
/12V: C7.1, D34.K, U2.3 (VI)
/A0: B3.1, U1.23 (PC0(ADC0))
/A1: B4.1, U1.24 (PC1(ADC1))
/A2: B5.1, U1.25 (PC2(ADC2))
/A3: B6.1, U1.26 (PC3(ADC3))
/A6: B7.1, U1.19 (ADC6)
/A7: B8.1, U1.22 (ADC7)
/CC1: J2.A5 (CC1), P6.5, R6.1
/CC2: J2.B5 (CC2), P6.3, R5.1
/CLK: P1.3, R10.1
/D2: B11.1, U1.32 (PD2(INT0))
/D3~~: B12.1, U1.1 (PD3(INT1))
/D4_MODE: C30.1, R4.2, SW2.2, SW2.4, U1.2 (PD4(XCK/T0))
/D5~~_DAT: R9.2, U1.9 (PD5(T1))
/D6~~_CLK: R10.2, U1.10 (PD6(AIN0))
/D7: B13.1, U1.11 (PD7(AIN1))
/D8: B14.1, U1.12 (PB0(ICP))
/D9~~: B15.1, U1.13 (PB1(OC1A))
/D+: J2.A6 (DP1), J2.B6 (DP2), P6.6
/D-: J2.A7 (DN1), J2.B7 (DN2), P6.4
/DAT: P1.2, R9.1; also elsewhere on the board
/MISO: B18.1, P3.1, U1.16 (PB4(MISO))
/MOSI: B17.1, P3.4, U1.15 (PB3(MOSI/OC2))
/PB6: C5.1, U1.7 (PB6(XTAL1/TOSC1)), X1.1
/PB7: C6.2, U1.8 (PB7(XTAL2/TOSC2)), X1.3
/RESET: C9.2, P3.5, R1.2, SW1.2, U1.29 (PC6(/RESET))
/RXD: B9.1, P2.4, U1.30 (PD0(RXD))
/SBU1: J2.A8 (SBU1), P6.2
/SBU2: J2.B8 (SBU2), P6.8
/SCK: B19.1, P3.3, R8.1, U1.17 (PB5(SCK))
/SCL: B2.1, Q1.3 (D), R3.2, R14.2, U1.28 (PC5(ADC5/SCL))
/SCL_3V3: P5.5, P7.3, Q1.4 (S), R15.2
/SDA: B1.1, Q1.6 (D), R2.2, R12.2, U1.27 (PC4(ADC4/SDA))
/SDA_3V3: P5.4, P7.4, Q1.1 (S), R13.2
/SS: B16.1, U1.14 (PB2(SS/OC1B))
/TXD: B10.1, P2.5, U1.31 (PD1(TXD))
/Vin: D34.A, J1.1, J3.1
/Vusb: C17.1, D33.A, J2.A4/B9 (VBUS), J2.B4/A9 (VBUS__1), P6.1
GND: C1.2, C2.2, C3.2, C4.2, C5.2, C6.1, C7.2, C8.2, C10.1, C17.2, C18.2, C19.2, C20.2, C27.2, C28.2, C29.2, C30.2, D35.K, D36.K, J1.2, J1.3, J2.A1/B12 (GND), J2.B1/A12 (GND__1), J2.S1 (GND__2), J2.S2 (GND__3), J2.S3 (GND__4), J2.S4 (GND__5), J3.2, J3.3, P1.4, P2.1, P2.2, P3.6, P5.2, P6.7, P7.2, P8.2, P8.3, R5.2, R6.2, SW1.1, SW2.1, SW2.3, U1.3 (GND), U1.5 (GND), U1.21 (AGND), U2.1 (GND), U3.1 (GND), X1.GND; also elsewhere on the board
unnamed: B21.1, P7.5
unnamed: C9.1, P2.6
unnamed: D35.A, R7.2
unnamed: D36.A, R8.2

Notes on the sheet:
FTDI / SPI / PROG Headers
Mount Holes / Logos
HEAT SINK
Mating Plug OD = 5.5 mm ID = 2.1 mm
Cut jumper on 2nd PCB when using dual Halo's
Locking Barrel Socket
GESTURE Sensor Header
POWER SUPPLY

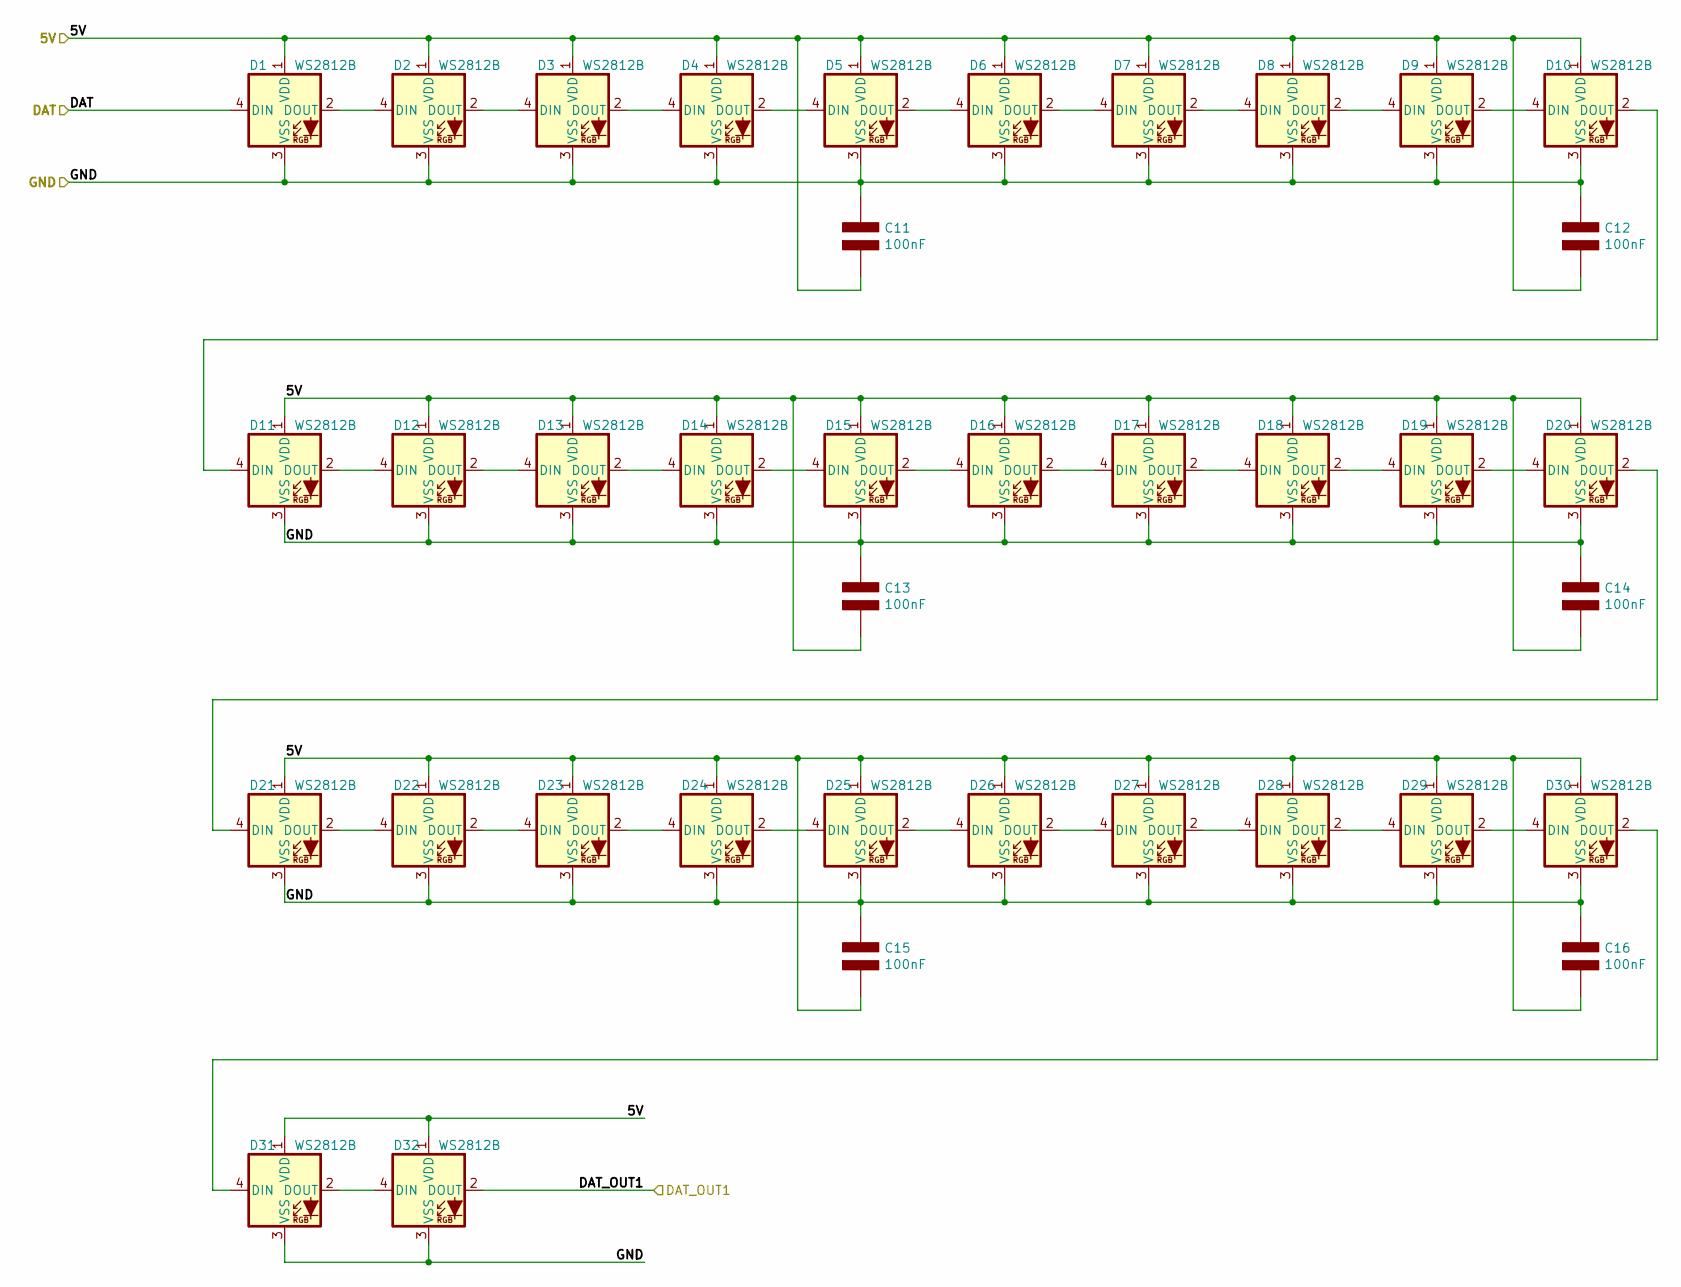
[picture p112: schematic LED_1.sch, HALO - Edge Light Art]

Parts:
C11, C12, C13, C14, C15, C16: 100nF; C_0805_2012Metric
D1, D2, D3, D4, D5, D6, D7, D8, D9, D10, D11, D12, D13, D14, D15, D16, D17, D18, D19, D20, D21, D22, D23, D24, D25, D26, D27, D28, D29, D30, D31, D32: WS2812B; LED_WS2812B_PLCC4_5.0x5.0mm_P3.2mm

Connections:
+5V: C11.2, C12.2, C13.2, C14.2, C15.2, C16.2, D1.1 (VDD), D2.1 (VDD), D3.1 (VDD), D4.1 (VDD), D5.1 (VDD), D6.1 (VDD), D7.1 (VDD), D8.1 (VDD), D9.1 (VDD), D10.1 (VDD), D11.1 (VDD), D12.1 (VDD), D13.1 (VDD), D14.1 (VDD), D15.1 (VDD), D16.1 (VDD), D17.1 (VDD), D18.1 (VDD), D19.1 (VDD), D20.1 (VDD), D21.1 (VDD), D22.1 (VDD), D23.1 (VDD), D24.1 (VDD), D25.1 (VDD), D26.1 (VDD), D27.1 (VDD), D28.1 (VDD), D29.1 (VDD), D30.1 (VDD), D31.1 (VDD), D32.1 (VDD); also elsewhere on the board
/DAT: D1.4 (DIN); also elsewhere on the board
/LED_1/DAT_OUT1: D32.2 (DOUT); also elsewhere on the board
GND: C11.1, C12.1, C13.1, C14.1, C15.1, C16.1, D1.3 (VSS), D2.3 (VSS), D3.3 (VSS), D4.3 (VSS), D5.3 (VSS), D6.3 (VSS), D7.3 (VSS), D8.3 (VSS), D9.3 (VSS), D10.3 (VSS), D11.3 (VSS), D12.3 (VSS), D13.3 (VSS), D14.3 (VSS), D15.3 (VSS), D16.3 (VSS), D17.3 (VSS), D18.3 (VSS), D19.3 (VSS), D20.3 (VSS), D21.3 (VSS), D22.3 (VSS), D23.3 (VSS), D24.3 (VSS), D25.3 (VSS), D26.3 (VSS), D27.3 (VSS), D28.3 (VSS), D29.3 (VSS), D30.3 (VSS), D31.3 (VSS), D32.3 (VSS); also elsewhere on the board
unnamed: D1.2 (DOUT), D2.4 (DIN)
unnamed: D2.2 (DOUT), D3.4 (DIN)
unnamed: D3.2 (DOUT), D4.4 (DIN)
unnamed: D4.2 (DOUT), D5.4 (DIN)
unnamed: D5.2 (DOUT), D6.4 (DIN)
unnamed: D6.2 (DOUT), D7.4 (DIN)
unnamed: D7.2 (DOUT), D8.4 (DIN)
unnamed: D8.2 (DOUT), D9.4 (DIN)
unnamed: D10.2 (DOUT), D11.4 (DIN)
unnamed: D9.2 (DOUT), D10.4 (DIN)
unnamed: D11.2 (DOUT), D12.4 (DIN)
unnamed: D12.2 (DOUT), D13.4 (DIN)
unnamed: D13.2 (DOUT), D14.4 (DIN)
unnamed: D14.2 (DOUT), D15.4 (DIN)
unnamed: D15.2 (DOUT), D16.4 (DIN)
unnamed: D16.2 (DOUT), D17.4 (DIN)
unnamed: D17.2 (DOUT), D18.4 (DIN)
unnamed: D18.2 (DOUT), D19.4 (DIN)
unnamed: D19.2 (DOUT), D20.4 (DIN)
unnamed: D20.2 (DOUT), D21.4 (DIN)
unnamed: D21.2 (DOUT), D22.4 (DIN)
unnamed: D22.2 (DOUT), D23.4 (DIN)
unnamed: D23.2 (DOUT), D24.4 (DIN)
unnamed: D24.2 (DOUT), D25.4 (DIN)
unnamed: D25.2 (DOUT), D26.4 (DIN)
unnamed: D26.2 (DOUT), D27.4 (DIN)
unnamed: D27.2 (DOUT), D28.4 (DIN)
unnamed: D28.2 (DOUT), D29.4 (DIN)
unnamed: D29.2 (DOUT), D30.4 (DIN)
unnamed: D30.2 (DOUT), D31.4 (DIN)
unnamed: D31.2 (DOUT), D32.4 (DIN)

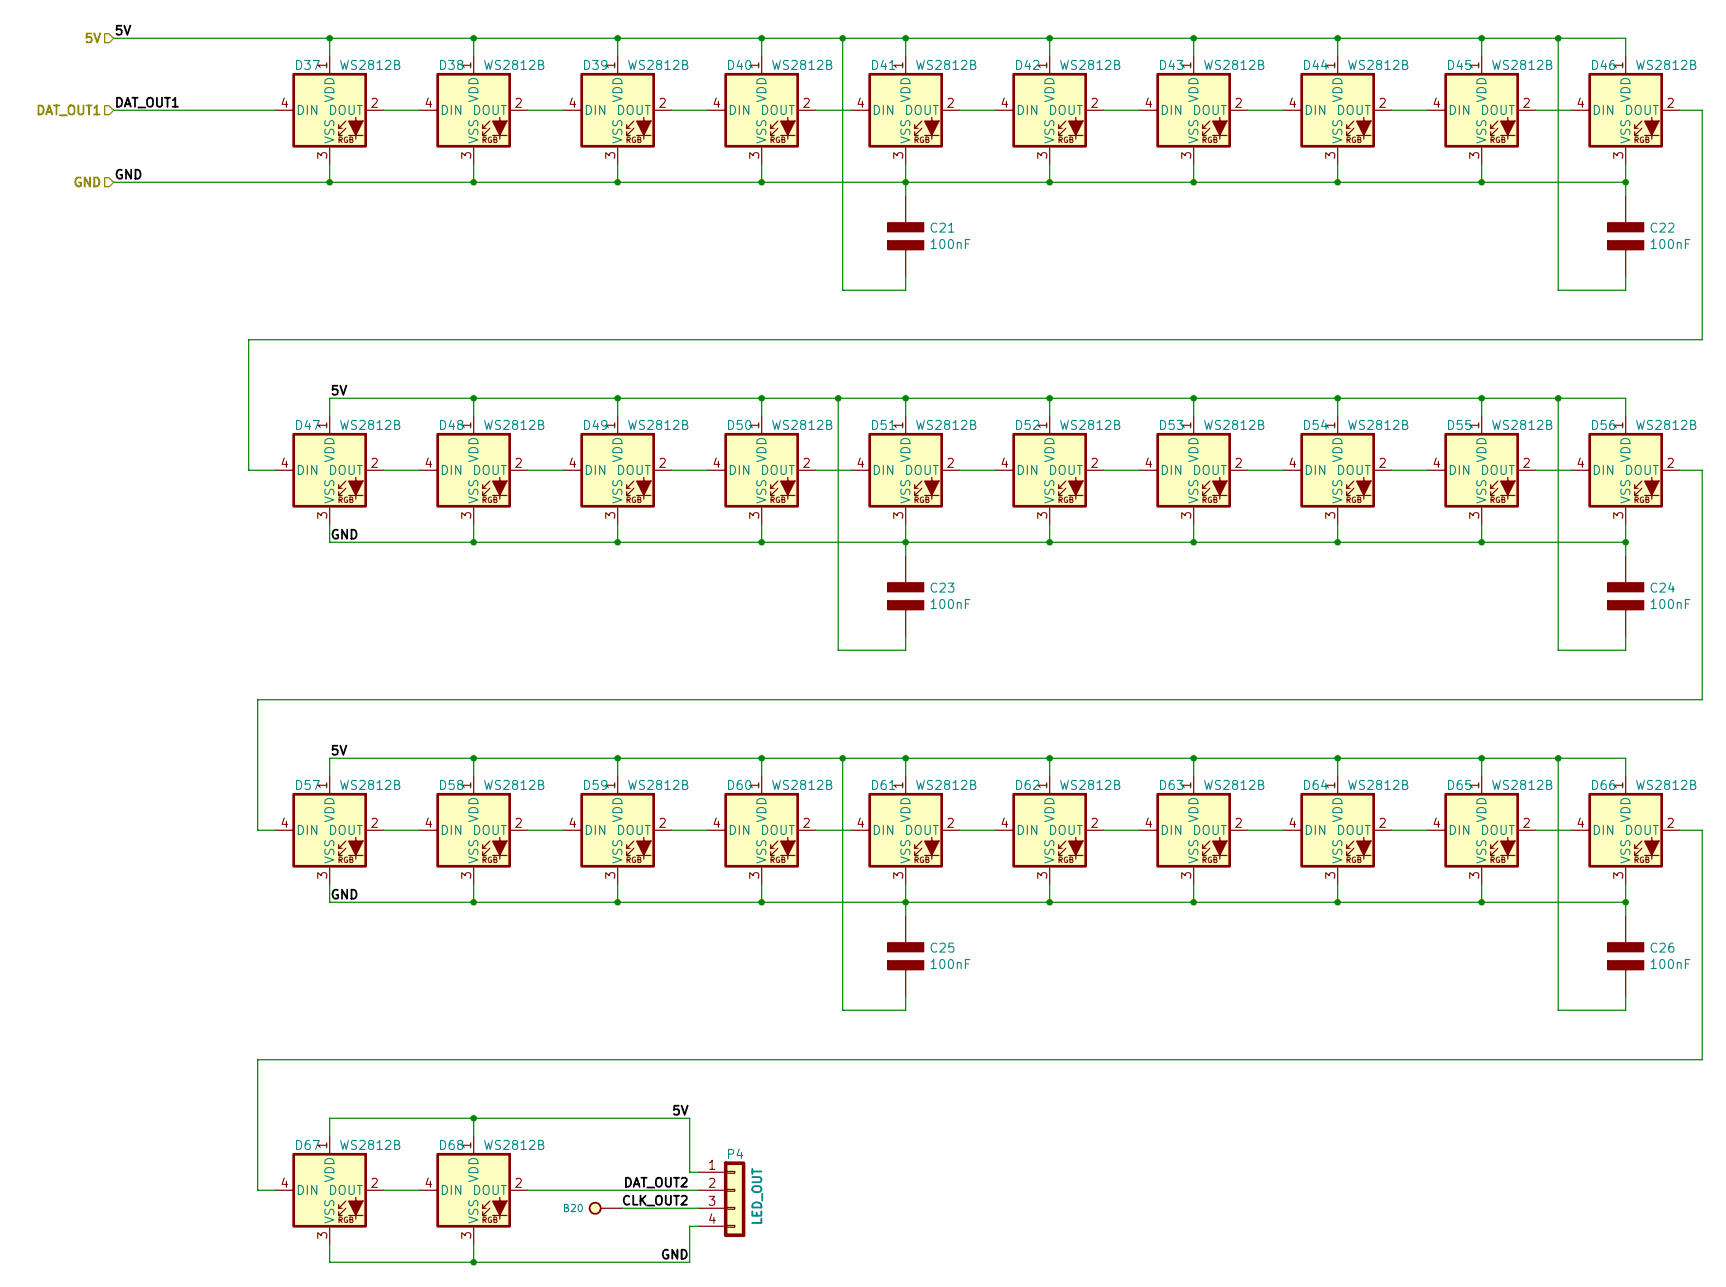
[picture p113: schematic LED_2.sch, HALO - Edge Light Art]

Parts:
B20: I_O; breakout_smd
C21, C22, C23, C24, C25, C26: 100nF; C_0805_2012Metric
D37, D38, D39, D40, D41, D42, D43, D44, D45, D46, D47, D48, D49, D50, D51, D52, D53, D54, D55, D56, D57, D58, D59, D60, D61, D62, D63, D64, D65, D66, D67, D68: WS2812B; LED_WS2812B_PLCC4_5.0x5.0mm_P3.2mm
P4: LED_OUT; PinSocket_1x04_P2.54mm_Vertical_SMD_Pin1Left

Connections:
+5V: C21.2, C22.2, C23.2, C24.2, C25.2, C26.2, D37.1 (VDD), D38.1 (VDD), D39.1 (VDD), D40.1 (VDD), D41.1 (VDD), D42.1 (VDD), D43.1 (VDD), D44.1 (VDD), D45.1 (VDD), D46.1 (VDD), D47.1 (VDD), D48.1 (VDD), D49.1 (VDD), D50.1 (VDD), D51.1 (VDD), D52.1 (VDD), D53.1 (VDD), D54.1 (VDD), D55.1 (VDD), D56.1 (VDD), D57.1 (VDD), D58.1 (VDD), D59.1 (VDD), D60.1 (VDD), D61.1 (VDD), D62.1 (VDD), D63.1 (VDD), D64.1 (VDD), D65.1 (VDD), D66.1 (VDD), D67.1 (VDD), D68.1 (VDD), P4.1; also elsewhere on the board
/LED_1/DAT_OUT1: D37.4 (DIN); also elsewhere on the board
/LED_2/CLK_OUT2: B20.1, P4.3
/LED_2/DAT_OUT2: D68.2 (DOUT), P4.2
GND: C21.1, C22.1, C23.1, C24.1, C25.1, C26.1, D37.3 (VSS), D38.3 (VSS), D39.3 (VSS), D40.3 (VSS), D41.3 (VSS), D42.3 (VSS), D43.3 (VSS), D44.3 (VSS), D45.3 (VSS), D46.3 (VSS), D47.3 (VSS), D48.3 (VSS), D49.3 (VSS), D50.3 (VSS), D51.3 (VSS), D52.3 (VSS), D53.3 (VSS), D54.3 (VSS), D55.3 (VSS), D56.3 (VSS), D57.3 (VSS), D58.3 (VSS), D59.3 (VSS), D60.3 (VSS), D61.3 (VSS), D62.3 (VSS), D63.3 (VSS), D64.3 (VSS), D65.3 (VSS), D66.3 (VSS), D67.3 (VSS), D68.3 (VSS), P4.4; also elsewhere on the board
unnamed: D37.2 (DOUT), D38.4 (DIN)
unnamed: D38.2 (DOUT), D39.4 (DIN)
unnamed: D39.2 (DOUT), D40.4 (DIN)
unnamed: D40.2 (DOUT), D41.4 (DIN)
unnamed: D41.2 (DOUT), D42.4 (DIN)
unnamed: D42.2 (DOUT), D43.4 (DIN)
unnamed: D43.2 (DOUT), D44.4 (DIN)
unnamed: D44.2 (DOUT), D45.4 (DIN)
unnamed: D45.2 (DOUT), D46.4 (DIN)
unnamed: D46.2 (DOUT), D47.4 (DIN)
unnamed: D47.2 (DOUT), D48.4 (DIN)
unnamed: D48.2 (DOUT), D49.4 (DIN)
unnamed: D49.2 (DOUT), D50.4 (DIN)
unnamed: D50.2 (DOUT), D51.4 (DIN)
unnamed: D51.2 (DOUT), D52.4 (DIN)
unnamed: D52.2 (DOUT), D53.4 (DIN)
unnamed: D53.2 (DOUT), D54.4 (DIN)
unnamed: D54.2 (DOUT), D55.4 (DIN)
unnamed: D55.2 (DOUT), D56.4 (DIN)
unnamed: D56.2 (DOUT), D57.4 (DIN)
unnamed: D57.2 (DOUT), D58.4 (DIN)
unnamed: D58.2 (DOUT), D59.4 (DIN)
unnamed: D59.2 (DOUT), D60.4 (DIN)
unnamed: D60.2 (DOUT), D61.4 (DIN)
unnamed: D61.2 (DOUT), D62.4 (DIN)
unnamed: D62.2 (DOUT), D63.4 (DIN)
unnamed: D63.2 (DOUT), D64.4 (DIN)
unnamed: D64.2 (DOUT), D65.4 (DIN)
unnamed: D65.2 (DOUT), D66.4 (DIN)
unnamed: D66.2 (DOUT), D67.4 (DIN)
unnamed: D67.2 (DOUT), D68.4 (DIN)

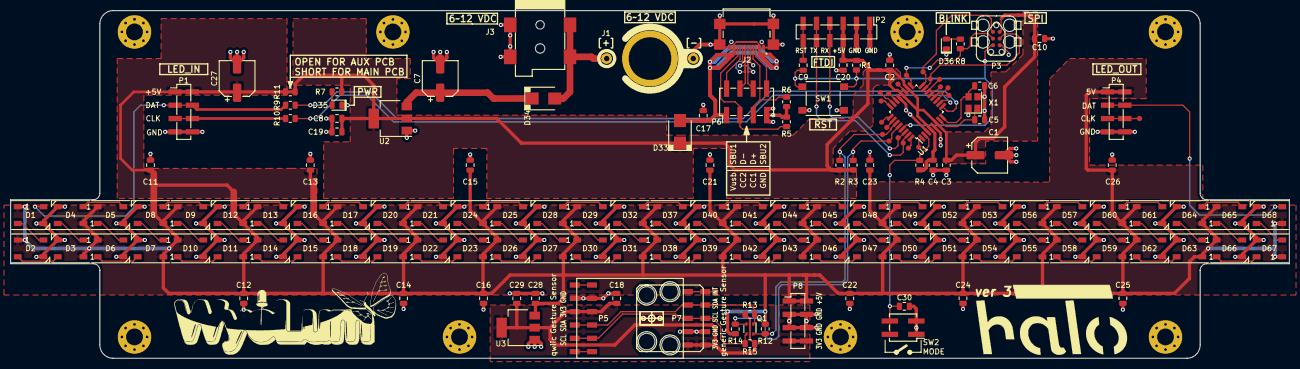
[picture p114: board halo.kicad_pcb from above]

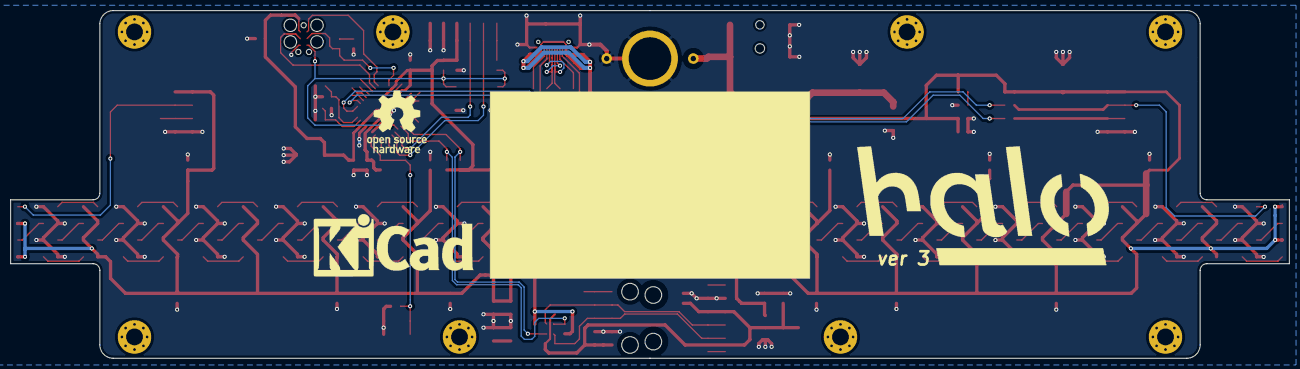
[picture p115: board halo.kicad_pcb from below]

Board: 2 copper layers, 243.8 x 66.3 mm, 165 parts (3 on the bottom side), 110 nets.
