wyolum/halo/(commit log)

2020-10-28 added 3D FreeCAD case
    [LED.FCStd, WS2812 60 per meter strip.stp, WS2812x30.step, halo_base.FCStd, halo_base_BAK.FCStd]
2020-10-31 added kicad schematic
    [LED.sch, halo.kicad_pcb, halo.kicad_sch, halo.sch, halo_01.FCStd]
2020-10-31 added kicad PCB wip
    [CUI_DEVICES_PJ-036AH-SMT-TR.step, CUI_DEVICES_PJ_036AH_SMT.step, LED.sch, halo.kicad_pcb]
2020-10-31 added qwiic I2C conn for ToF sensor
    [LED.sch, halo.kicad_pcb, halo.sch]
2020-11-01 added PCB review needed
    [APDS-9960.SLDPRT, APDS-9960.STL, APDS-9960_RGB_and_Gesture_Sensor-v10.stl, CP_Elec_4x58.step, CUI_DEVICES_PJ_036AH_SMT.step, C_0805_2012Metric.step, D_SMA.step, D_SMB.step]
2020-11-03 Gerber BoM ready
    [APDS-9960.SLDPRT, APDS-9960.STL, APDS-9960_RGB_and_Gesture_Sensor-v10.stl, CUI_DEVICES_PJ-036AH-SMT-TR.step, CUI_DEVICES_PJ_036AH_SMT.step, K3D-DX07S024JA1-V3_JAE_Proprietary.STEP, K3D-DX07S024JA2-V1_JAE_Proprietary.STEP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]
2020-11-05 Gerber BoM Position files for JLCpcb
    [LED.sch, USB4110-GF-A--3DModel-STEP-56544.STEP, USB4110-GF-A.step, USB4110_GF_A018.step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]
2020-11-24 added gesture sensor
2020-11-28 add pcb trace
2020-11-30 added gesture sensor standoff
    [standoff.scad]
2020-12-10 halo_v2 WIP
    [APDS-9960.SLDPRT, APDS-9960.STL, APDS-9960_RGB_and_Gesture_Sensor-v10.stl, CP_Elec_4x58.step, C_0805_2012Metric.step, D_SMA.step, D_SMB.step, D_SMC.step]
2020-12-13 halo_v2 almost done
    [CP_Elec_10x10.5.step, CP_Elec_6.3x7.7.step, CUI_DEVICES_PJ-065B.step, Crystal_SMD_3225-4Pin_3.2x2.5mm.step, D_SMB.step, LED.sch, SW_SPST_PTS645.step, conn_barrel.step]
2020-12-13 halo_v2 JLCpcb files ready
    [halo-B_Cu.gbr, halo-B_Mask.gbr, halo-B_Paste.gbr, halo-B_SilkS.gbr, halo-Edge_Cuts.gbr, halo-F_Cu.gbr, halo-F_Mask.gbr, halo-F_Paste.gbr]
2020-12-13 halo_v2 added enclosure laser and 3DP files
    [ACR_bottom_2D.dxf, ACR_top_back_2D.dxf, ACR_top_front_2D.dxf, ACR_wall_back_2D.dxf, ACR_wall_front_2D.dxf, Corner_back_left.stl, Corner_back_left_circle.stl, Corner_back_left_hex.stl]
2020-12-17 halo_v2 modified 3D print corners
    [Corner_back_left.stl, Corner_back_right.stl, Corner_front_left.stl, Corner_front_right.stl]
2020-12-25 halo_v3 added renders
    [APDS-9960.SLDPRT, APDS-9960.STL, APDS-9960_RGB_and_Gesture_Sensor-v10.stl, CP_Elec_10x10.5.step, CP_Elec_4x58.step, CP_Elec_6.3x7.7.step, C_0805_2012Metric.step, Crystal_SMD_3225-4Pin_3.2x2.5mm.step]
2020-12-30 add whole case laser cutting file for V2
2020-12-30 update sparkfun gesture library to support generic boards
2021-01-09 add gesture hole and ftdi opening
2021-01-16 add powertest
2021-01-24 halo_v3 added springy wedge corner pieces
    [ACR_main_2D.dxf, Corner_left_springy_wedge.stl, Corner_set_springy_wedge.stl, Corners_set_springy.stl, Corners_set_springy_pair.stl]
2021-08-10 Added Halov2.1 that inlcludes two rows of leds
2022-10-02 added files for 'NOT A MAP'
    [endcaps.scad]
